lovely009/robot2_ws/ros2_ws/src/robot_description/models/half_body_robot/cad/frames/motor_frames.csv

frame | motor_id | parent | model | status | parent_xyz | parent_rpy | parent_outward_z | base_xyz | base_outward_z | observed_holes | measured_pcd_mm | pcd_error_mm | fit_residual_mm | joint | flange_center_to_joint_axis_mm | axis_angle_deg | axial_offset_mm | outward_vs_joint_sign | clocking_status | encoder_zero | command_direction
motor_01_mount_reference | 1 | base_link | r48 | bolt_circle_verified | [0.06399999999999999, 0.0655, 0.6790000000000002] | [0.0, 0.0, 0.3926981465394346] | [0.0, 0.0, 1.0] | [0.06399999999999999, 0.0655, 0.6790000000000002] | [0.0, 0.0, 1.0] | 8 | 40.500009306216086 | 9.306216082471952e-06 | 4.65310804817487e-06 | joint_link1 | 1.3877787807814457e-14 | 0.0 | -0.300000000000189 | -1 | locator_verified | unverified | unverified
motor_02_mount_reference | 2 | base_link | r48 | bolt_circle_verified | [0.08820000000000003, 0.043000000000000003, 0.5964999859746587] | [-1.5707963267948968, 0.3926982670535939, -1.5707963267948966] | [1.0, 0.0, 0.0] | [0.08820000000000003, 0.043000000000000003, 0.5964999859746587] | [1.0, 0.0, 0.0] | 8 | 40.50000298210565 | 2.982105645754629e-06 | 1.2534288506421687e-05 | joint_link2 | 104.13046176755344 | 87.8887432543599 | -9.423835114816384 | 1 | locator_verified | unverified | unverified
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
