lovely009/robot2_ws/docs/巨蟹电机/CERB巨蟹智能-CANopen-V0.9字典表.xlsx

Sheet: 字典表
--- | 参数字典 | 参数名称 | 主索引 | 子索引 | 权限 | 数据类型 | 默认值（十进制） | 最小值 | 最大值 | 单位 | 说明
0 | Can Node ID | CAN节点ID | 0x2530 | 0x00 | RW | UINT32 | 1 | 1 | 127 | - | 修改完成后需要重启生效;
1 | Can Baudrate | CAN数据段通讯波特率 | 0x2540 | 0x00 | RW | UINT32 | 1 | 1 | 3 | - | 说明：1-5M，2-4M，3-2M，4-1M;
2 | Zero set | 设置电机输出端零位 | 0x2531 | 0x00 | RW | UINT32 | 0 | 0 | 2 | - | 写入零位是电机需要在去使能的状态，写1时设置零位
3 | TorqueFlux_P | 电流环P参数 | 0x2532 | 0x00 | RW | UINT32 | - | 0 | 32768 | -
4 | TorqueFlux_I | 电流环I参数 | 0x2533 | 0x00 | RW | UINT32 | - | 0 | 32768 | -
5 | Velocity_P | 速度环P参数 | 0x2534 | 0x00 | RW | UINT32 | - | 0 | 32768 | -
6 | Velocity_I | 速断环I参数 | 0x2535 | 0x00 | RW | UINT32 | - | 0 | 32768 | -
7 | Position_P | 位置环P参数 | 0x2536 | 0x00 | RW | UINT32 | - | 0 | 32768 | -
8 | Position_I | 位置环I参数 | 0x2537 | 0x00 | RW | UINT32 | - | 0 | 32768 | -
9 | maxTorque | 电机峰值电流 | 0x2538 | 0x00 | RW | UINT32 | - | 0 | 32768 | mA
10 | Flash cobe | Flash保存参数代码 | 0x2539 | 0x00 | RW | UINT32 | 0 | 0 | 4294967295 | - | 说明：1-断电保存设置的电机参数 2-设置电机正限位 4-设置电机负限位
11 | Motion_dir | 电机方向定义 | 0x2541 | 0x00 | RW | UINT32 | 0 | 1 | 0 |  | 说明：0-CW，1-CCW
12 | MOS_Temper | 驱动器温度 | 0x2662 | 0x00 | RO | UINT32 | - | -400 | 1500 | 0.1°
13 | Motor_Temper | 电机线圈温度 | 0x2663 | 0x00 | RO | UINT32 | - | -400 | 1500 | 0.1°
14 | Error Code | 错误码 | 0x603F | 0x00 | RO | UNS16 | 0 | 0 | 65535 | - | 参考错误代码表
15 | DS402 Controlword | 402控制字 | 0x6040 | 0x00 | RW | UNS16 | 0 | 0 | 65535 | -
16 | DS402 Statusword | 402状态字 | 0x6041 | 0x00 | RO | UNS16 | 0 | 0 | 65535
17 | Torque Target Value | 电流环目标值 | 0x6071 | 0x00 | RW | INTEGER16 | 0 | -32768 | 32767 | mA
18 | Current Actual Value | 电流当前值 | 0x6078 | 0x00 | RO | INTEGER16 | 0 | -32768 | 32767 | mA
19 | Bus Voltage Actual Value | 母线电压当前值 | 0x6079 | 0x00 | RO | UNS32 | 0 | 0 | 4294967295 | 0.1V
20 | Load Position Target Value | 负载端位置目标值 | 0x607A | 0x00 | RW | INTEGER32 | 0 | -32767 | 32768 | cnt
21 | Load Position Lower Limit | 负载位置下限 | 0x607D | 0x01 | RW | INTEGER32 | -32767 | -32767 | 32768 | cnt
22 | Load Position Upper Limit | 负载位置上限 | 0x607D | 0x02 | RW | INTEGER32 | 32768 | -32767 | 32768 | cnt
23 | Motor Maximum Speed RPM | 电机最大转速/速度(RPM) | 0x6080 | 0x00 | RW | UNS32 | 2000 | 1 | 4294967295 | RPM
24 | Profile Velocity | 负载端轮廓速度 | 0x6081 | 0x00 | RW | UNS32 | 10 | 1 | 40 | RPM | 该改速度为输出端的速度
25 | Profle Acceleration | 轮廓加速度 | 0x6083 | 0x00 | RW | UNS32 | 50 | 1 | 200 | RPM/S
26 | Profile Deceleration | 轮廓减速度 | 0x6084 | 0x00 | RW | UNS32 | 50 | 1 | 200 | RPM/S
27 | Operation Mode Command | 运行模式指令 | 0x6060 | 0x00 | RW | INTEGER8 | 0 | -128 | 127 | - | 说明：1-轮廓位置模式，3-轮廓速度模式，8周期同步位置模式，9周期同步速度模式，10周期同步电流模式
28 | Operation Mode Command display | 当前运行模式指令 | 0x6060 | 0x00 | RW | INTEGER8 | 0 | -128 | 127 | -
29 | Velocity Target Value | 速度目标值 | 0x60FF | 0x00 | RW | INTEGER32 | 0 | -2147483648 | 2147483647 | RPM
30 | Velocity Actual Value | 电机端速度当前值 | 0x606C | 0x00 | RO | INTEGER32 | 0 | -2147483648 | 2147483647 | RPM
31 | Load Position Actual Value | 负裁端位置当前值 | 0x6064 | 0x00 | RO | INTEGER32 | 0 | -32767 | 32768 | cnt
32 | torque actual value | 力矩传感器当前值 | 0x6077 | 0x00 | RO | INTEGER16 | 0 | -32767 | 32768 | 0.01N.m
33 | Load Position Error Value | 负端位置误差值 | 0x60F4 | 0x00 | RO | INTEGER32 | 0 | -32767 | 32768 | cnt

Sheet: 字典操作示例
SDO控制举例,以电机ID为1为例 |  |  |  |  | SDO读取反馈状态举例，以电机ID为1为例
位置模式举例 位置环的速度是减速机的输出端速度 |  |  |  |  | 读取运动状态
使能电机： |  |  |  |  | ID | DLC | Data(HEX) | Description
ID | DLC | Data(HEX) | Description | 范围限制 | 601 | 8 | 40 78 60 00 00 00 00 00 | 读取电机实际电流
601 | 8 | 2B 40 60 00 06 00 00 00 | 准备好启动 |  | 581 | 8 | 4B 78 60 00 94 FE 00 00 | 反馈电机实际电流
601 | 8 | 2B 40 60 00 07 00 00 00 | 松开抱闸 |  | 601 | 8 | 40 64 60 00 00 00 00 00 | 读取电机实际位置
601 | 8 | 2B 40 60 00 0F 00 00 00 | 电机使能激活 |  | 581 | 8 | 43 64 60 00 00 00 00 00 | 反馈电机实际位置
设置运动模式： |  |  |  |  | 601 | 8 | 40 6C 60 00 00 00 00 00 | 读取电机实际速度
601 | 8 | 2F 60 60 00 01 00 00 00 | 设置位置模式 |  | 581 | 8 | 43 6C 60 00 00 00 00 00 | 反馈电机实际速度
设置运动参数： |  |  |  |  | 601 | 8 | 40 6C 60 00 00 00 00 00 | 读取电机实际速度
601 | 8 | 23 83 60 00 D0 07 00 00 | 设置加速度为2000(RPM/S) | 0~10000 | 581 | 8 | 43 6C 60 00 00 00 00 00 | 反馈电机实际速度
601 | 8 | 23 84 60 00 D0 07 00 00 | 设置减速度为2000(RPM/S) | 0~10000 | 601 | 8 | 40 3F 60 00 00 00 00 00 | 读取电机故障
601 | 8 | 23 81 60 00 0A 00 00 00 | 设置速度为10(RPM) | 0~30 | 581 | 8 | 4B 3F 60 00 00 00 00 00 | 反馈电机故障 | 0x0001:过压 0x0002：欠压 0x0004：过温报错 0x0008：堵转 0x0010：过载 0x0020：电流采样错误 0x0040：正限位保护 0x0080：负限位保护 0x0100：编码器通信超时 0x0200：电机超过最大速度 0x0400：上电电角度初始化失败 0x1000：位置误差过大 0x2000：编码器故障
绝对运动： |  |  |  |  | 601 | 8 | 40 41 60 00 00 00 00 00 | 读取电机运动状态
601 | 8 | 23 7A 60 00 00 40 00 00 | 设置目标位置范围 | -32767 ~32768（对应角度-180~180） | 581 | 8 | 4B 41 60 00 00 00 00 00 | 反馈电机运动状态 | 0x0021:准备好启动 0x0023：松开抱闸 0x0027：使能激活 0x0427：运行到位 0x0008：报错状态
601 | 8 | 2B 40 60 00 4F 00 00 00 | 电机开始绝对运动 |  | 601 | 8 | 40 63 26 00 00 00 00 00 | 读取力矩传感器 | 0.001Nm
停止运动： |  |  |  |  | 581 | 8 | 43 63 26 00 1D 00 00 00 | 反馈力矩传感器
601 | 8 | 2B 40 60 00 0F 00 00 00 | 电机停止运动 |  | 601 | 8 | 40 62 26 00 00 00 00 00 | 读取温度传感器
 |  |  |  |  | 581 | 8 | 43 62 26 00 18 01 00 00 | 反馈温度传感器 | 28.0°
速度模式举例 速度环的速度与加速度是电机端的速度
使能电机：
ID | DLC | Data(HEX) | Description
601 | 8 | 2B 40 60 00 06 00 00 00 | 准备好启动
601 | 8 | 2B 40 60 00 07 00 00 00 | 松开抱闸
601 | 8 | 2B 40 60 00 0F 00 00 00 | 电机使能激活
设置运动模式：
601 | 8 | 2F 60 60 00 03 00 00 00 | 设置速度模式
设置运动参数：
601 | 8 | 23 83 60 00 E8 03 00 00 | 设置加速度为1000(RPM/S) | 0~10000
601 | 8 | 23 84 60 00 E8 03 00 00 | 设置减速度为1000(RPM/S) | 0~10000
601 | 8 | 23 FF 60 00 F4 01 00 00 | 设置速度为500(RPM) | -3000~3000
电流模式举例 最大电流建议用默认（与电机峰值电流保持）
使能电机：
ID | DLC | Data(HEX) | Description
601 | 8 | 2B 40 60 00 06 00 00 00 | 准备好启动
601 | 8 | 2B 40 60 00 07 00 00 00 | 松开抱闸
601 | 8 | 2B 40 60 00 0F 00 00 00 | 电机使能激活
设置运动模式：
601 | 8 | 2F 60 60 00 0A 00 00 00 | 设置电流模式
设置运动参数：
601 | 8 | 2B 71 60 00 F4 01 00 00 | 设置目标电流为500(mA) | -10000~10000（根据电机型号）
修改电机ID举例
ID | DLC | Data(HEX) | Description
601 | 8 | 23 30 25 00 05 00 00 00 | 设置电机ID为5
设置电机零位
ID | DLC | Data(HEX) | Description
601 | 8 | 23 31 25 00 01 00 00 00 | 设置零位 | 设置时电机需要在失能状态
设置电机正限位
ID | DLC | Data(HEX) | Description
601 | 8 | 23 39 25 00 02 00 00 00 | 设置正限位 | 设置时电机失能状态，掰到正限位再设置（默认参数：-180到180）
设置电机负限位
ID | DLC | Data(HEX) | Description
601 | 8 | 23 39 25 00 04 00 00 00 | 设置负限位 | 设置时电机失能状态，掰到负限位再设置（默认参数：-180到180）
设置电机电流环P
ID | DLC | Data(HEX) | Description
601 | 8 | 23 32 25 00 00 00 00 00 | 设置电机电流环P
设置电机电流环I
ID | DLC | Data(HEX) | Description
601 | 8 | 23 33 25 00 00 00 00 00 | 设置电机电流环I
设置电机速度环P
ID | DLC | Data(HEX) | Description
601 | 8 | 23 34 25 00 00 00 00 00 | 设置电机速度环P
设置电机速度环I
ID | DLC | Data(HEX) | Description
601 | 8 | 23 35 25 00 00 00 00 00 | 设置电机速度环I
设置电机位置环P
ID | DLC | Data(HEX) | Description
601 | 8 | 23 36 25 00 00 00 00 00 | 设置电机位置环P
设置电机位置环I
ID | DLC | Data(HEX) | Description
601 | 8 | 23 37 25 00 00 00 00 00 | 设置电机位置环I
设置电机最大电流
ID | DLC | Data(HEX) | Description
601 | 8 | 23 38 25 00 00 00 00 00 | 设置电机最大电流
将写入的PI和最大电流保存FLASH
ID | DLC | Data(HEX) | Description
601 | 8 | 23 39 25 00 01 00 00 00 | 写入FLASH
设置心跳
ID | DLC | Data(HEX) | Description
601 | 8 | 2B 17 10 00 D0 07 00 00 | 设置心跳时间2000ms | 设置为0时关闭心跳
关闭看门狗和限位保护
ID | DLC | Data(HEX) | Description
601 | 8 | 23 50 26 00 01 00 00 00 | 关闭看门狗和限位保护
清除错误
ID | DLC | Data(HEX) | Description
601 | 8 | 2B 40 60 00 80 00 00 00 | 清错
说明：标红色字体及为设置的目标值，数据高位在后，低位在前

Sheet: SDO协议内容详解
以主站下发到从站，修改电机ID举例说明
CAN帧 | 字段名称 | 字节长度 | 内容说明
StdID | 设备地址 | 11bit | 600|Dev_ID
DLC | 帧长度 | / | 0x08
[0] | 指令代码 | 16bit | 参考指令代码说明
[1] | 字典索引 | 32bit | 参考字典表
[2]
[3] | 子索引 | 16bit
[4] | 需要修改的DI号 | 32bit | ID的范围为：1~127 数据地位在前，高位在后
[5]
[6]
[7]

Sheet: CANFD的自定义的PDO控制协议
CANFD默认配置为：CANFD加速 标准帧 1M仲裁段 5M数据段
执行器反馈报文
三种方式触发执行器反馈报文： 1、发送同步帧（上位发送同步报文ID：0x80）； 2、执行器多控报文触发执行器的数据反馈； 3、单轴控报文触发执行器的数据反馈；
执行器发给上位机 带力矩传感器
CAN帧 |  | 字段名称 | 字节 | 内容说明（数据）
StdID |  | 设备地址 | 11bit | 0x300|Dev_ID
DLC |  | 帧长度 |  | 16
[0] |  | 负载端实际位置 | 16bit | Byte[0]为高8位，Byte[1]为低8位;[-32768到32767]对应(-180°~ 180°);
[1]
[2] |  | 电机端实际速度 | 16bit | Byte[2]为高8位，Byte[3]为低8位;int16类型[-32768到32767]，单位：RPM;
[3]
[4] |  | 实际电流（Iq） | 16bit | Byte[4]为高8位，Byte[5]为低8位;int16类型[-32768到32767]，单位：mA;
[5]
[6] |  | 错误代码 | 16bit | Byte[6]为高8位，Byte[7]为低8位;参考报错代码表
[7]
[8] |  | 电机线圈温度 | 16bit | Byte[8]为高8位，Byte[9]为低8位;int16类型，单位：0.1度;
[9]
[10] |  | 力矩反馈 | 16bit | Byte[10]为高8位，Byte[11]为低8位;int16类型，单位：0.05Nm;
[11]
[12] |  | 预留 | 16bit | 保留
[13]
[14] |  | 控制模式反馈 | 8bit | 0x01：轮廓位置模式；0x02：轮廓速度模式； 0x03：CSP位置模式；0x04：CSV速度模式； 0x05：电流环模式；0x06：力矩环模式；
[15] | Bit[7] | 使能状态 | 1bit | 0x00：下使能 0x01：上使能
 | Bit[6] | 抱闸状态 | 1bit | 0x00：抱闸吸合 0x01：抱闸释放
 | Bit[5] | 报错状态 | 1bit | 0x00：正常状态 0x01：报错状态
 | Bit[4] | 位置到位状态 | 1bit | 0x00：运行中 0x01：运行到位
 | Bit[3~0] | 预留
执行器发给上位机
CAN帧 |  | 字段名称 | 字节 | 内容说明（数据）
StdID |  | 设备地址 | 11bit | 0x300|Dev_ID
DLC |  | 帧长度 |  | 12
[0] |  | 负载端实际位置 | 16bit | Byte[0]为高8位，Byte[1]为低8位;[-32768到32767]对应(-180°~ 180°);
[1]
[2] |  | 电机端实际速度 | 16bit | Byte[2]为高8位，Byte[3]为低8位;int16类型[-32768到32767]，单位：RPM;
[3]
[4] |  | 实际电流（Iq） | 16bit | Byte[4]为高8位，Byte[5]为低8位;int16类型[-32768到32767]，单位：mA;
[5]
[6] |  | 错误代码 | 16bit | Byte[6]为高8位，Byte[7]为低8位;参考报错代码表
[7]
[8] |  | 电机线圈温度 | 16bit | Byte[8]为高8位，Byte[9]为低8位;int16类型，单位：0.1度;
[9]
[10] |  | 控制模式反馈 | 8bit | 0x01：轮廓位置模式；0x02：轮廓速度模式； 0x03：CSP位置模式；0x04：CSV速度模式； 0x05：电流环模式；0x06：力矩环模式；
[11] | Bit[7] | 使能状态 | 1bit | 0x00：下使能 0x01：上使能
 | Bit[6] | 抱闸状态 | 1bit | 0x00：抱闸吸合 0x01：抱闸释放
 | Bit[5] | 报错状态 | 1bit | 0x00：正常状态 0x01：报错状态
 | Bit[4] | 位置到位状态 | 1bit | 0x00：运行中 0x01：运行到位
 | Bit[3~0] | 预留
单执行器控制报文
功能用于单独控制指定电机
上位机发给执行器 |  |  |  |  | 单轴控制报文举例（以ID为7的电机举例）
CAN帧 |  | 字段名称 | 字节 | 内容说明（数据） | 1、电机使能，抱闸释放，轮廓位置模式，轮廓速度5RPM，加减速2000RPM/S，运行到0度位置 |  | 2、电机使能，抱闸释放，轮廓位置模式，轮廓速度8RPM，加减速1000RPM/S，运行到90度位置 |  | 3、电机使能，抱闸释放，轮廓位置模式，轮廓速度8RPM，加减速1000RPM/S，运行到-90度位置 |  | 4、电机使能，抱闸释放，轮廓速度模式，轮廓速度500RPM，加减速1000RPM/S |  | 5、电机使能，抱闸释放，电流环模式，目标电流1000mA |  | 6、电机使能，抱闸释放，力矩环模式，目标力矩20Nm
StdID |  | 设备地址 | 11bit | 0x100|Dev_ID | 0x107 |  | 0x107 |  | 0x107 |  | 0x107 |  | 0x107 |  | 0x107
DLC |  | 帧长度 |  | 7 | 7 |  | 7 |  | 7 |  | 7 |  | 7 |  | 7
[0] | Bit[7] | 使能控制 | 1bit | 0x00：下使能 0x01：上使能 | 1 | 电机使能 | 1 | 电机使能 | 1 | 电机使能 | 1 | 电机使能 | 1 | 电机使能 | 1 | 电机使能
 | Bit[6] | 抱闸控制 | 1bit | 0x00：抱闸吸合 0x01：抱闸释放 | 1 | 抱闸释放 | 1 | 抱闸释放 | 1 | 抱闸释放 | 1 | 抱闸释放 | 1 | 抱闸释放 | 1 | 抱闸释放
 | Bit[5] | 清楚错误控制 | 1bit | 0：默认 1：复位错误 | 0 | 默认 | 0 | 默认 | 0 | 默认 | 0 | 默认 | 0 | 默认 | 0 | 默认
 | Bit[4~1] | 控制模式 | 4bit | 0x01：轮廓位置模式；0x02：轮廓速度模式； 0x03：CSP位置模式；0x04：CSV速度模式； 0x05：电流环模式；0x06：力矩环模式； | 1 | 轮廓位置模式 | 1 | 轮廓位置模式 | 1 | 轮廓位置模式 | 2 | 轮廓速度模式 | 5 | 电流环模式 | 6 | 力矩环模式
 | Bit[0] | 预留 |  |  | 0 |  | 0 |  | 0 |  | 0 |  | 0 |  | 0
[1] |  | 目标参数1 | 16bit | Byte[1]为高8位，Byte[2]为低8位： 1、当控制模式为位置模式时（0x01，0x03），对应为输出端目标位置，范围是[-32768到32767]对应(-180°~ 180°); 2、当控制模式为速度模式时（0x02，0x04），对应为电机端的目标速度，范围是[-32768到32767]，单位：RPM; 3、当控制模式为电流模式时（0x05），对应为电机目标Iq电流，范围是[-32768到32767]，单位：mA; 4、当控制模式为力矩模式时（0x06），对应为电机目标力矩，范围是[-32768到32767]，单位：0.1Nm; | 0x0000 | 位置0度（0cnt） | 0x4000 | 位置90度（16384cnt） | 0xC000 | 位置90度（-16384cnt） | 0x01F4 | 轮廓速度500RPM | 0x03E8 | 目标电流1000mA | 0x00C8 | 目标力矩20Nm
[2]
[3] |  | 目标参数2 | 16bit | Byte[3]为高8位，Byte[4]为低8位; 1、当控制模式为轮廓位置模式与轮廓速度模式时（0x01，0x02），对应为轮廓的加减速，范围是[0到20000]，单位：RPM/S; | 0x07D0 | 轮廓加减速2000RMP/S | 0x03E8 | 轮廓加减速1000RMP/S | 0x03E8 | 轮廓加减速1000RMP/S | 0x03E8 | 轮廓加减速1000RMP/S | 0x0000 | 任意值 | 0x0000 | 任意值
[4]
[5] |  | 目标前馈参数 | 16bit | Byte[5]为高8位，Byte[6]为低8位; 1、前馈参数的预留； 2、当控制模式为位置模式时（0x01），对应为输出端的轮廓速度； | 0x0005 | 输出端速度5RPM | 0x0008 | 输出端速度8RPM | 0x0008 | 输出端速度8RPM | 0x0000 | 任意值 | 0x0000 | 任意值 | 0x0000 | 任意值
[6]
执行器多控报文
功能用于广播指令同时控制最多8个电机
上位机发给执行器
CAN帧 |  | 字段名称 | 字节 | 内容说明（数据）
StdID |  | 设备地址 | 11bit | 0x200
DLC |  | 帧长度 |  | 64
[0]~[6] |  | 控制指令分包1 | 112bit | 与单轴控制报文协议保持一直
[7]~[13] |  | 控制指令分包2 | 112bit
[14]~[20] |  | 控制指令分包3 | 112bit
[21]~[27] |  | 控制指令分包4 | 112bit
[28]~[34] |  | 控制指令分包5 | 112bit
[35]~[41] |  | 控制指令分包6 | 112bit
[42]~[48] |  | 控制指令分包7 | 112bit
[49]~[55] |  | 控制指令分包8 | 112bit
[56] |  | 控制指令分包1_对应执行器ID号 | 8bit | 对应执行器的ID（Dev_ID）
[57] |  | 控制指令分包2_对应执行器ID号 | 8bit
[58] |  | 控制指令分包3_对应执行器ID号 | 8bit
[59] |  | 控制指令分包4_对应执行器ID号 | 8bit
[60] |  | 控制指令分包5_对应执行器ID号 | 8bit
[61] |  | 控制指令分包6_对应执行器ID号 | 8bit
[62] |  | 控制指令分包7_对应执行器ID号 | 8bit
[63] |  | 控制指令分包8_对应执行器ID号 | 8bit
MIT模式下单执行器控制报文
功能用于单独MIT模式控制指定电机
上位机发给执行器
CAN帧 |  | 字段名称 | 字节 | 内容说明（数据）
StdID |  | 设备地址 | 11bit | 0x110|Dev_ID
DLC |  | 帧长度 |  | 9
[0] | Bit[7] | 使能控制 | 1bit | 0x00：下使能 0x01：上使能
 | Bit[6] | 抱闸控制 | 1bit | 0x00：抱闸吸合 0x01：抱闸释放
 | Bit[5] | 清楚错误控制 | 1bit | 0：默认 1：复位错误
 | Bit[4:1] | 控制模式 | 4bit | 0x06：MIT模式；
 | Bit[0] | 预留
[1] |  | 目标位置 | 16bit | Byte[0]为高8位，Byte[1]为低8位; [0-65535]对应(-Pos Max~ Pos Max);
[2]
[3] |  | 目标速度 | 12bit | Byte[2]为高8位，Byte[3]-Bit[7:4]为低4位; [0~4095]对应(-Vel Max~Vel Max);
[4] | Bit[7:4]
 | Bit[3:0] | 位置增益 Kp 值 | 12bit | Byte[3]-Bit[3:0]为高4位，Byte[4]为低8位; [0~4095]对应[0~500];
[5]
[6] |  | 速度增益 Kd 值 | 12bit | Byte[5]为高8位，Byte[6]-Bit[7:4]为低4位[0~4095]对应[0~5];
[7] | Bit[7:4]
 | Bit[3:0] | 目标力矩 | 12bit | Byte[6]-Bit[3:0]为高4位，Byte[7]为低8位[0~4095]对应(-T_Max~T_Max);
[8]
MIT模式下执行器多控报文
功能用于广播指令同时MIT模式控制最多6个电机
上位机发给执行器
CAN帧 |  | 字段名称 | 字节 | 内容说明（数据）
StdID |  | 设备地址 | 11bit | 0x210
DLC |  | 帧长度 |  | 64
[0]~[8] |  | 控制指令分包1 | 144bit | 与MIT模式单轴控制报文协议保持一直
[9]~[18] |  | 控制指令分包2 | 144bit
[19]~[27] |  | 控制指令分包3 | 144bit
[28]~[36] |  | 控制指令分包4 | 144bit
[37]~[45] |  | 控制指令分包5 | 144bit
[46]~[54] |  | 控制指令分包6 | 144bit
[56] |  | 控制指令分包1_对应执行器ID号 | 8bit | 对应执行器的ID（Dev_ID）
[57] |  | 控制指令分包2_对应执行器ID号 | 8bit
[58] |  | 控制指令分包3_对应执行器ID号 | 8bit
[59] |  | 控制指令分包4_对应执行器ID号 | 8bit
[60] |  | 控制指令分包5_对应执行器ID号 | 8bit
[61] |  | 控制指令分包6_对应执行器ID号 | 8bit
[62] |  | 控制指令分包7_对应执行器ID号 | 8bit
[63] |  | 控制指令分包8_对应执行器ID号 | 8bit
