lovely009/robot2_ws/ros2_ws/src/robot_description/models/full_body_robot/cad/meshes/Joint_link3.3.STL

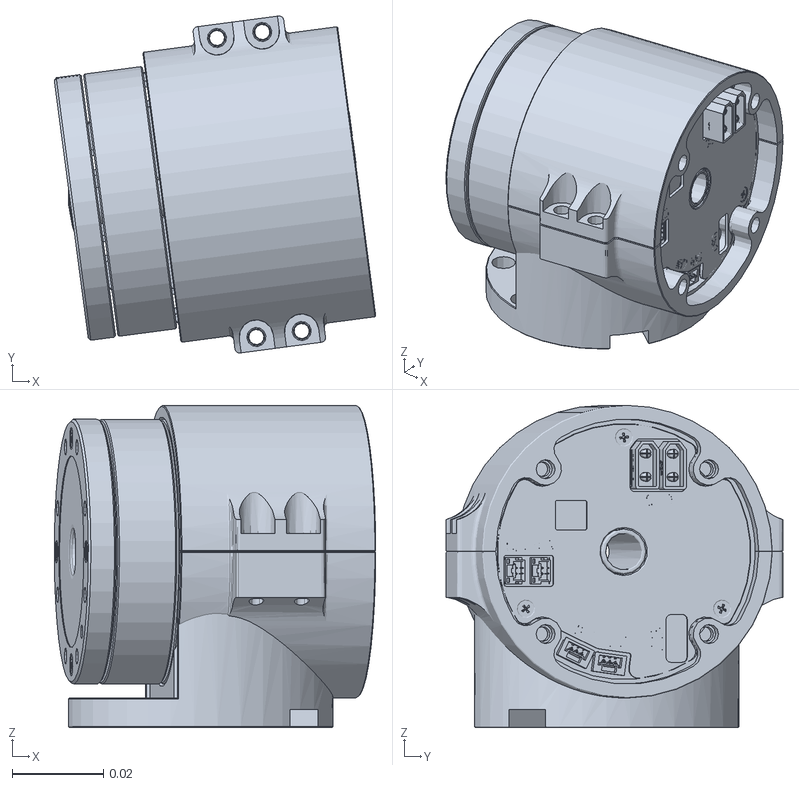
[picture p5: CAD file, 2026-11-04]
ros2_ws/src/robot_description/models/full_body_robot/cad/meshes/Joint_link3.3.STL
0.0703 x 0.0737 x 0.0705
