lovely009/robot2_ws/ros2_ws/src/robot_description/models/full_body_robot/meshes/Joint_link5.5r.STL

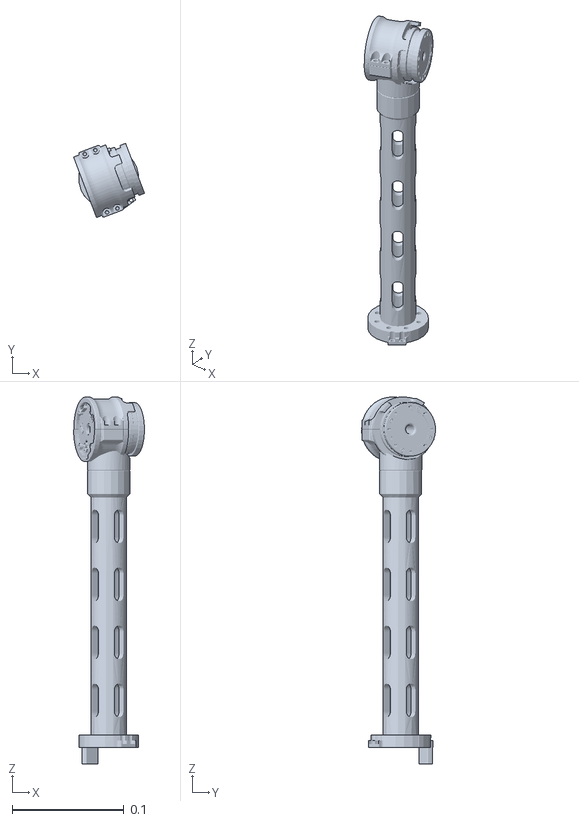
[picture p6: CAD file, 2026-11-04]
ros2_ws/src/robot_description/models/full_body_robot/meshes/Joint_link5.5r.STL
0.0635 x 0.0664 x 0.329
