lovely009/robot2_ws/ros2_ws/src/robot_description/models/half_body_robot/meshes/base_link_simplified.STL

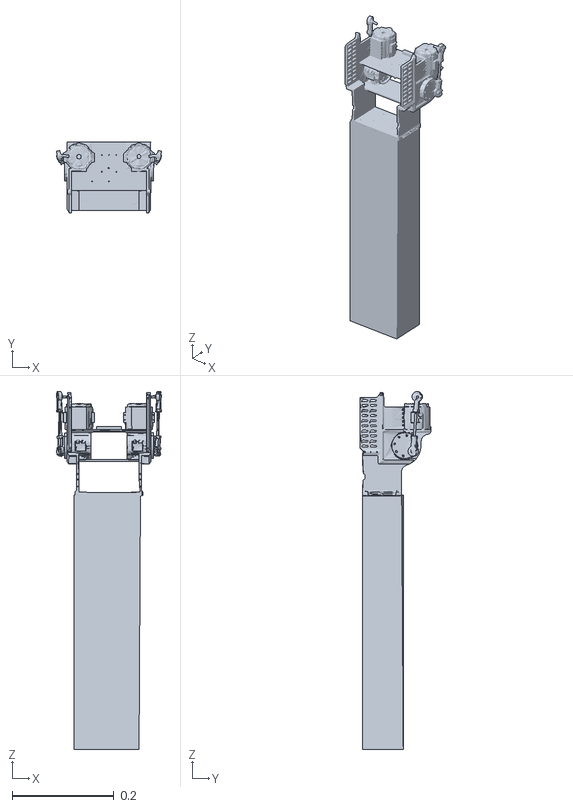
[picture p7: CAD file, 2026-11-03]
ros2_ws/src/robot_description/models/half_body_robot/meshes/base_link_simplified.STL
0.207 x 0.139 x 0.703
