lovely009/robot2_ws/ros2_ws/src/robot_description/models/half_body_robot/meshes/collision/Joint_link4.4.STL

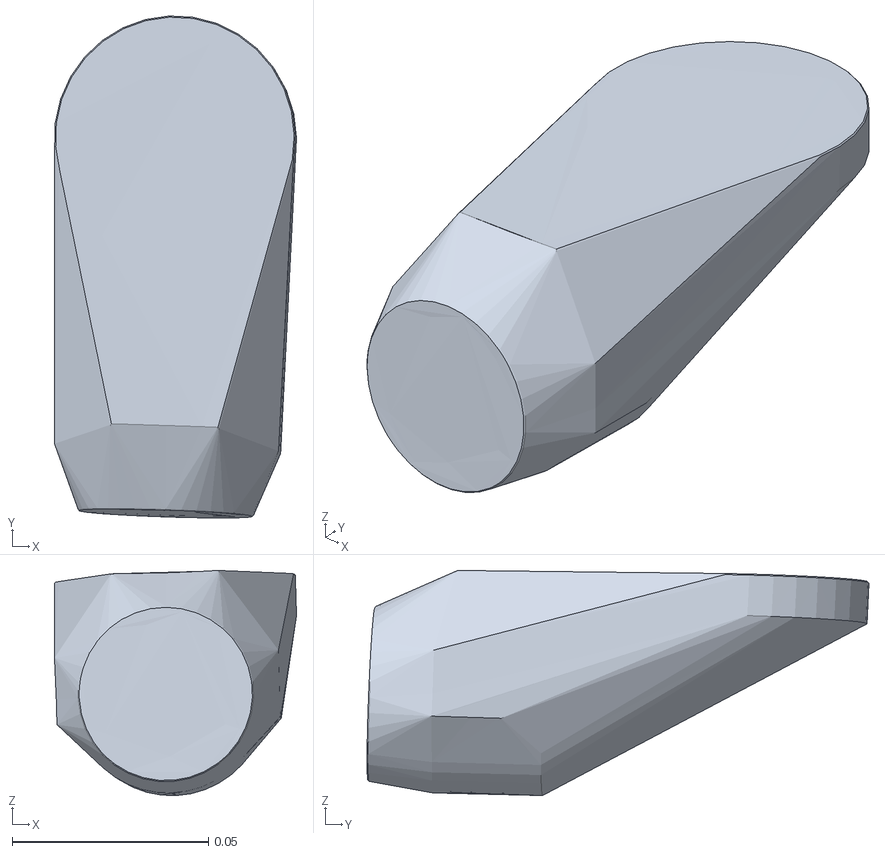
[picture p8: CAD file, 2026-11-03]
ros2_ws/src/robot_description/models/half_body_robot/meshes/collision/Joint_link4.4.STL
0.0617 x 0.128 x 0.0574
