lovely009/robot2_ws/ros2_ws/src/robot_description/models/right_arm_4dof/cad/meshes/base_link.STL

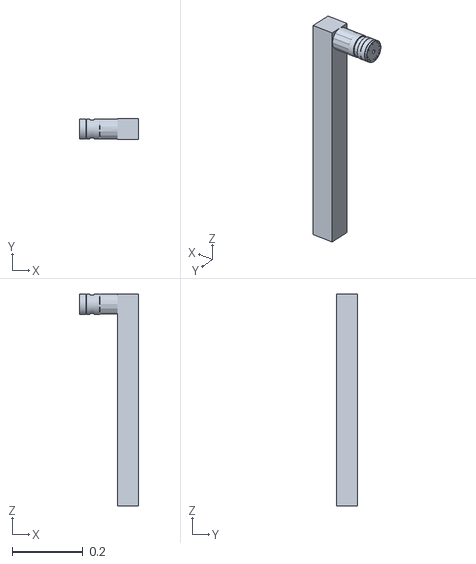
[picture p9: CAD file, 2026-11-04]
ros2_ws/src/robot_description/models/right_arm_4dof/cad/meshes/base_link.STL
0.168 x 0.06 x 0.6
