lovely009/robot2_ws/ros2_ws/src/robot_description/models/right_arm_4dof/meshes/Joint_link5.STL

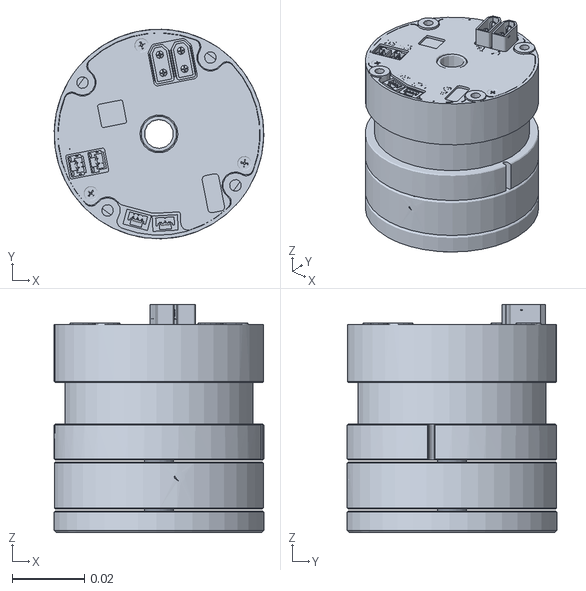
[picture p10: CAD file, 2026-11-04]
ros2_ws/src/robot_description/models/right_arm_4dof/meshes/Joint_link5.STL
0.058 x 0.058 x 0.0631
