lovely009/robot2_ws/ros2_ws/src/robot_description/models/robot_leg/meshes/Joint_link6.STL

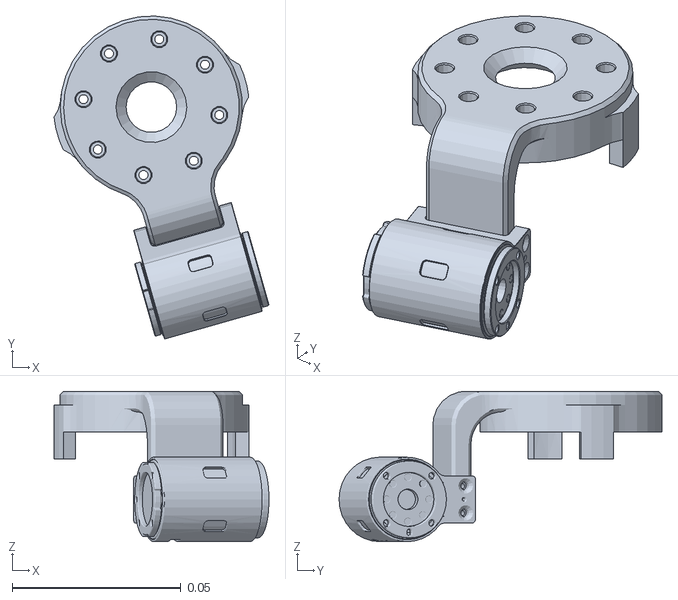
[picture p11: CAD file, 2026-11-03]
ros2_ws/src/robot_description/models/robot_leg/meshes/Joint_link6.STL
0.0637 x 0.0956 x 0.0445
