lovely009/robot2_ws/ros2_ws/src/robot_description/models/robot_waist/meshes/Joint_Link4.STL

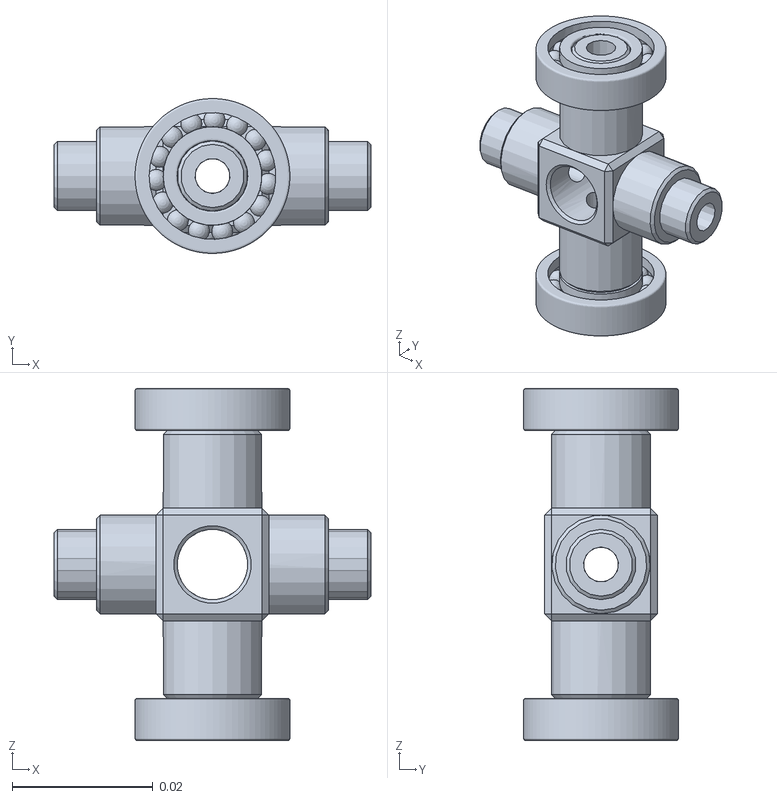
[picture p12: CAD file, 2026-11-03]
ros2_ws/src/robot_description/models/robot_waist/meshes/Joint_Link4.STL
0.045 x 0.022 x 0.05
