lovely009/robot2_ws/ros2_ws/src/robot_description/models/zhoubuguanjie_youbi_001/meshes/collision/Joint_link1.STL

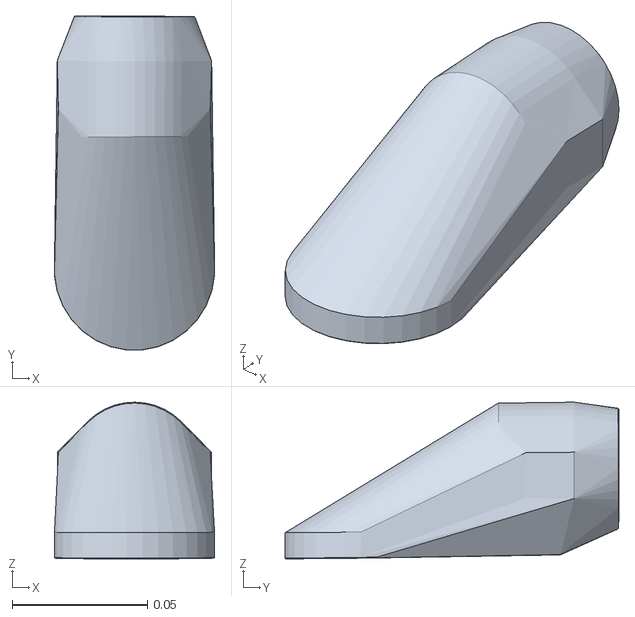
[picture p13: CAD file, 2026-11-03]
ros2_ws/src/robot_description/models/zhoubuguanjie_youbi_001/meshes/collision/Joint_link1.STL
0.0594 x 0.124 x 0.058
