lovely009/robot2_ws/ros2_ws/src/robot_description/models/zhoubuguanjie_youbi_001/meshes/Joint_link4.STL

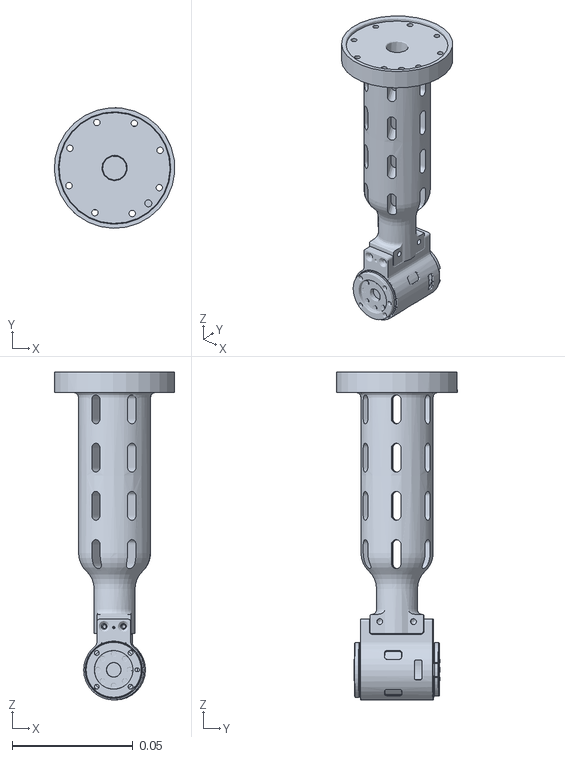
[picture p14: CAD file, 2026-11-03]
ros2_ws/src/robot_description/models/zhoubuguanjie_youbi_001/meshes/Joint_link4.STL
0.0499 x 0.05 x 0.136
