lovely009/robot2_ws/ros2_ws/src/robot_sim/models/half_body_robot/cad/meshes/Joint_link1.1.STL

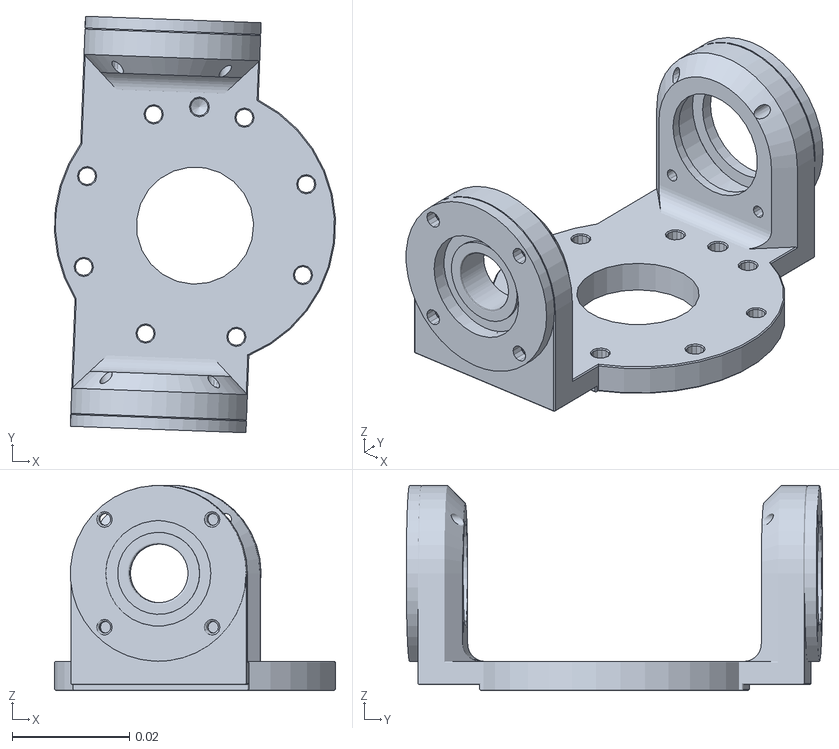
[picture p15: CAD file, 2026-10-26]
ros2_ws/src/robot_sim/models/half_body_robot/cad/meshes/Joint_link1.1.STL
0.0479 x 0.0711 x 0.035
