lovely009/robot2_ws/ros2_ws/src/robot_sim/models/half_body_robot/meshes/collision/Joint_link2.STL

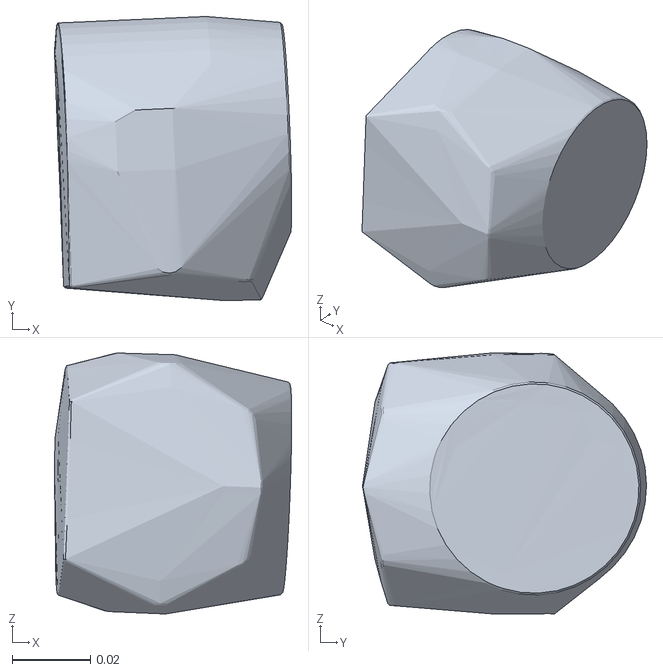
[picture p16: CAD file, 2026-10-26]
ros2_ws/src/robot_sim/models/half_body_robot/meshes/collision/Joint_link2.STL
0.0608 x 0.0727 x 0.0668
