lovely009/robot2_ws/ros2_ws/src/robot_sim/models/half_body_robot/meshes/Joint_link3.3.STL

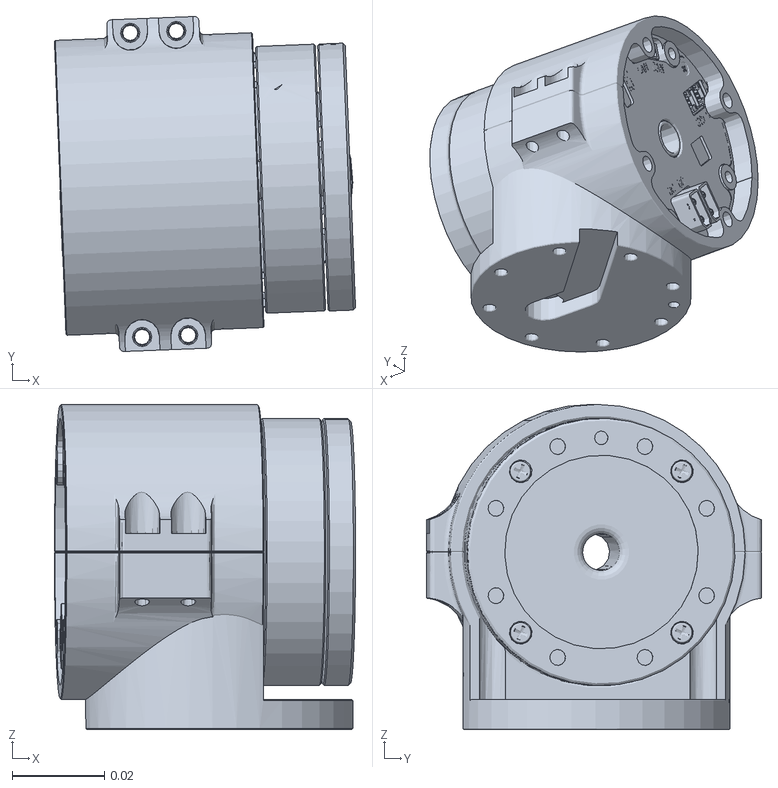
[picture p17: CAD file, 2026-10-26]
ros2_ws/src/robot_sim/models/half_body_robot/meshes/Joint_link3.3.STL
0.0653 x 0.0726 x 0.0705
