lovely009/robot2_ws/ros2_ws/src/robot_sim/models/robot_leg/meshes/collision/Joint_link3.STL

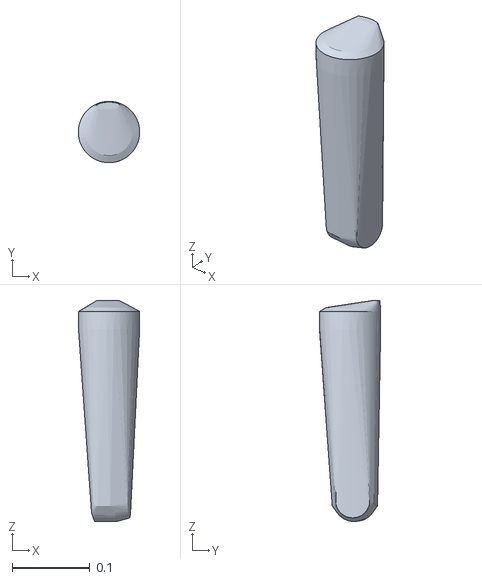
[picture p18: CAD file, 2026-10-26]
ros2_ws/src/robot_sim/models/robot_leg/meshes/collision/Joint_link3.STL
0.0789 x 0.079 x 0.284
