lovely009/robot2_ws/ros2_ws/src/robot_sim/models/robot_waist/cad/meshes/Joint_Link5.STL

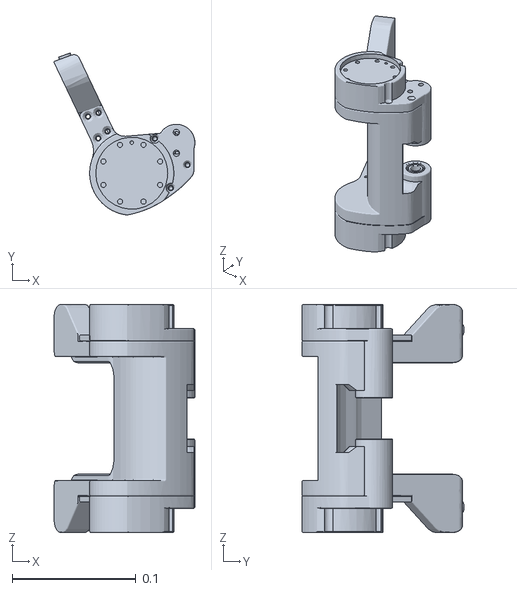
[picture p19: CAD file, 2026-10-26]
ros2_ws/src/robot_sim/models/robot_waist/cad/meshes/Joint_Link5.STL
0.114 x 0.131 x 0.184
