lovely009/robot2_ws/ros2_ws/src/robot_sim/models/robot_waist/meshes/base_link.STL

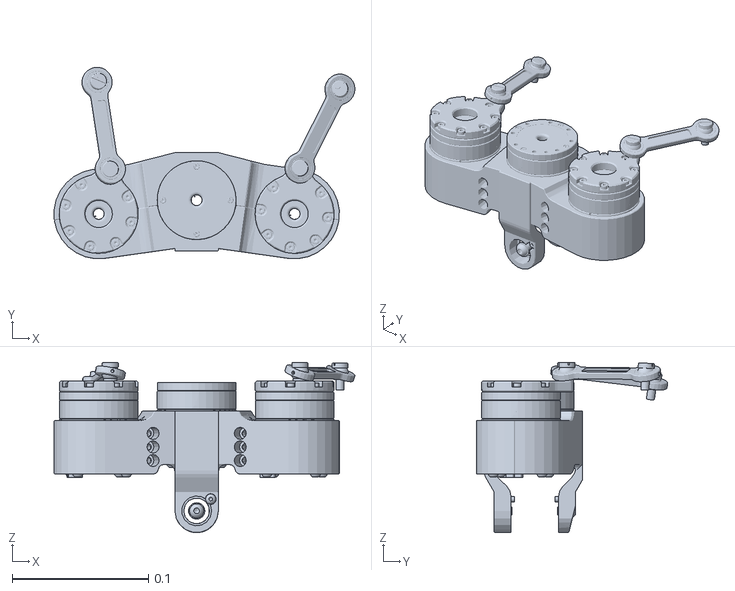
[picture p20: CAD file, 2026-10-26]
ros2_ws/src/robot_sim/models/robot_waist/meshes/base_link.STL
0.221 x 0.141 x 0.125
