lovely009/robot2_ws/ros2_ws/src/robot_sim/models/zhoubuguanjie_youbi_001/meshes/collision/Joint_link2.STL

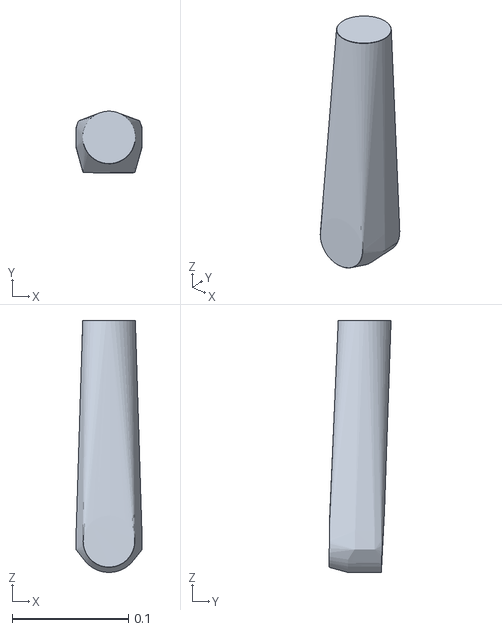
[picture p21: CAD file, 2026-10-26]
ros2_ws/src/robot_sim/models/zhoubuguanjie_youbi_001/meshes/collision/Joint_link2.STL
0.057 x 0.053 x 0.216
