lovely009/robot2_ws/ros2_ws/src/robot_description/models/full_body_robot/cad/meshes/Joint_link5.4.STL

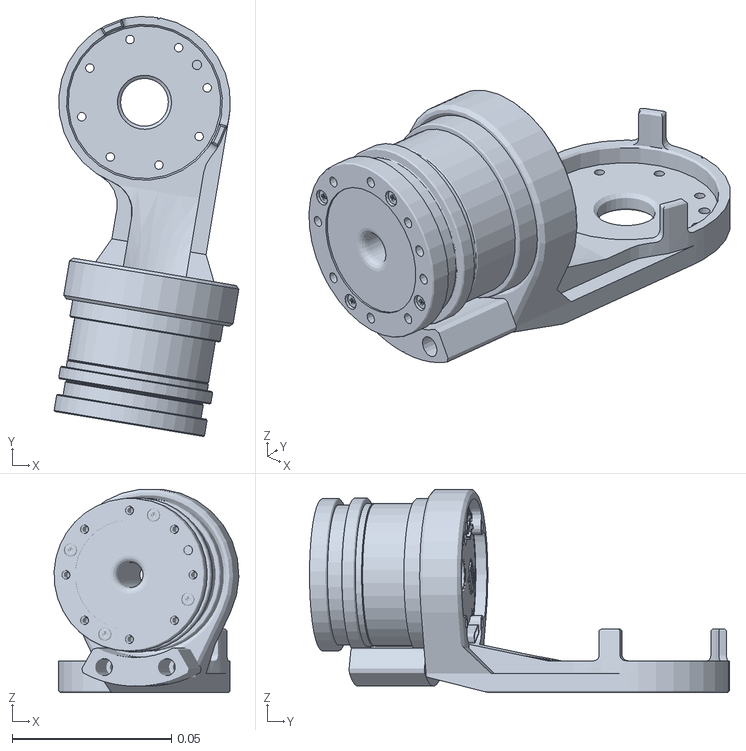
[picture p22: CAD file, 2026-11-04]
ros2_ws/src/robot_description/models/full_body_robot/cad/meshes/Joint_link5.4.STL
0.0581 x 0.132 x 0.0638
