lovely009/robot2_ws/ros2_ws/src/robot_description/models/full_body_robot/meshes/Joint_link3.5.STL

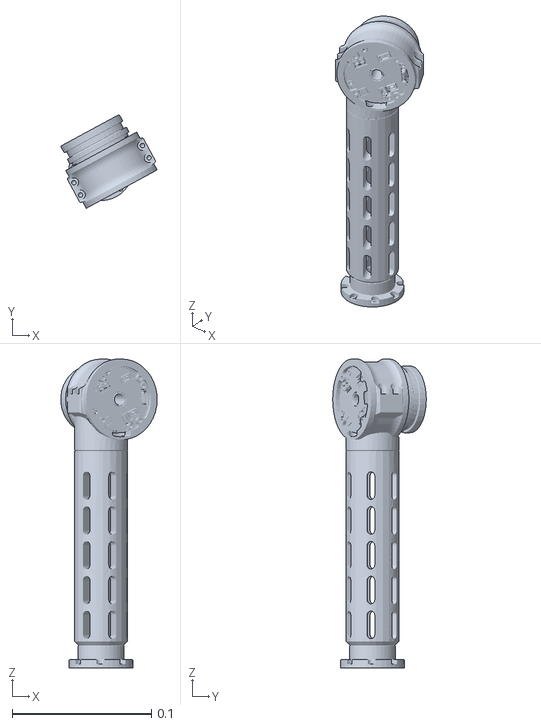
[picture p23: CAD file, 2026-11-04]
ros2_ws/src/robot_description/models/full_body_robot/meshes/Joint_link3.5.STL
0.0693 x 0.0673 x 0.222
