lovely009/robot2_ws/ros2_ws/src/robot_description/models/half_body_robot/meshes/collision/Joint_link2.2.STL

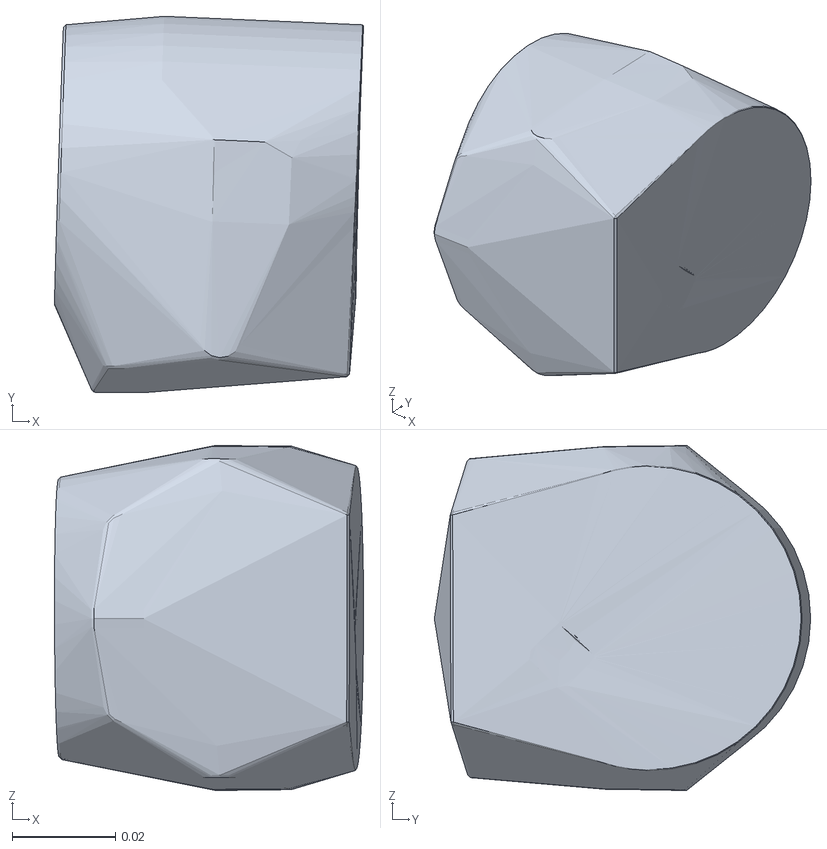
[picture p24: CAD file, 2026-11-03]
ros2_ws/src/robot_description/models/half_body_robot/meshes/collision/Joint_link2.2.STL
0.0597 x 0.0727 x 0.0667
