lovely009/robot2_ws/ros2_ws/src/robot_description/models/half_body_robot/meshes/Joint_link6.6.STL

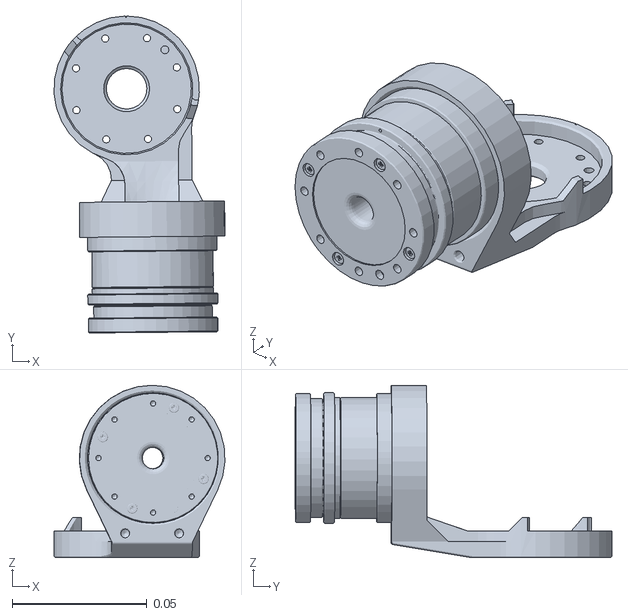
[picture p25: CAD file, 2026-11-03]
ros2_ws/src/robot_description/models/half_body_robot/meshes/Joint_link6.6.STL
0.0634 x 0.118 x 0.064
