lovely009/robot2_ws/ros2_ws/src/robot_description/models/right_arm_4dof/cad/meshes/Joint_link1.STL

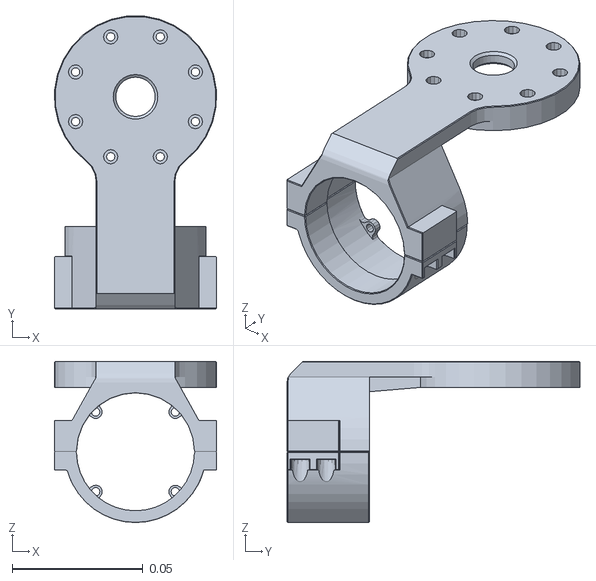
[picture p26: CAD file, 2026-11-04]
ros2_ws/src/robot_description/models/right_arm_4dof/cad/meshes/Joint_link1.STL
0.062 x 0.112 x 0.0615
