lovely009/robot2_ws/ros2_ws/src/robot_description/models/right_arm_4dof/meshes/Joint_link3.STL

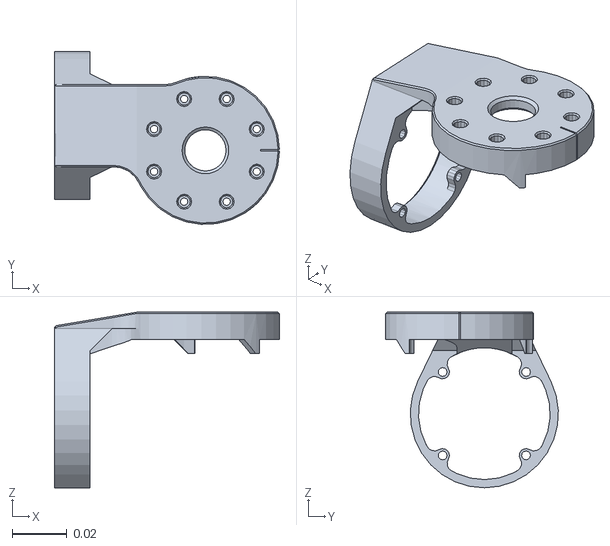
[picture p27: CAD file, 2026-11-04]
ros2_ws/src/robot_description/models/right_arm_4dof/meshes/Joint_link3.STL
0.082 x 0.0629 x 0.064
