lovely009/robot2_ws/ros2_ws/src/robot_description/models/robot_leg/meshes/base_link.STL

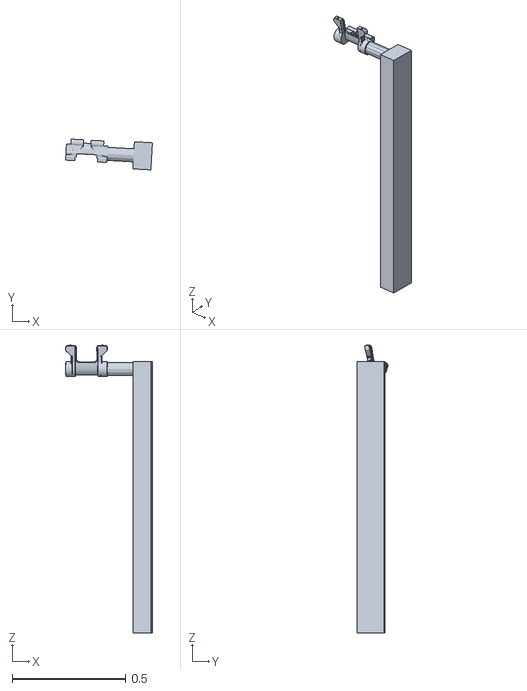
[picture p28: CAD file, 2026-11-03]
ros2_ws/src/robot_description/models/robot_leg/meshes/base_link.STL
0.384 x 0.136 x 1.27
