lovely009/robot2_ws/ros2_ws/src/robot_sim/models/half_body_robot/cad/meshes/Joint_link8.STL

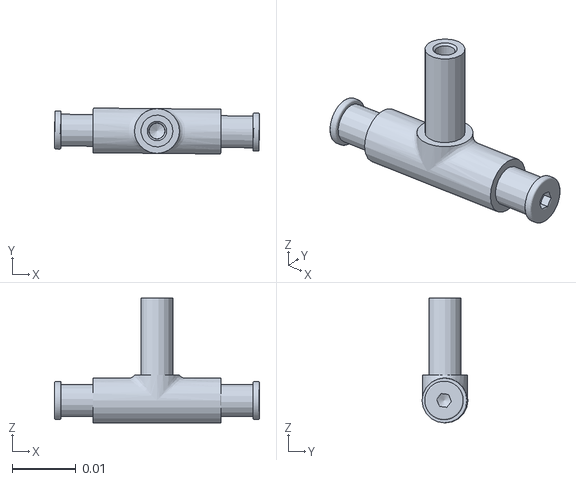
[picture p29: CAD file, 2026-10-26]
ros2_ws/src/robot_sim/models/half_body_robot/cad/meshes/Joint_link8.STL
0.0321 x 0.00719 x 0.0195
