lovely009/robot2_ws/ros2_ws/src/robot_sim/models/half_body_robot/meshes/base_link.STL

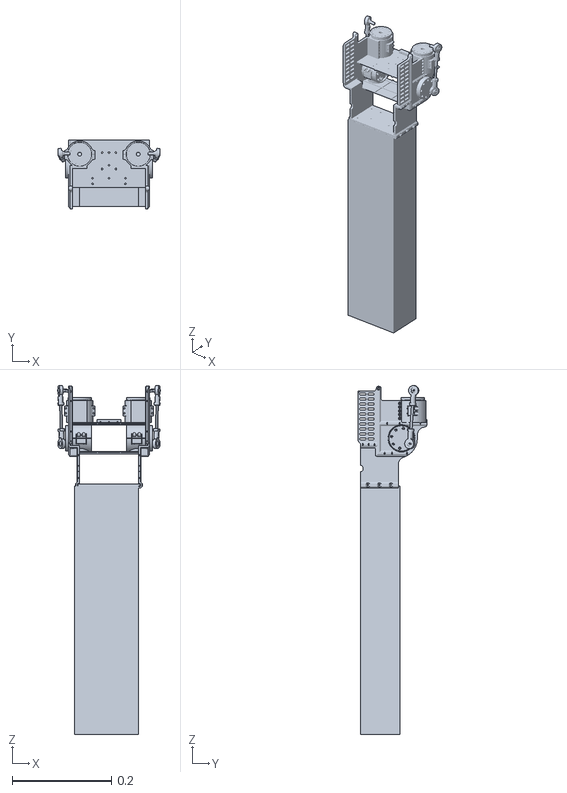
[picture p30: CAD file, 2026-10-26]
ros2_ws/src/robot_sim/models/half_body_robot/meshes/base_link.STL
0.207 x 0.139 x 0.703
