lovely009/robot2_ws/ros2_ws/src/robot_sim/models/robot_leg/meshes/collision/Joint_link4.STL

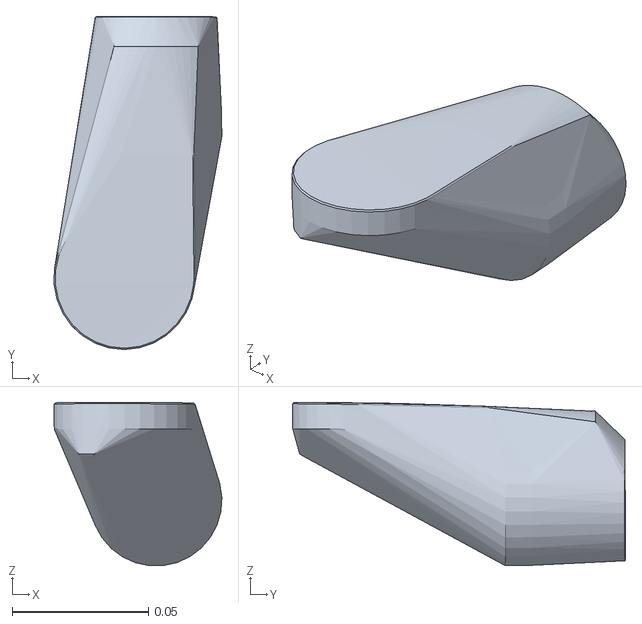
[picture p31: CAD file, 2026-10-26]
ros2_ws/src/robot_sim/models/robot_leg/meshes/collision/Joint_link4.STL
0.0616 x 0.122 x 0.06
