lovely009/robot2_ws/ros2_ws/src/robot_description/models/full_body_robot/meshes/Joint_link3.7.STL

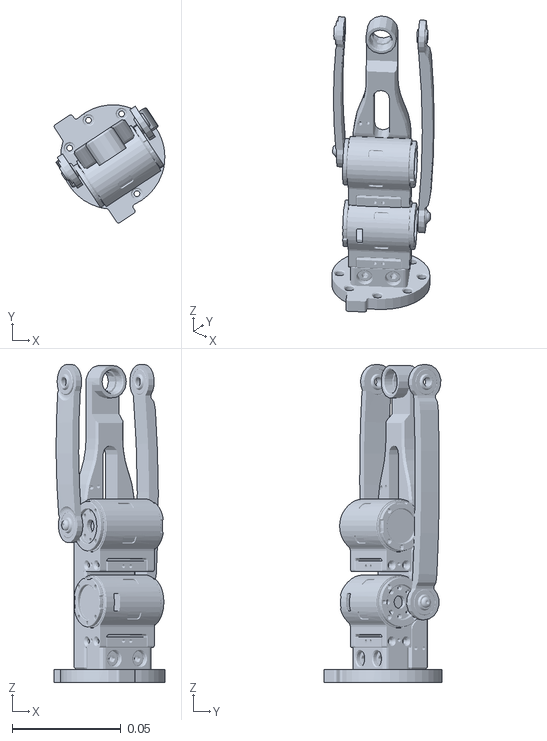
[picture p32: CAD file, 2026-11-04]
ros2_ws/src/robot_description/models/full_body_robot/meshes/Joint_link3.7.STL
0.051 x 0.0543 x 0.146
