lovely009/robot2_ws/ros2_ws/src/robot_description/models/half_body_robot/meshes/collision/Joint_link3.STL

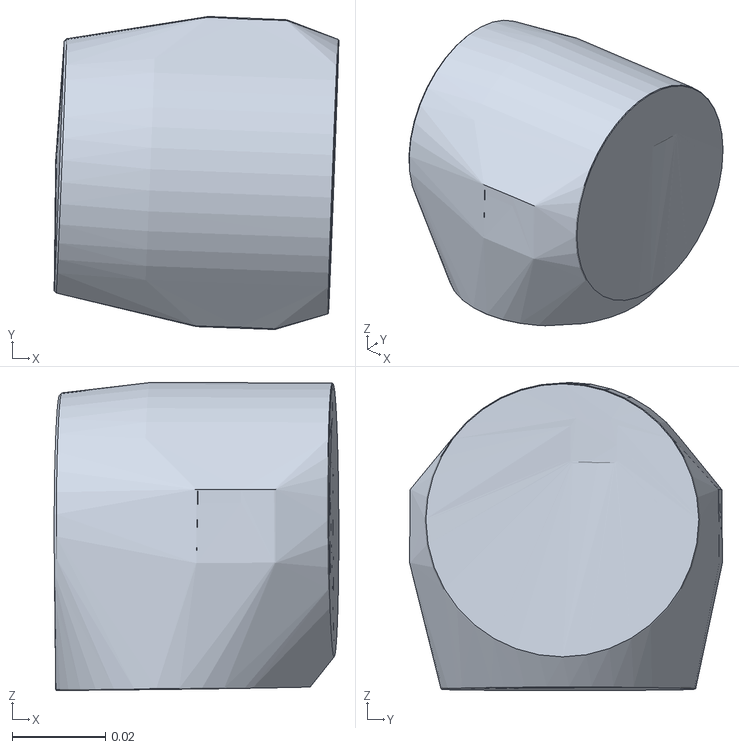
[picture p33: CAD file, 2026-11-03]
ros2_ws/src/robot_description/models/half_body_robot/meshes/collision/Joint_link3.STL
0.0611 x 0.0671 x 0.0661
