lovely009/robot2_ws/ros2_ws/src/robot_description/models/right_arm_4dof/cad/meshes/Joint_link2.STL

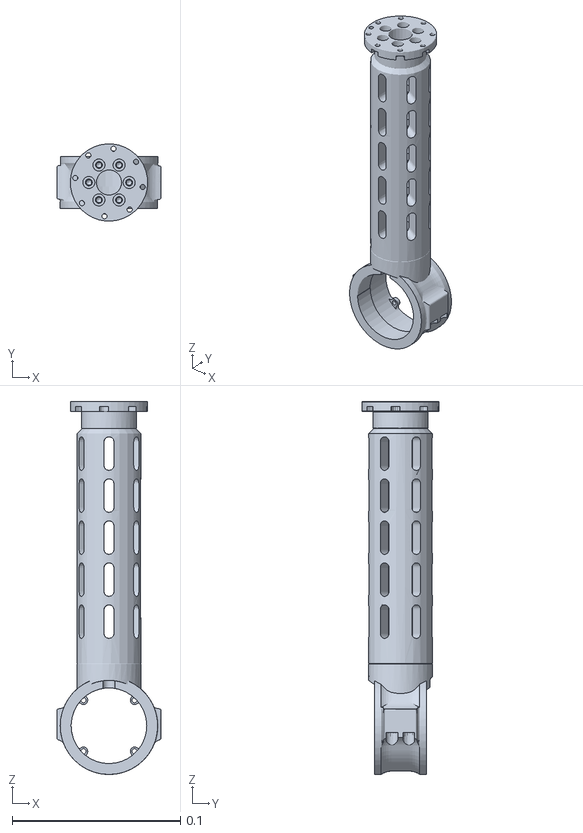
[picture p34: CAD file, 2026-11-04]
ros2_ws/src/robot_description/models/right_arm_4dof/cad/meshes/Joint_link2.STL
0.062 x 0.046 x 0.222
