lovely009/robot2_ws/ros2_ws/src/robot_description/models/right_arm_4dof/meshes/Joint_link3.3.STL

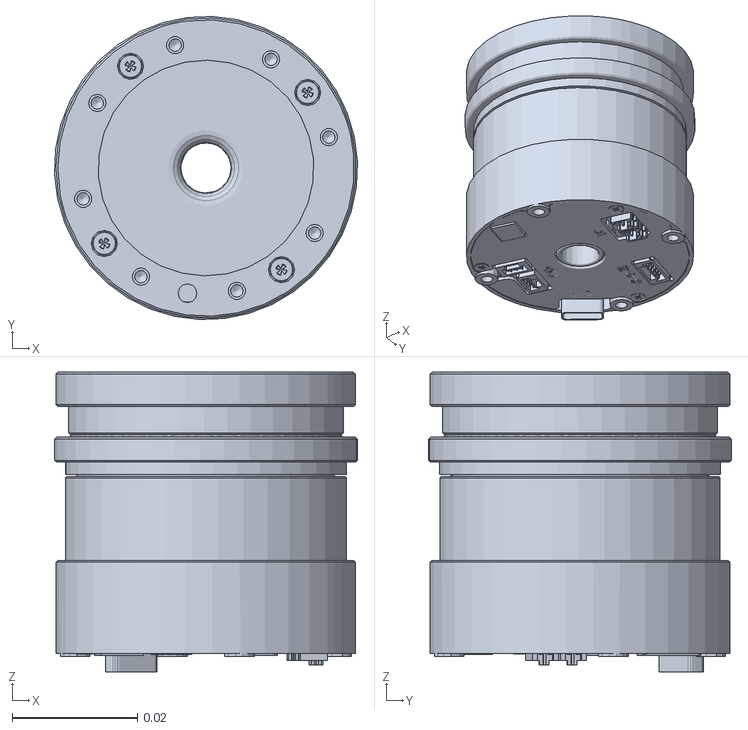
[picture p35: CAD file, 2026-11-04]
ros2_ws/src/robot_description/models/right_arm_4dof/meshes/Joint_link3.3.STL
0.0485 x 0.0485 x 0.0479
