lovely009/robot2_ws/ros2_ws/src/robot_sim/models/robot_leg/meshes/collision/Joint_link1.STL

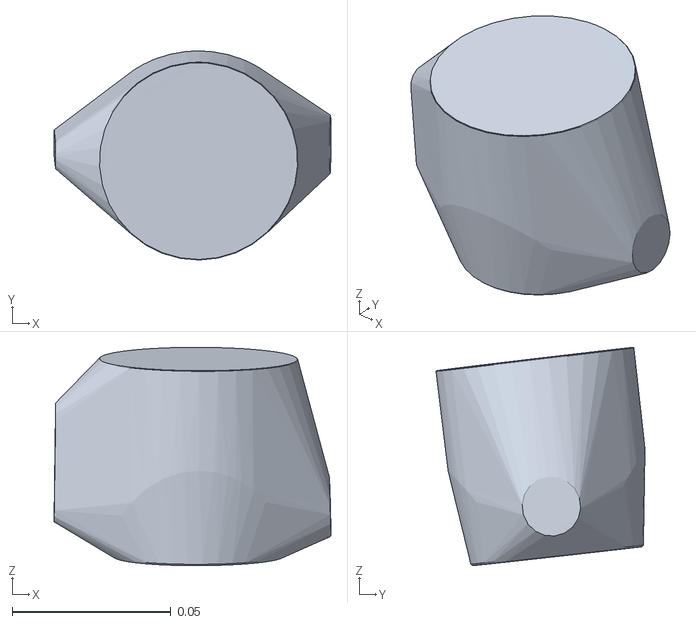
[picture p36: CAD file, 2026-10-26]
ros2_ws/src/robot_sim/models/robot_leg/meshes/collision/Joint_link1.STL
0.0874 x 0.0659 x 0.0689
