lovely009/robot2_ws/ros2_ws/src/robot_description/models/full_body_robot/cad/meshes/Joint_Link2.STL

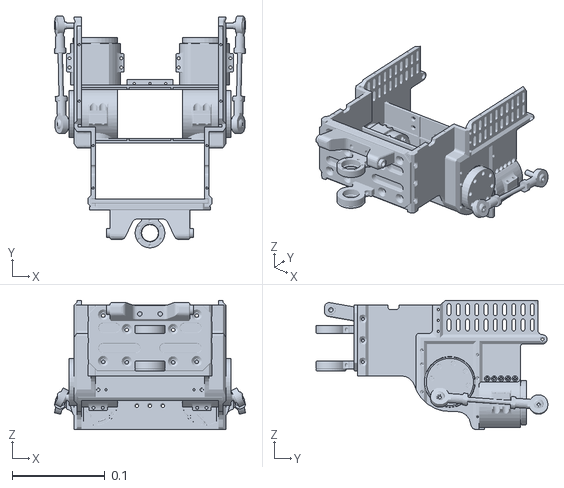
[picture p37: CAD file, 2026-11-04]
ros2_ws/src/robot_description/models/full_body_robot/cad/meshes/Joint_Link2.STL
0.206 x 0.25 x 0.14
