lovely009/robot2_ws/ros2_ws/src/robot_description/models/full_body_robot/meshes/Joint_link3.8r.STL

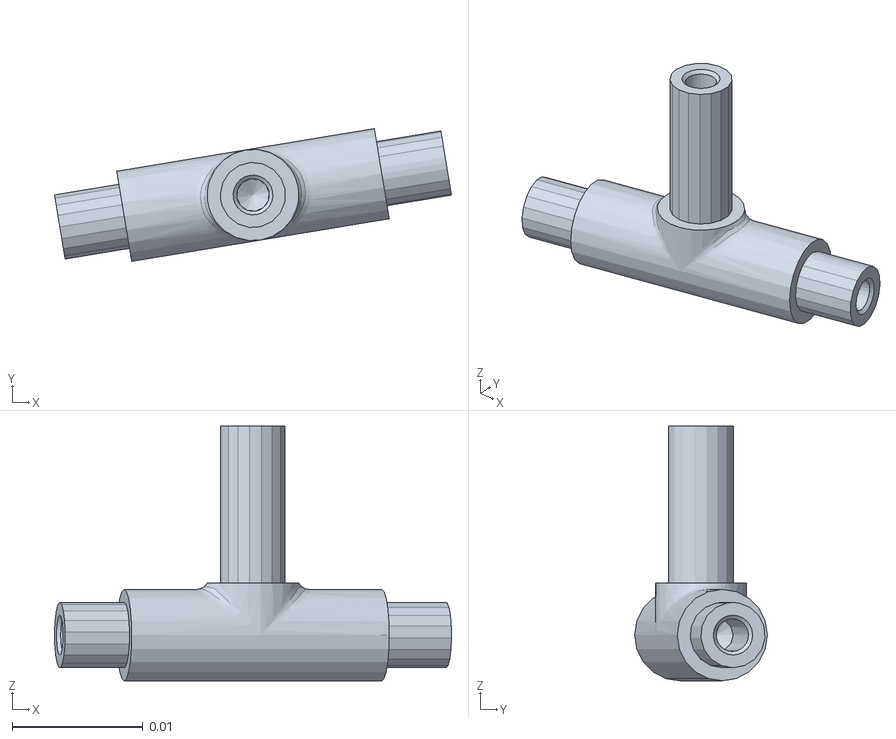
[picture p38: CAD file, 2026-11-04]
ros2_ws/src/robot_description/models/full_body_robot/meshes/Joint_link3.8r.STL
0.0304 x 0.0102 x 0.0195
