lovely009/robot2_ws/ros2_ws/src/robot_description/models/half_body_robot/meshes/collision/Joint_link6.6.STL

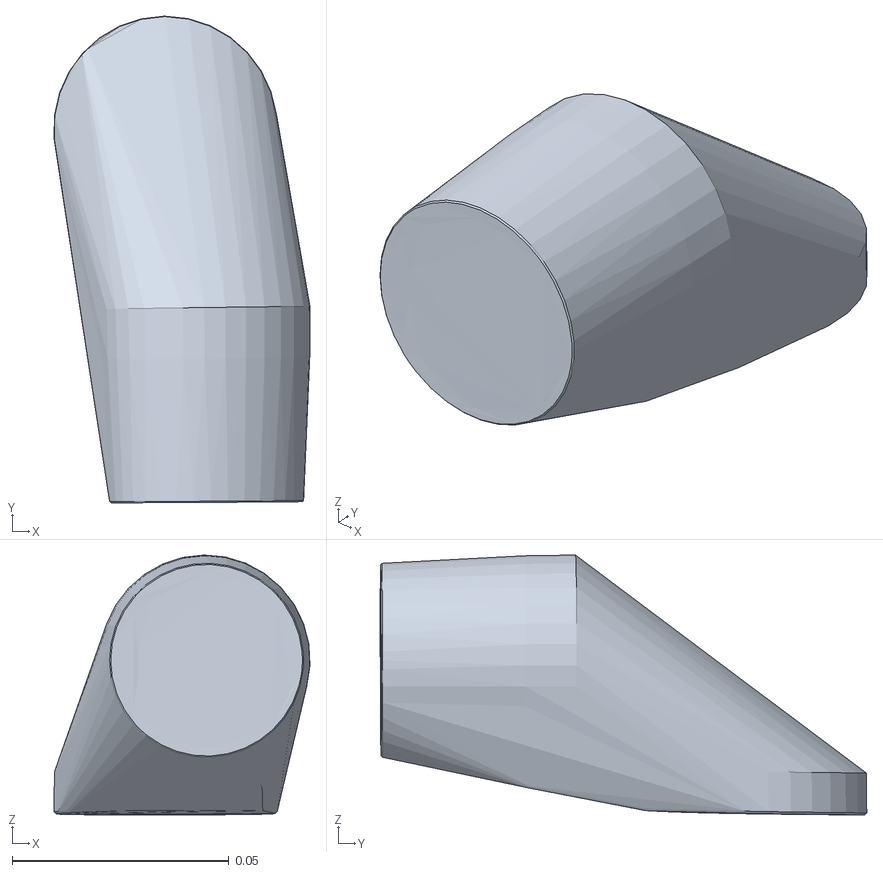
[picture p39: CAD file, 2026-11-03]
ros2_ws/src/robot_description/models/half_body_robot/meshes/collision/Joint_link6.6.STL
0.0591 x 0.112 x 0.06
