lovely009/robot2_ws/ros2_ws/src/robot_sim/models/robot_leg/meshes/collision/Joint_link2.STL

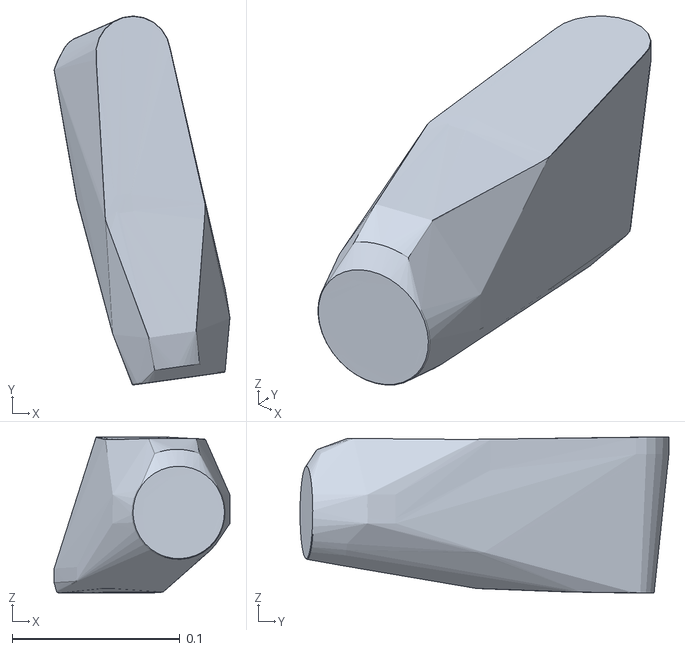
[picture p40: CAD file, 2026-10-26]
ros2_ws/src/robot_sim/models/robot_leg/meshes/collision/Joint_link2.STL
0.105 x 0.22 x 0.093
