lovely009/robot2_ws/ros2_ws/src/robot_description/models/full_body_robot/cad/meshes/Joint_Link1.STL

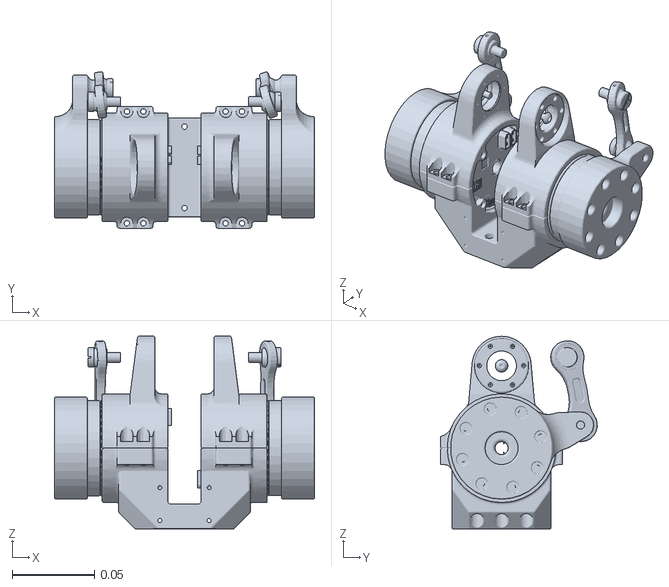
[picture p41: CAD file, 2026-11-04]
ros2_ws/src/robot_description/models/full_body_robot/cad/meshes/Joint_Link1.STL
0.158 x 0.0951 x 0.117
