lovely009/robot2_ws/ros2_ws/src/robot_description/models/full_body_robot/meshes/Joint_link5.7.STL

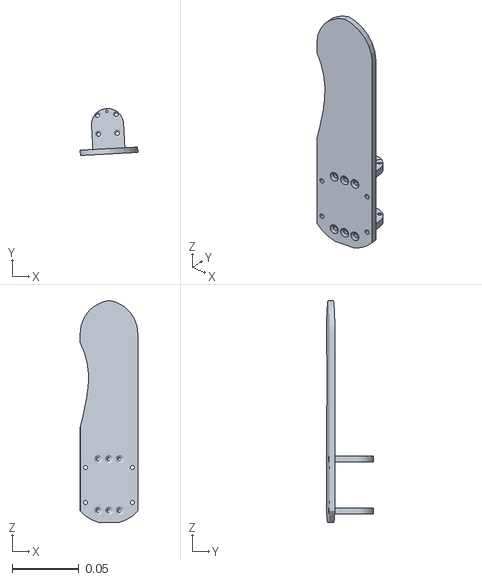
[picture p42: CAD file, 2026-11-04]
ros2_ws/src/robot_description/models/full_body_robot/meshes/Joint_link5.7.STL
0.0432 x 0.0351 x 0.166
