lovely009/robot2_ws/ros2_ws/src/robot_description/models/half_body_robot/meshes/collision/Joint_link1.STL

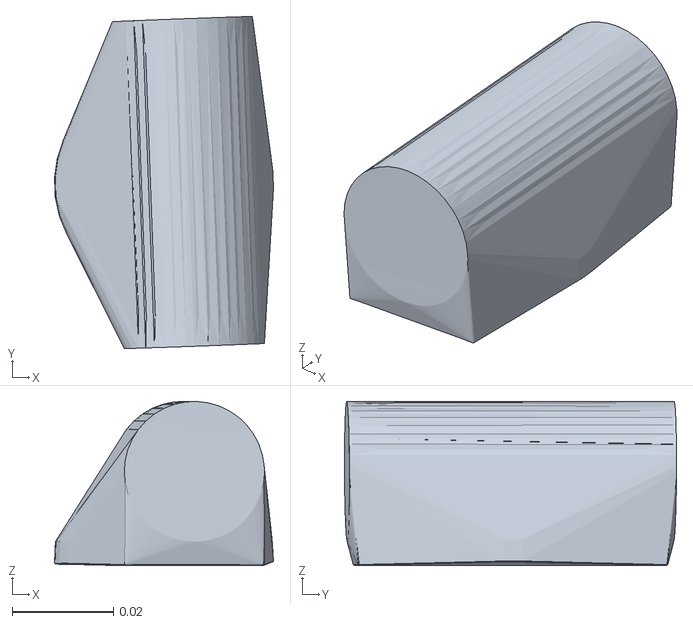
[picture p43: CAD file, 2026-11-03]
ros2_ws/src/robot_description/models/half_body_robot/meshes/collision/Joint_link1.STL
0.0432 x 0.0655 x 0.0324
