lovely009/robot2_ws/ros2_ws/src/robot_description/models/full_body_robot/cad/meshes/Joint_link3.4.STL

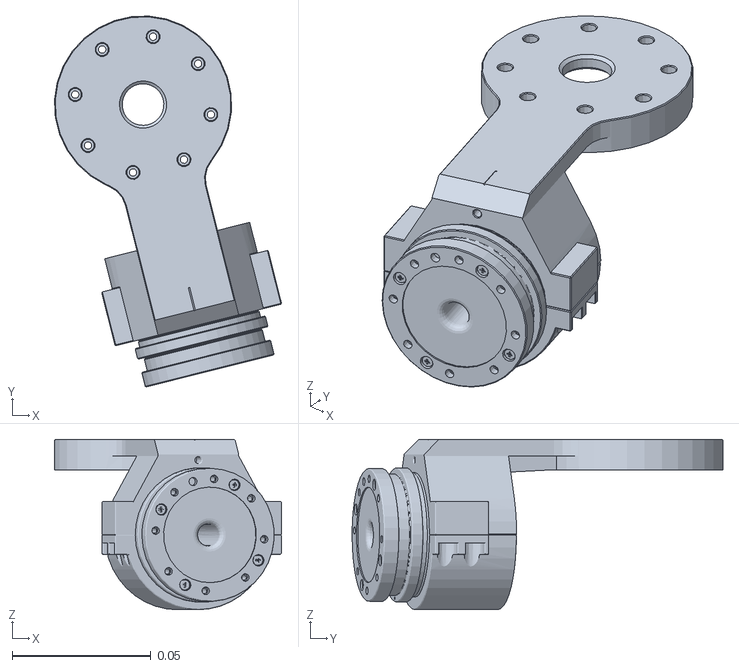
[picture p44: CAD file, 2026-11-04]
ros2_ws/src/robot_description/models/full_body_robot/cad/meshes/Joint_link3.4.STL
0.0819 x 0.134 x 0.0615
