lovely009/robot2_ws/ros2_ws/src/robot_description/models/full_body_robot/meshes/Joint_link3.4r.STL

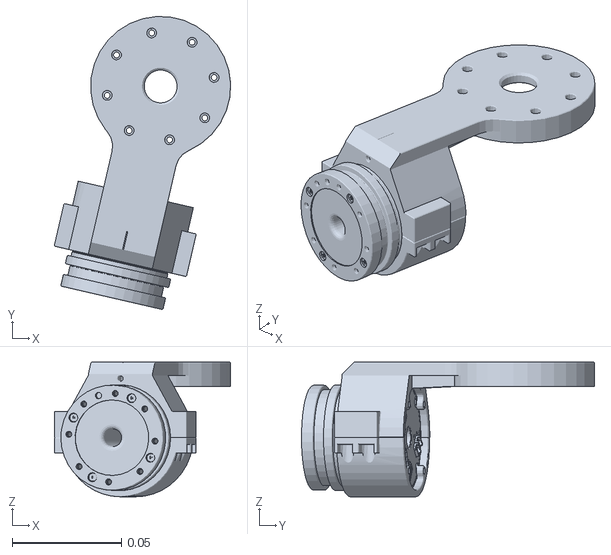
[picture p45: CAD file, 2026-11-04]
ros2_ws/src/robot_description/models/full_body_robot/meshes/Joint_link3.4r.STL
0.0805 x 0.134 x 0.0615
