lovely009/robot2_ws/ros2_ws/src/robot_description/models/full_body_robot/cad/meshes/Joint_link3.7r.STL

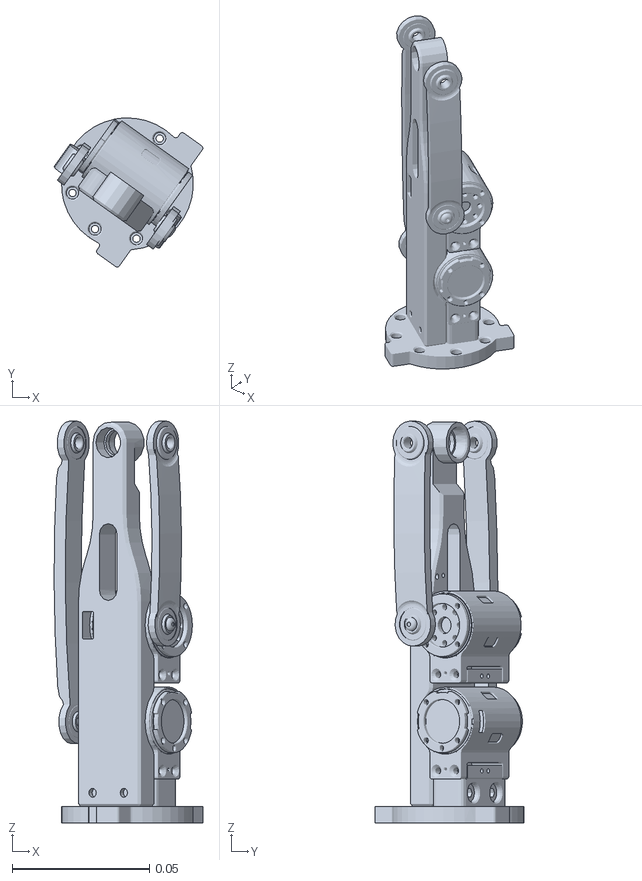
[picture p47: CAD file, 2026-11-04]
ros2_ws/src/robot_description/models/full_body_robot/cad/meshes/Joint_link3.7r.STL
0.0542 x 0.0543 x 0.146
