lovely009/robot2_ws/ros2_ws/src/robot_description/models/full_body_robot/meshes/Joint_link5.2r.STL

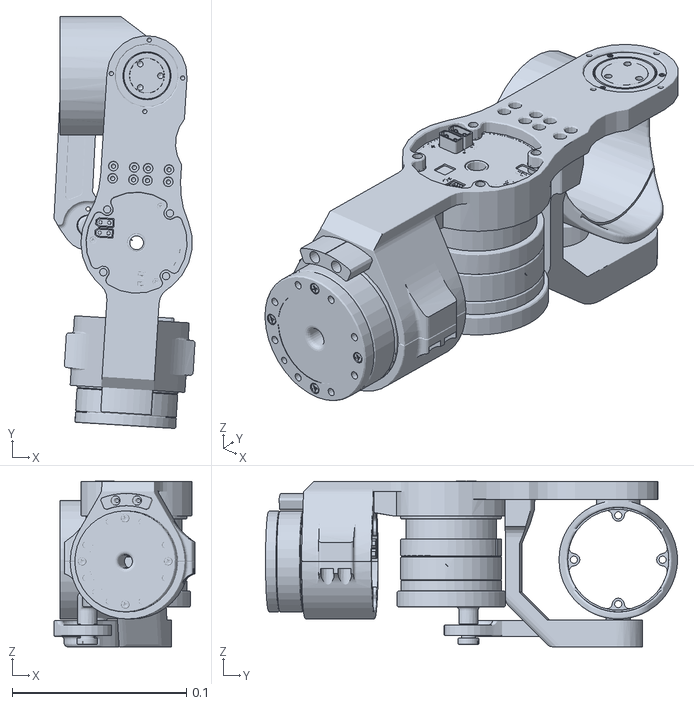
[picture p52: CAD file, 2026-11-04]
ros2_ws/src/robot_description/models/full_body_robot/meshes/Joint_link5.2r.STL
0.0809 x 0.236 x 0.0951
