lovely009/robot2_ws/(list of files, cad)

Other CAD files:
ros2_ws/src/robot_description/models/full_body_robot/cad/meshes/Joint_link3.1r.STL
ros2_ws/src/robot_description/models/full_body_robot/meshes/Joint_Link5.STL
ros2_ws/src/robot_description/models/full_body_robot/cad/meshes/Joint_link5.3.STL
ros2_ws/src/robot_description/models/full_body_robot/meshes/Joint_link3.3r.STL
ros2_ws/src/robot_description/models/half_body_robot/cad/meshes/Joint_link3.STL
ros2_ws/src/robot_description/models/half_body_robot/cad/meshes/Joint_link5.STL
