lovely009/robot2_ws/ros2_ws/src/robot_sim/models/half_body_robot/mujoco/half_body_robot.xml

<mujoco model="half_body_robot">
  <compiler angle="radian" meshdir="../meshes" />
  <option timestep="0.001" integrator="implicitfast" />
  <asset>
    <mesh name="base_link" content_type="model/stl" file="base_link_simplified.STL" />
    <mesh name="Joint_link1" content_type="model/stl" file="Joint_link1.STL" />
    <mesh name="Joint_link2" content_type="model/stl" file="Joint_link2.STL" />
    <mesh name="Joint_link3" content_type="model/stl" file="Joint_link3.STL" />
    <mesh name="Joint_link4" content_type="model/stl" file="Joint_link4.STL" />
    <mesh name="Joint_link5" content_type="model/stl" file="Joint_link5.STL" />
    <mesh name="Joint_link6" content_type="model/stl" file="Joint_link6.STL" />
    <mesh name="Joint_link7" content_type="model/stl" file="Joint_link7.STL" />
    <mesh name="Joint_link8" content_type="model/stl" file="Joint_link8.STL" />
    <mesh name="Joint_link9" content_type="model/stl" file="Joint_link9.STL" />
    <mesh name="Joint_link1.1" content_type="model/stl" file="Joint_link1.1.STL" />
    <mesh name="Joint_link2.2" content_type="model/stl" file="Joint_link2.2.STL" />
    <mesh name="Joint_link3.3" content_type="model/stl" file="Joint_link3.3.STL" />
    <mesh name="Joint_link4.4" content_type="model/stl" file="Joint_link4.4.STL" />
    <mesh name="Joint_link5.5" content_type="model/stl" file="Joint_link5.5.STL" />
    <mesh name="Joint_link6.6" content_type="model/stl" file="Joint_link6.6.STL" />
    <mesh name="Joint_link7.7" content_type="model/stl" file="Joint_link7.7.STL" />
    <mesh name="Joint_link8.8" content_type="model/stl" file="Joint_link8.8.STL" />
    <mesh name="Joint_link9.9" content_type="model/stl" file="Joint_link9.9.STL" />
    <mesh name="collision_Joint_link1" content_type="model/stl" file="collision/Joint_link1.STL" />
    <mesh name="collision_Joint_link2" content_type="model/stl" file="collision/Joint_link2.STL" />
    <mesh name="collision_Joint_link3" content_type="model/stl" file="collision/Joint_link3.STL" />
    <mesh name="collision_Joint_link4" content_type="model/stl" file="collision/Joint_link4.STL" />
    <mesh name="collision_Joint_link5" content_type="model/stl" file="collision/Joint_link5.STL" />
    <mesh name="collision_Joint_link6" content_type="model/stl" file="collision/Joint_link6.STL" />
    <mesh name="collision_Joint_link7" content_type="model/stl" file="collision/Joint_link7.STL" />
    <mesh name="collision_Joint_link1.1" content_type="model/stl" file="collision/Joint_link1.1.STL" />
    <mesh name="collision_Joint_link2.2" content_type="model/stl" file="collision/Joint_link2.2.STL" />
    <mesh name="collision_Joint_link3.3" content_type="model/stl" file="collision/Joint_link3.3.STL" />
    <mesh name="collision_Joint_link4.4" content_type="model/stl" file="collision/Joint_link4.4.STL" />
    <mesh name="collision_Joint_link5.5" content_type="model/stl" file="collision/Joint_link5.5.STL" />
    <mesh name="collision_Joint_link6.6" content_type="model/stl" file="collision/Joint_link6.6.STL" />
    <mesh name="collision_Joint_link7.7" content_type="model/stl" file="collision/Joint_link7.7.STL" />
  </asset>
  <worldbody>
    <geom name="collision_base_link" group="3" density="0" contype="1" conaffinity="1" friction="0.8 0.005 0.0001" pos="0.00495 0.02475 0.34" type="box" size="0.09325 0.05975 0.33" />
    <geom type="mesh" contype="0" conaffinity="0" group="1" density="0" rgba="0.79216 0.81961 0.93333 1" mesh="base_link" />
    <body name="Joint_link1" pos="0.064 0.0655 0.6787">
      <inertial pos="0.0034444 9.3449e-05 0.0099326" quat="0.491519 0.509181 -0.490678 0.508309" mass="0.049921" diaginertia="1.3934e-05 1.01236e-05 8.06243e-06" />
      <joint name="joint_link1" pos="0 0 0" axis="0 0 -1" range="-0.17 0.52" actuatorfrcrange="-11 11" damping="0.00621" armature="0.04" />
      <geom name="collision_Joint_link1" group="3" density="0" contype="1" conaffinity="1" friction="0.8 0.005 0.0001" pos="0 0 0" type="mesh" mesh="collision_Joint_link1" />
      <geom type="mesh" contype="0" conaffinity="0" group="1" density="0" rgba="0.89804 0.91765 0.92941 1" mesh="Joint_link1" />
      <body name="Joint_link2" pos="0.006205 -0.032594 0.0203" quat="0.707105 0.707108 0 0">
        <inertial pos="-0.0055068 0.018045 -0.03312" quat="0.688987 0.0133503 0.0126952 0.72454" mass="0.15207" diaginertia="8.25261e-05 7.06202e-05 3.50527e-05" />
        <joint name="joint_link2" pos="0 0 0" axis="0.03684 0 0.999321" range="-0.12 0.14" actuatorfrcrange="-11 11" damping="0.0473" armature="0.04" />
        <geom name="collision_Joint_link2" group="3" density="0" contype="1" conaffinity="1" friction="0.8 0.005 0.0001" pos="0 0 0" type="mesh" mesh="collision_Joint_link2" />
        <geom type="mesh" contype="0" conaffinity="0" group="1" density="0" rgba="0.89804 0.91765 0.92941 1" mesh="Joint_link2" />
        <body name="Joint_link3" pos="0.032075 0.034869 -0.034505" quat="0.693802 -0.0139821 0.719884 0.0145075">
          <inertial pos="0.0081014 -0.00011124 0.025661" quat="0.410364 0.381968 -0.5924 0.578588" mass="0.14417" diaginertia="8.65167e-05 7.2992e-05 3.94194e-05" />
          <joint name="joint_link3" pos="0 0 0" axis="0 0 1" range="-3.14 0.52" actuatorfrcrange="-45 45" damping="0.0537" armature="0.04" />
          <geom name="collision_Joint_link3" group="3" density="0" contype="1" conaffinity="1" friction="0.8 0.005 0.0001" pos="0 0 0" type="mesh" mesh="collision_Joint_link3" />
          <geom type="mesh" contype="0" conaffinity="0" group="1" density="0" rgba="0.89804 0.91765 0.92941 1" mesh="Joint_link3" />
          <body name="Joint_link4" pos="-0.022483 0.00088072 0.0383" quat="0.706974 -0.0136829 -0.706975 -0.0136805">
            <inertial pos="-0.000940784 -0.0447765 -0.00600964" quat="0.469496 0.527406 -0.538942 0.459302" mass="0.153511" diaginertia="0.000182864 0.000150809 5.13445e-05" />
            <joint name="joint_link4" pos="0 0 0" axis="0 0 1" range="0 1.57" actuatorfrcrange="-45 45" damping="0.0536" armature="0.04" />
            <geom name="collision_Joint_link4" group="3" density="0" contype="1" conaffinity="1" friction="0.8 0.005 0.0001" pos="0 0 0" type="mesh" mesh="collision_Joint_link4" />
            <geom type="mesh" contype="0" conaffinity="0" group="1" density="0" rgba="0.898039 0.917647 0.929412 1" mesh="Joint_link4" />
            <body name="Joint_link5" pos="-0.0021024 -0.099078 -0.0235" quat="0.687307 0.690679 0.151537 -0.166156">
              <inertial pos="0.00037809 -0.0011551 0.092895" quat="0.975651 0.0041665 -0.00118894 0.219284" mass="0.33427" diaginertia="0.000313181 0.000291874 9.25127e-05" />
              <joint name="joint_link5" pos="0 0 0" axis="0 0 -1" range="-1.57 1.57" actuatorfrcrange="-11 11" damping="0.000181" armature="0.04" />
              <geom name="collision_Joint_link5" group="3" density="0" contype="1" conaffinity="1" friction="0.8 0.005 0.0001" pos="0 0 0" type="mesh" mesh="collision_Joint_link5" />
              <geom type="mesh" contype="0" conaffinity="0" group="1" density="0" rgba="0.89804 0.91765 0.92941 1" mesh="Joint_link5" />
              <body name="Joint_link6" pos="0.023244 0.0046459 0.1705" quat="0.606768 -0.592103 0.386544 -0.363085">
                <inertial pos="-0.0058533 -0.030239 -0.0055441" quat="0.46411 0.626876 -0.573147 0.251258" mass="0.084684" diaginertia="7.25381e-05 6.81968e-05 3.1247e-05" />
                <joint name="joint_link6" pos="0 0 0" axis="0 0 1" range="-1.85 0.09" actuatorfrcrange="-11 11" damping="0.00454" armature="0.04" />
                <geom name="collision_Joint_link6" group="3" density="0" contype="1" conaffinity="1" friction="0.8 0.005 0.0001" pos="0 0 0" type="mesh" mesh="collision_Joint_link6" />
                <geom type="mesh" contype="0" conaffinity="0" group="1" density="0" rgba="0.89804 0.91765 0.92941 1" mesh="Joint_link6" />
                <body name="Joint_link7" pos="-0.0099185 -0.09641 -0.027" quat="0.688965 0.687421 -0.165694 0.159141">
                  <inertial pos="0.0015544 0.00212264 0.0466948" quat="0.86395 -0.0053472 0.00810239 0.503484" mass="0.171864" diaginertia="0.000124805 0.000123686 1.7909e-05" />
                  <joint name="joint_link7" pos="0 0 0" axis="0 0 -1" range="-1.57 1.57" actuatorfrcrange="-11 11" damping="2.08e-05" armature="0.04" />
                  <geom name="collision_Joint_link7" group="3" density="0" contype="1" conaffinity="1" friction="0.8 0.005 0.0001" pos="0 0 0" type="mesh" mesh="collision_Joint_link7" />
                  <geom type="mesh" contype="0" conaffinity="0" group="1" density="0" rgba="1 1 1 1" mesh="Joint_link7" />
                  <body name="Joint_link8" pos="0.0053653 0.010734 0.1325" quat="0.688965 -0.687421 0.165694 -0.159141">
                    <inertial pos="1.04366e-09 -1.08225e-09 -0.0142699" quat="0.502375 0.502375 0.497614 0.497614" mass="0.00316185" diaginertia="1.82173e-07 1.36808e-07 6.2876e-08" />
                    <joint name="joint_link8" pos="0 0 0" axis="0 0 1" range="-1.047 1.047" actuatorfrcrange="-1.15 1.15" damping="2.58e-06" armature="0.04" />
                    <geom name="collision_Joint_link8" group="3" density="0" contype="1" conaffinity="1" friction="0.8 0.005 0.0001" pos="5e-05 0 -0.00975" type="box" size="0.01605 0.0036 0.00975" />
                    <geom type="mesh" contype="0" conaffinity="0" group="1" density="0" rgba="0.898039 0.917647 0.929412 1" mesh="Joint_link8" />
                    <body name="Joint_link9" pos="0.0099995 -9.5222e-05 -0.016" quat="0.707099 0.01011 0.707035 0.0033928">
                      <inertial pos="-0.00219742 -0.00811137 -0.00998385" quat="0.993853 -0.000894962 0.000194502 0.110705" mass="0.00996524" diaginertia="1.80223e-06 1.42394e-06 7.20072e-07" />
                      <joint name="joint_link9" pos="0 0 0" axis="0 0 1" range="-1.22 1.22" actuatorfrcrange="-1.15 1.15" damping="1.42e-06" armature="0.04" />
                      <geom type="mesh" contype="0" conaffinity="0" group="1" density="0" rgba="0.898039 0.917647 0.929412 1" mesh="Joint_link9" />
                    </body>
                  </body>
                </body>
              </body>
            </body>
          </body>
        </body>
      </body>
    </body>
    <body name="Joint_link1.1" pos="-0.054 0.0655 0.6792">
      <inertial pos="-0.00343169 -0.000763417 0.00927931" quat="0.509188 0.491512 -0.508316 0.490671" mass="0.0485377" diaginertia="1.38778e-05 1.00678e-05 7.95838e-06" />
      <joint name="joint_link1.1" pos="0 0 0" axis="0 0 -1" range="-0.52 0.17" actuatorfrcrange="-11 11" damping="0.00632" armature="0.04" />
      <geom name="collision_Joint_link1.1" group="3" density="0" contype="1" conaffinity="1" friction="0.8 0.005 0.0001" pos="0 0 0" type="mesh" mesh="collision_Joint_link1.1" />
      <geom type="mesh" contype="0" conaffinity="0" group="1" density="0" rgba="0.898039 0.917647 0.929412 1" mesh="Joint_link1.1" />
      <body name="Joint_link2.2" pos="-0.006205 -0.032594 0.0198" quat="0.706985 0.706988 -0.0130274 -0.0130273">
        <inertial pos="0.00534836 0.0180451 -0.0288225" quat="0.72454 -0.012696 -0.0133512 0.688987" mass="0.152067" diaginertia="8.25258e-05 7.06199e-05 3.50529e-05" />
        <joint name="joint_link2.2" pos="0 0 0" axis="0 0 1" range="-0.14 0.12" actuatorfrcrange="-11 11" damping="0.047" armature="0.04" />
        <geom name="collision_Joint_link2.2" group="3" density="0" contype="1" conaffinity="1" friction="0.8 0.005 0.0001" pos="0 0 0" type="mesh" mesh="collision_Joint_link2.2" />
        <geom type="mesh" contype="0" conaffinity="0" group="1" density="0" rgba="0.898039 0.917647 0.929412 1" mesh="Joint_link2.2" />
        <body name="Joint_link3.3" pos="-0.033324 0.034869 -0.0333" quat="-0.706969 0.01403 0.706966 0.0140299">
          <inertial pos="-0.00808533 -0.000522849 0.025661" quat="0.576996 0.594209 -0.387399 0.404861" mass="0.144166" diaginertia="8.65169e-05 7.29924e-05 3.94193e-05" />
          <joint name="joint_link3.3" pos="0 0 0" axis="0 0 1" range="-0.52 3.14" actuatorfrcrange="-45 45" damping="0.0533" armature="0.04" />
          <geom name="collision_Joint_link3.3" group="3" density="0" contype="1" conaffinity="1" friction="0.8 0.005 0.0001" pos="0 0 0" type="mesh" mesh="collision_Joint_link3.3" />
          <geom type="mesh" contype="0" conaffinity="0" group="1" density="0" rgba="0.898039 0.917647 0.929412 1" mesh="Joint_link3.3" />
          <body name="Joint_link4.4" pos="0.022483 0.00088072 0.0383" quat="0.69381 0.0139877 0.719877 0.0144824">
            <inertial pos="-0.00143912 -0.044959 -0.00430792" quat="0.473476 0.50583 -0.542166 0.475408" mass="0.153511" diaginertia="0.000182864 0.000150809 5.13445e-05" />
            <joint name="joint_link4.4" pos="0 0 0" axis="-0.0352381 0.0391111 0.998613" range="-1.57 0" actuatorfrcrange="-45 45" damping="0.0532" armature="0.04" />
            <geom name="collision_Joint_link4.4" group="3" density="0" contype="1" conaffinity="1" friction="0.8 0.005 0.0001" pos="0 0 0" type="mesh" mesh="collision_Joint_link4.4" />
            <geom type="mesh" contype="0" conaffinity="0" group="1" density="0" rgba="0.898039 0.917647 0.929412 1" mesh="Joint_link4.4" />
            <body name="Joint_link5.5" pos="-0.0028455 -0.09988 -0.019721" quat="0.671712 0.637025 -0.274388 0.260219">
              <inertial pos="-0.000934018 -0.000777647 0.092895" quat="0.930401 0.00277874 -0.00332397 -0.366517" mass="0.334271" diaginertia="0.00031318 0.000291877 9.25129e-05" />
              <joint name="joint_link5.5" pos="0 0 0" axis="0 0 -1" range="-1.57 1.57" actuatorfrcrange="-11 11" damping="0.000181" armature="0.04" />
              <geom name="collision_Joint_link5.5" group="3" density="0" contype="1" conaffinity="1" friction="0.8 0.005 0.0001" pos="0 0 0" type="mesh" mesh="collision_Joint_link5.5" />
              <geom type="mesh" contype="0" conaffinity="0" group="1" density="0" rgba="0.898039 0.917647 0.929412 1" mesh="Joint_link5.5" />
              <body name="Joint_link6.6" pos="0.012896 -0.019889 0.1705" quat="0.652382 -0.64121 -0.298081 0.272757">
                <inertial pos="0.00585386 -0.0302389 0.00554417" quat="0.626886 0.464117 -0.251243 0.573137" mass="0.0846838" diaginertia="7.25379e-05 6.81972e-05 3.12471e-05" />
                <joint name="joint_link6.6" pos="0 0 0" axis="0 0 -1" range="-1.85 0.09" actuatorfrcrange="-11 11" damping="0.00451" armature="0.04" />
                <geom name="collision_Joint_link6.6" group="3" density="0" contype="1" conaffinity="1" friction="0.8 0.005 0.0001" pos="0 0 0" type="mesh" mesh="collision_Joint_link6.6" />
                <geom type="mesh" contype="0" conaffinity="0" group="1" density="0" rgba="0.898039 0.917647 0.929412 1" mesh="Joint_link6.6" />
                <body name="Joint_link7.7" pos="0.009863 -0.09041 0.027" quat="0.701521 0.700646 0.0953798 -0.0886916">
                  <inertial pos="0.000150005 -0.00271779 0.0533405" quat="0.627906 0.00785402 -0.00569174 0.778229" mass="0.169244" diaginertia="0.000124794 0.000123585 1.78079e-05" />
                  <joint name="joint_link7.7" pos="0 0 0" axis="0 0 -1" range="-1.57 1.57" actuatorfrcrange="-11 11" damping="2.08e-05" armature="0.04" />
                  <geom name="collision_Joint_link7.7" group="3" density="0" contype="1" conaffinity="1" friction="0.8 0.005 0.0001" pos="0 0 0" type="mesh" mesh="collision_Joint_link7.7" />
                  <geom type="mesh" contype="0" conaffinity="0" group="1" density="0" rgba="0.898039 0.917647 0.929412 1" mesh="Joint_link7.7" />
                  <body name="Joint_link8.8" pos="0.0030973 -0.011593 0.1385" quat="0.0953913 -0.0887031 0.701522 -0.700642">
                    <inertial pos="1.52732e-09 -1.75343e-09 -0.0142699" quat="0.502379 0.502379 0.497609 0.497609" mass="0.00316185" diaginertia="1.82173e-07 1.36808e-07 6.2876e-08" />
                    <joint name="joint_link8.8" pos="0 0 0" axis="0 0 1" range="-1.047 1.047" actuatorfrcrange="-1.15 1.15" damping="2.58e-06" armature="0.04" />
                    <geom name="collision_Joint_link8.8" group="3" density="0" contype="1" conaffinity="1" friction="0.8 0.005 0.0001" pos="5e-05 0 -0.00975" type="box" size="0.01605 0.0036 0.00975" />
                    <geom type="mesh" contype="0" conaffinity="0" group="1" density="0" rgba="0.898039 0.917647 0.929412 1" mesh="Joint_link8.8" />
                    <body name="Joint_link9.9" pos="-0.014999 0.0001431 -0.016" quat="0.719844 -0.0128536 -0.693906 0.0123941">
                      <inertial pos="0.00229169 -0.00836225 -0.0148637" quat="0.990272 -0.00131681 -0.0184775 -0.13791" mass="0.00996524" diaginertia="1.80223e-06 1.42394e-06 7.20072e-07" />
                      <joint name="joint_link9.9" pos="0 0 0" axis="0.0363202 -0.00953395 -0.999295" range="-1.22 1.22" actuatorfrcrange="-1.15 1.15" damping="1.42e-06" armature="0.04" />
                      <geom type="mesh" contype="0" conaffinity="0" group="1" density="0" rgba="0.898039 0.917647 0.929412 1" mesh="Joint_link9.9" />
                    </body>
                  </body>
                </body>
              </body>
            </body>
          </body>
        </body>
      </body>
    </body>
  </worldbody>
  <contact>
    <exclude body1="world" body2="Joint_link1" />
    <exclude body1="Joint_link1" body2="Joint_link2" />
    <exclude body1="Joint_link2" body2="Joint_link3" />
    <exclude body1="Joint_link3" body2="Joint_link4" />
    <exclude body1="Joint_link4" body2="Joint_link5" />
    <exclude body1="Joint_link5" body2="Joint_link6" />
    <exclude body1="Joint_link6" body2="Joint_link7" />
    <exclude body1="Joint_link7" body2="Joint_link8" />
    <exclude body1="Joint_link8" body2="Joint_link9" />
    <exclude body1="world" body2="Joint_link1.1" />
    <exclude body1="Joint_link1.1" body2="Joint_link2.2" />
    <exclude body1="Joint_link2.2" body2="Joint_link3.3" />
    <exclude body1="Joint_link3.3" body2="Joint_link4.4" />
    <exclude body1="Joint_link4.4" body2="Joint_link5.5" />
    <exclude body1="Joint_link5.5" body2="Joint_link6.6" />
    <exclude body1="Joint_link6.6" body2="Joint_link7.7" />
    <exclude body1="Joint_link7.7" body2="Joint_link8.8" />
    <exclude body1="Joint_link8.8" body2="Joint_link9.9" />
  </contact>
  <actuator>
    <motor name="actuator_joint_link1" joint="joint_link1" gear="1" user="3.1416" />
    <motor name="actuator_joint_link2" joint="joint_link2" gear="1" user="3.1416" />
    <motor name="actuator_joint_link3" joint="joint_link3" gear="1" user="3.1416" />
    <motor name="actuator_joint_link4" joint="joint_link4" gear="1" user="3.1416" />
    <motor name="actuator_joint_link5" joint="joint_link5" gear="1" user="3.1416" />
    <motor name="actuator_joint_link6" joint="joint_link6" gear="1" user="3.1416" />
    <motor name="actuator_joint_link7" joint="joint_link7" gear="1" user="3.1416" />
    <motor name="actuator_joint_link8" joint="joint_link8" gear="1" user="4.189" />
    <motor name="actuator_joint_link9" joint="joint_link9" gear="1" user="4.189" />
    <motor name="actuator_joint_link1.1" joint="joint_link1.1" gear="1" user="3.1416" />
    <motor name="actuator_joint_link2.2" joint="joint_link2.2" gear="1" user="3.1416" />
    <motor name="actuator_joint_link3.3" joint="joint_link3.3" gear="1" user="3.1416" />
    <motor name="actuator_joint_link4.4" joint="joint_link4.4" gear="1" user="3.1416" />
    <motor name="actuator_joint_link5.5" joint="joint_link5.5" gear="1" user="3.1416" />
    <motor name="actuator_joint_link6.6" joint="joint_link6.6" gear="1" user="3.1416" />
    <motor name="actuator_joint_link7.7" joint="joint_link7.7" gear="1" user="3.1416" />
    <motor name="actuator_joint_link8.8" joint="joint_link8.8" gear="1" user="4.189" />
    <motor name="actuator_joint_link9.9" joint="joint_link9.9" gear="1" user="4.189" />
  </actuator>
</mujoco>
