lovely009/robot2_ws/ros2_ws/src/robot_sim/models/half_body_robot/urdf/half_body_robot.urdf

<?xml version="1.0" encoding="utf-8"?>
<!-- 派生自 cad/urdf/ 的 SolidWorks 导出件；保留机械几何、惯量、关节原点与轴。
     joint 名小写，避免与 link 同名导致 SDFormat 拒绝。
     dynamics.damping 取零位等效惯量（kg·m²）数值，对应 1 s 时间常数；friction=0，未标定。
     碰撞体：base_link 的 box 每边内缩 10 mm；Joint_link8/.8 用 box；
     14 个凸包顶点向质心内缩 3 mm；Joint_link9/.9 被 link7 凸包包围，不提供 collision。
     visual 保留全分辨率网格；生成工具见 tools/build_simplified_collision_meshes.py。
     lower/upper 使用 CAD 限位（joint_link6/.6 两侧同值）；effort/velocity 使用型号库额定值：
     R58 20 N·m、R48 5 N·m，均为 3.1416 rad/s；Vaxor 1.15 N·m、4.189 rad/s。
     数值保留 5 位有效数字，全精度原件在 cad/。 -->
<robot name="half_body_robot">
  <link name="base_link">
    <inertial>
      <origin xyz="0.00095596 0.0049549 0.3159" rpy="0 0 0" />
      <mass value="6.333" />
      <inertia ixx="0.11129" ixy="-7.7266E-08" ixz="3.2225E-08" iyy="0.11553" iyz="1.0901E-05" izz="0.01092" />
    </inertial>
    <visual>
      <origin xyz="0 0 0" rpy="0 0 0" />
      <geometry>
        <mesh filename="package://robot_sim/models/half_body_robot/meshes/base_link.STL" />
      </geometry>
      <material name="">
        <color rgba="0.79216 0.81961 0.93333 1" />
      </material>
    </visual>
    <collision>
      <origin xyz="0.00495 0.02475 0.34" rpy="0 0 0" />
      <geometry>
        <box size="0.1865 0.1195 0.66" />
      </geometry>
    </collision>
  </link>
  <link name="Joint_link1">
    <inertial>
      <origin xyz="0.0034444 9.3449E-05 0.0099326" rpy="0 0 0" />
      <mass value="0.049921" />
      <inertia ixx="1.0121E-05" ixy="7.2687E-08" ixz="6.5364E-09" iyy="8.065E-06" iyz="-1.2928E-10" izz="1.3934E-05" />
    </inertial>
    <visual>
      <origin xyz="0 0 0" rpy="0 0 0" />
      <geometry>
        <mesh filename="package://robot_sim/models/half_body_robot/meshes/Joint_link1.STL" />
      </geometry>
      <material name="">
        <color rgba="0.89804 0.91765 0.92941 1" />
      </material>
    </visual>
    <collision>
      <origin xyz="0 0 0" rpy="0 0 0" />
      <geometry>
        <mesh filename="package://robot_sim/models/half_body_robot/meshes/collision/Joint_link1.STL" />
      </geometry>
    </collision>
  </link>
  <joint name="joint_link1" type="revolute">
    <origin xyz="0.064 0.0655 0.6787" rpy="0 0 0" />
    <parent link="base_link" />
    <child link="Joint_link1" />
    <axis xyz="0 0 -1" />
    <limit lower="-0.17" upper="0.52" effort="5.0" velocity="3.1416" />
    <dynamics damping="0.00621" friction="0.0" />
  </joint>
  <link name="Joint_link2">
    <inertial>
      <origin xyz="-0.0055068 0.018045 -0.03312" rpy="0 0 0" />
      <mass value="0.15207" />
      <inertia ixx="7.0602E-05" ixy="-5.9737E-07" ixz="-1.3105E-06" iyy="8.2496E-05" iyz="2.1988E-08" izz="3.5101E-05" />
    </inertial>
    <visual>
      <origin xyz="0 0 0" rpy="0 0 0" />
      <geometry>
        <mesh filename="package://robot_sim/models/half_body_robot/meshes/Joint_link2.STL" />
      </geometry>
      <material name="">
        <color rgba="0.89804 0.91765 0.92941 1" />
      </material>
    </visual>
    <collision>
      <origin xyz="0 0 0" rpy="0 0 0" />
      <geometry>
        <mesh filename="package://robot_sim/models/half_body_robot/meshes/collision/Joint_link2.STL" />
      </geometry>
    </collision>
  </link>
  <joint name="joint_link2" type="revolute">
    <origin xyz="0.006205 -0.032594 0.0203" rpy="1.5708 0 0" />
    <parent link="Joint_link1" />
    <child link="Joint_link2" />
    <axis xyz="0.03684 0 0.99932" />
    <limit lower="-0.12" upper="0.14" effort="5.0" velocity="3.1416" />
    <dynamics damping="0.0473" friction="0.0" />
  </joint>
  <link name="Joint_link3">
    <inertial>
      <origin xyz="0.0081014 -0.00011124 0.025661" rpy="0 0 0" />
      <mass value="0.14417" />
      <inertia ixx="7.4792E-05" ixy="-1.5943E-06" ixz="-4.6531E-06" iyy="3.9493E-05" iyz="4.9221E-07" izz="8.4643E-05" />
    </inertial>
    <visual>
      <origin xyz="0 0 0" rpy="0 0 0" />
      <geometry>
        <mesh filename="package://robot_sim/models/half_body_robot/meshes/Joint_link3.STL" />
      </geometry>
      <material name="">
        <color rgba="0.89804 0.91765 0.92941 1" />
      </material>
    </visual>
    <collision>
      <origin xyz="0 0 0" rpy="0 0 0" />
      <geometry>
        <mesh filename="package://robot_sim/models/half_body_robot/meshes/collision/Joint_link3.STL" />
      </geometry>
    </collision>
  </link>
  <joint name="joint_link3" type="revolute">
    <origin xyz="0.032075 0.034869 -0.034505" rpy="3.1013 1.5339 3.1416" />
    <parent link="Joint_link2" />
    <child link="Joint_link3" />
    <axis xyz="0 0 1" />
    <limit lower="-3.14" upper="0.52" effort="20.0" velocity="3.1416" />
    <dynamics damping="0.0537" friction="0.0" />
  </joint>
  <link name="Joint_link4">
    <inertial>
      <origin xyz="-0.000940783787226562 -0.0447765119904862 -0.00600963674337346" rpy="0 0 0" />
      <mass value="0.153511059186574" />
      <inertia ixx="0.000150762817522297" ixy="-2.11361169575143E-06" ixz="-3.84578901572125E-07" iyy="5.38674032935161E-05" iyz="-1.78735833347229E-05" izz="0.000180387449553603" />
    </inertial>
    <visual>
      <origin xyz="0 0 0" rpy="0 0 0" />
      <geometry>
        <mesh filename="package://robot_sim/models/half_body_robot/meshes/Joint_link4.STL" />
      </geometry>
      <material name="">
        <color rgba="0.898039215686275 0.917647058823529 0.929411764705882 1" />
      </material>
    </visual>
    <collision>
      <origin xyz="0 0 0" rpy="0 0 0" />
      <geometry>
        <mesh filename="package://robot_sim/models/half_body_robot/meshes/collision/Joint_link4.STL" />
      </geometry>
    </collision>
  </link>
  <joint name="joint_link4" type="revolute">
    <origin xyz="-0.022483 0.00088072 0.0383" rpy="1.1387 -1.5708 -1.1774" />
    <parent link="Joint_link3" />
    <child link="Joint_link4" />
    <axis xyz="0 0 1" />
    <limit lower="0" upper="1.57" effort="20.0" velocity="3.1416" />
    <dynamics damping="0.0536" friction="0.0" />
  </joint>
  <link name="Joint_link5">
    <inertial>
      <origin xyz="0.00037809 -0.0011551 0.092895" rpy="0 0 0" />
      <mass value="0.33427" />
      <inertia ixx="0.00030928" ixy="8.2394E-06" ixz="1.781E-07" iyy="0.00029576" iyz="1.7625E-06" izz="9.2528E-05" />
    </inertial>
    <visual>
      <origin xyz="0 0 0" rpy="0 0 0" />
      <geometry>
        <mesh filename="package://robot_sim/models/half_body_robot/meshes/Joint_link5.STL" />
      </geometry>
      <material name="">
        <color rgba="0.89804 0.91765 0.92941 1" />
      </material>
    </visual>
    <collision>
      <origin xyz="0 0 0" rpy="0 0 0" />
      <geometry>
        <mesh filename="package://robot_sim/models/half_body_robot/meshes/collision/Joint_link5.STL" />
      </geometry>
    </collision>
  </link>
  <joint name="joint_link5" type="revolute">
    <origin xyz="-0.0021024 -0.099078 -0.0235" rpy="1.5708 0.45318 -0.021216" />
    <parent link="Joint_link4" />
    <child link="Joint_link5" />
    <axis xyz="0 0 -1" />
    <limit lower="-1.57" upper="1.57" effort="5.0" velocity="3.1416" />
    <dynamics damping="0.000181" friction="0.0" />
  </joint>
  <link name="Joint_link6">
    <inertial>
      <origin xyz="-0.0058533 -0.030239 -0.0055441" rpy="0 0 0" />
      <mass value="0.084684" />
      <inertia ixx="6.6661E-05" ixy="-7.4313E-06" ixz="-2.7544E-06" iyy="4.1259E-05" iyz="-1.6022E-05" izz="6.4062E-05" />
    </inertial>
    <visual>
      <origin xyz="0 0 0" rpy="0 0 0" />
      <geometry>
        <mesh filename="package://robot_sim/models/half_body_robot/meshes/Joint_link6.STL" />
      </geometry>
      <material name="">
        <color rgba="0.89804 0.91765 0.92941 1" />
      </material>
    </visual>
    <collision>
      <origin xyz="0 0 0" rpy="0 0 0" />
      <geometry>
        <mesh filename="package://robot_sim/models/half_body_robot/meshes/collision/Joint_link6.STL" />
      </geometry>
    </collision>
  </link>
  <joint name="joint_link6" type="revolute">
    <origin xyz="0.023244 0.0046459 0.1705" rpy="-1.5708 0.039128 -1.1176" />
    <parent link="Joint_link5" />
    <child link="Joint_link6" />
    <axis xyz="0 0 1" />
    <limit lower="-1.85" upper="0.09" effort="5.0" velocity="3.1416" />
    <dynamics damping="0.00454" friction="0.0" />
  </joint>
  <link name="Joint_link7">
    <inertial>
      <origin xyz="0.00155440359772166 0.00212264039490928 0.0466948326777497" rpy="0 0 0" />
      <mass value="0.171864303222946" />
      <inertia ixx="0.000123950136020767" ixy="4.63793376638209E-07" ixz="-9.21857512222407E-07" iyy="0.00012450073835415" iyz="-1.85885985842979E-06" izz="1.79492618001144E-05" />
    </inertial>
    <visual>
      <origin xyz="0 0 0" rpy="0 0 0" />
      <geometry>
        <mesh filename="package://robot_sim/models/half_body_robot/meshes/Joint_link7.STL" />
      </geometry>
      <material name="">
        <color rgba="1 1 1 1" />
      </material>
    </visual>
    <collision>
      <origin xyz="0 0 0" rpy="0 0 0" />
      <geometry>
        <mesh filename="package://robot_sim/models/half_body_robot/meshes/collision/Joint_link7.STL" />
      </geometry>
    </collision>
  </link>
  <joint name="joint_link7" type="revolute">
    <origin xyz="-0.0099185 -0.09641 -0.027" rpy="1.5708 -0.46353 -0.0095223" />
    <parent link="Joint_link6" />
    <child link="Joint_link7" />
    <axis xyz="0 0 -1" />
    <limit lower="-1.57" upper="1.57" effort="5.0" velocity="3.1416" />
    <dynamics damping="2.08e-05" friction="0.0" />
  </joint>
  <link name="Joint_link8">
    <inertial>
      <origin xyz="1.0436638775424E-09 -1.08225073347512E-09 -0.0142698997910108" rpy="0 0 0" />
      <mass value="0.00316185062157526" />
      <inertia ixx="6.28868448150906E-08" ixy="1.13589405349719E-09" ixz="-1.12068357654226E-14" iyy="1.82162561725745E-07" iyz="-3.03533586471937E-14" izz="1.36807734352918E-07" />
    </inertial>
    <visual>
      <origin xyz="0 0 0" rpy="0 0 0" />
      <geometry>
        <mesh filename="package://robot_sim/models/half_body_robot/meshes/Joint_link8.STL" />
      </geometry>
      <material name="">
        <color rgba="0.898039215686275 0.917647058823529 0.929411764705882 1" />
      </material>
    </visual>
    <collision>
      <origin xyz="5e-05 0 -0.00975" rpy="0 0 0" />
      <geometry>
        <box size="0.0321 0.0072 0.0195" />
      </geometry>
    </collision>
  </link>
  <joint name="joint_link8" type="revolute">
    <origin xyz="0.0053653 0.010734 0.1325" rpy="-1.5708 0.0095223 -0.46353" />
    <parent link="Joint_link7" />
    <child link="Joint_link8" />
    <axis xyz="0 0 1" />
    <limit lower="-1.047" upper="1.047" effort="1.15" velocity="4.189" />
    <dynamics damping="2.58e-06" friction="0.0" />
  </joint>
  <link name="Joint_link9">
    <inertial>
      <origin xyz="-0.00219742448383065 -0.00811137240372845 -0.00998384575227562" rpy="0 0 0" />
      <mass value="0.00996523941134065" />
      <inertia ixx="1.78390990744941E-06" ixy="8.12004530582248E-08" ixz="-3.48435389420981E-10" iyy="1.44225831738358E-06" iyz="-1.33111757045091E-09" izz="7.20074533033609E-07" />
    </inertial>
    <visual>
      <origin xyz="0 0 0" rpy="0 0 0" />
      <geometry>
        <mesh filename="package://robot_sim/models/half_body_robot/meshes/Joint_link9.STL" />
      </geometry>
      <material name="">
        <color rgba="0.898039215686275 0.917647058823529 0.929411764705882 1" />
      </material>
    </visual>
  </link>
  <joint name="joint_link9" type="revolute">
    <origin xyz="0.0099995 -9.5222E-05 -0.016" rpy="1.5708 1.5517 1.5613" />
    <parent link="Joint_link8" />
    <child link="Joint_link9" />
    <axis xyz="0 0 1" />
    <limit lower="-1.22" upper="1.22" effort="1.15" velocity="4.189" />
    <dynamics damping="1.42e-06" friction="0.0" />
  </joint>
  <link name="Joint_link1.1">
    <inertial>
      <origin xyz="-0.00343168533074528 -0.000763417145341144 0.00927930867813634" rpy="0 0 0" />
      <mass value="0.0485377409759767" />
      <inertia ixx="1.00651350567543E-05" ixy="-7.44483492378586E-08" ixz="6.5364481240416E-09" iyy="7.9610132893721E-06" iyz="1.29227463827224E-10" izz="1.38778103178782E-05" />
    </inertial>
    <visual>
      <origin xyz="0 0 0" rpy="0 0 0" />
      <geometry>
        <mesh filename="package://robot_sim/models/half_body_robot/meshes/Joint_link1.1.STL" />
      </geometry>
      <material name="">
        <color rgba="0.898039215686275 0.917647058823529 0.929411764705882 1" />
      </material>
    </visual>
    <collision>
      <origin xyz="0 0 0" rpy="0 0 0" />
      <geometry>
        <mesh filename="package://robot_sim/models/half_body_robot/meshes/collision/Joint_link1.1.STL" />
      </geometry>
    </collision>
  </link>
  <joint name="joint_link1.1" type="revolute">
    <origin xyz="-0.054 0.0655 0.6792" rpy="0 0 0" />
    <parent link="base_link" />
    <child link="Joint_link1.1" />
    <axis xyz="0 0 -1" />
    <limit lower="-0.52" upper="0.17" effort="5.0" velocity="3.1416" />
    <dynamics damping="0.00632" friction="0.0" />
  </joint>
  <link name="Joint_link2.2">
    <inertial>
      <origin xyz="0.00534835557527144 0.0180450861095298 -0.0288225056560203" rpy="0 0 0" />
      <mass value="0.152067031738728" />
      <inertia ixx="7.06017151906069E-05" ixy="5.97367515920354E-07" ixz="1.31056820610459E-06" iyy="8.2495743213218E-05" iyz="2.20565727072204E-08" izz="3.5101177609552E-05" />
    </inertial>
    <visual>
      <origin xyz="0 0 0" rpy="0 0 0" />
      <geometry>
        <mesh filename="package://robot_sim/models/half_body_robot/meshes/Joint_link2.2.STL" />
      </geometry>
      <material name="">
        <color rgba="0.898039215686275 0.917647058823529 0.929411764705882 1" />
      </material>
    </visual>
    <collision>
      <origin xyz="0 0 0" rpy="0 0 0" />
      <geometry>
        <mesh filename="package://robot_sim/models/half_body_robot/meshes/collision/Joint_link2.2.STL" />
      </geometry>
    </collision>
  </link>
  <joint name="joint_link2.2" type="revolute">
    <origin xyz="-0.006205 -0.032594 0.0198" rpy="1.5708 0 -0.036849" />
    <parent link="Joint_link1.1" />
    <child link="Joint_link2.2" />
    <axis xyz="0 0 1" />
    <limit lower="-0.14" upper="0.12" effort="5.0" velocity="3.1416" />
    <dynamics damping="0.047" friction="0.0" />
  </joint>
  <link name="Joint_link3.3">
    <inertial>
      <origin xyz="-0.00808532683585822 -0.000522848962161482 0.0256610096089075" rpy="0 0 0" />
      <mass value="0.144166310087086" />
      <inertia ixx="7.48251333852183E-05" ixy="1.17804475548008E-06" ixz="4.67735950025543E-06" iyy="3.9460327555505E-05" iyz="-1.26717011028495E-07" izz="8.46431603195059E-05" />
    </inertial>
    <visual>
      <origin xyz="0 0 0" rpy="0 0 0" />
      <geometry>
        <mesh filename="package://robot_sim/models/half_body_robot/meshes/Joint_link3.3.STL" />
      </geometry>
      <material name="">
        <color rgba="0.898039215686275 0.917647058823529 0.929411764705882 1" />
      </material>
    </visual>
    <collision>
      <origin xyz="0 0 0" rpy="0 0 0" />
      <geometry>
        <mesh filename="package://robot_sim/models/half_body_robot/meshes/collision/Joint_link3.3.STL" />
      </geometry>
    </collision>
  </link>
  <joint name="joint_link3.3" type="revolute">
    <origin xyz="-0.033324 0.034869 -0.0333" rpy="3.1019 -1.5708 3.1416" />
    <parent link="Joint_link2.2" />
    <child link="Joint_link3.3" />
    <axis xyz="0 0 1" />
    <limit lower="-0.52" upper="3.14" effort="20.0" velocity="3.1416" />
    <dynamics damping="0.0533" friction="0.0" />
  </joint>
  <link name="Joint_link4.4">
    <inertial>
      <origin xyz="-0.00143911743029029 -0.0449589604576824 -0.0043079236236141" rpy="0 0 0" />
      <mass value="0.153511081788558" />
      <inertia ixx="0.000150755212300197" ixy="-3.08440250286198E-06" ixz="-1.59378413619674E-06" iyy="5.27460458083978E-05" iyz="-1.29869373708219E-05" izz="0.000181516421900835" />
    </inertial>
    <visual>
      <origin xyz="0 0 0" rpy="0 0 0" />
      <geometry>
        <mesh filename="package://robot_sim/models/half_body_robot/meshes/Joint_link4.4.STL" />
      </geometry>
      <material name="">
        <color rgba="0.898039215686275 0.917647058823529 0.929411764705882 1" />
      </material>
    </visual>
    <collision>
      <origin xyz="0 0 0" rpy="0 0 0" />
      <geometry>
        <mesh filename="package://robot_sim/models/half_body_robot/meshes/collision/Joint_link4.4.STL" />
      </geometry>
    </collision>
  </link>
  <joint name="joint_link4.4" type="revolute">
    <origin xyz="0.022483 0.00088072 0.0383" rpy="2.3118 1.5162 2.3125" />
    <parent link="Joint_link3.3" />
    <child link="Joint_link4.4" />
    <axis xyz="-0.035238 0.039111 0.99861" />
    <limit lower="-1.57" upper="0" effort="20.0" velocity="3.1416" />
    <dynamics damping="0.0532" friction="0.0" />
  </joint>
  <link name="Joint_link5.5">
    <inertial>
      <origin xyz="-0.000934017767757644 -0.000777647134207984 0.0928949809556524" rpy="0 0 0" />
      <mass value="0.334270518527969" />
      <inertia ixx="0.000303256646659097" ixy="-1.06302024497025E-05" ixz="1.70375112336947E-06" iyy="0.000301784988139084" iyz="4.84766072688602E-07" izz="9.2528229558421E-05" />
    </inertial>
    <visual>
      <origin xyz="0 0 0" rpy="0 0 0" />
      <geometry>
        <mesh filename="package://robot_sim/models/half_body_robot/meshes/Joint_link5.5.STL" />
      </geometry>
      <material name="">
        <color rgba="0.898039215686275 0.917647058823529 0.929411764705882 1" />
      </material>
    </visual>
    <collision>
      <origin xyz="0 0 0" rpy="0 0 0" />
      <geometry>
        <mesh filename="package://robot_sim/models/half_body_robot/meshes/collision/Joint_link5.5.STL" />
      </geometry>
    </collision>
  </link>
  <joint name="joint_link5.5" type="revolute">
    <origin xyz="-0.0028455 -0.09988 -0.019721" rpy="1.5178 -0.77561 0" />
    <parent link="Joint_link4.4" />
    <child link="Joint_link5.5" />
    <axis xyz="0 0 -1" />
    <limit lower="-1.57" upper="1.57" effort="5.0" velocity="3.1416" />
    <dynamics damping="0.000181" friction="0.0" />
  </joint>
  <link name="Joint_link6.6">
    <inertial>
      <origin xyz="0.0058538608336306 -0.0302388856200711 0.00554417426840685" rpy="0 0 0" />
      <mass value="0.084683785830267" />
      <inertia ixx="6.66612299479523E-05" ixy="7.43177193962426E-06" ixz="-2.75464841832376E-06" iyy="4.12593028873198E-05" iyz="1.6021872569725E-05" izz="6.40617245373055E-05" />
    </inertial>
    <visual>
      <origin xyz="0 0 0" rpy="0 0 0" />
      <geometry>
        <mesh filename="package://robot_sim/models/half_body_robot/meshes/Joint_link6.6.STL" />
      </geometry>
      <material name="">
        <color rgba="0.898039215686275 0.917647058823529 0.929411764705882 1" />
      </material>
    </visual>
    <collision>
      <origin xyz="0 0 0" rpy="0 0 0" />
      <geometry>
        <mesh filename="package://robot_sim/models/half_body_robot/meshes/collision/Joint_link6.6.STL" />
      </geometry>
    </collision>
  </link>
  <joint name="joint_link6.6" type="revolute">
    <origin xyz="0.012896 -0.019889 0.1705" rpy="-1.5708 -0.039146 0.83116" />
    <parent link="Joint_link5.5" />
    <child link="Joint_link6.6" />
    <axis xyz="0 0 -1" />
    <limit lower="-1.85" upper="0.09" effort="5.0" velocity="3.1416" />
    <dynamics damping="0.00451" friction="0.0" />
  </joint>
  <link name="Joint_link7.7">
    <inertial>
      <origin xyz="0.000150004584811236 -0.00271779488021105 0.0533404632426099" rpy="0 0 0" />
      <mass value="0.169243618653449" />
      <inertia ixx="0.000123636605372611" ixy="-2.3967282499919E-07" ixz="-5.4184894578863E-07" iyy="0.000124702933099596" iyz="2.00289553922042E-06" izz="1.78481342383112E-05" />
    </inertial>
    <visual>
      <origin xyz="0 0 0" rpy="0 0 0" />
      <geometry>
        <mesh filename="package://robot_sim/models/half_body_robot/meshes/Joint_link7.7.STL" />
      </geometry>
      <material name="">
        <color rgba="0.898039215686275 0.917647058823529 0.929411764705882 1" />
      </material>
    </visual>
    <collision>
      <origin xyz="0 0 0" rpy="0 0 0" />
      <geometry>
        <mesh filename="package://robot_sim/models/half_body_robot/meshes/collision/Joint_link7.7.STL" />
      </geometry>
    </collision>
  </link>
  <joint name="joint_link7.7" type="revolute">
    <origin xyz="0.009863 -0.09041 0.027" rpy="1.5708 0.26106 0.0095402" />
    <parent link="Joint_link6.6" />
    <child link="Joint_link7.7" />
    <axis xyz="0 0 -1" />
    <limit lower="-1.57" upper="1.57" effort="5.0" velocity="3.1416" />
    <dynamics damping="2.08e-05" friction="0.0" />
  </joint>
  <link name="Joint_link8.8">
    <inertial>
      <origin xyz="1.52732204661277E-09 -1.75342723673921E-09 -0.0142698999920259" rpy="0 0 0" />
      <mass value="0.00316185041445188" />
      <inertia ixx="6.28868834833523E-08" ixy="1.13802345054898E-09" ixz="-1.0969016773897E-14" iyy="1.82162520636194E-07" iyz="-4.01289080831778E-14" izz="1.36807730857415E-07" />
    </inertial>
    <visual>
      <origin xyz="0 0 0" rpy="0 0 0" />
      <geometry>
        <mesh filename="package://robot_sim/models/half_body_robot/meshes/Joint_link8.8.STL" />
      </geometry>
      <material name="">
        <color rgba="0.898039215686275 0.917647058823529 0.929411764705882 1" />
      </material>
    </visual>
    <collision>
      <origin xyz="5e-05 0 -0.00975" rpy="0 0 0" />
      <geometry>
        <box size="0.0321 0.0072 0.0195" />
      </geometry>
    </collision>
  </link>
  <joint name="joint_link8.8" type="revolute">
    <origin xyz="0.0030973 -0.011593 0.1385" rpy="-1.5708 0.0095402 -2.8805" />
    <parent link="Joint_link7.7" />
    <child link="Joint_link8.8" />
    <axis xyz="0 0 1" />
    <limit lower="-1.047" upper="1.047" effort="1.15" velocity="4.189" />
    <dynamics damping="2.58e-06" friction="0.0" />
  </joint>
  <link name="Joint_link9.9">
    <inertial>
      <origin xyz="0.0022916926635651 -0.00836224592195867 -0.0148636776884982" rpy="0 0 0" />
      <mass value="0.00996523962223967" />
      <inertia ixx="1.77257516239378E-06" ixy="-9.91082295272964E-08" ixz="3.89248171359102E-08" iyy="1.45211308503424E-06" iyz="-9.23721187575076E-09" izz="7.21554554537533E-07" />
    </inertial>
    <visual>
      <origin xyz="0 0 0" rpy="0 0 0" />
      <geometry>
        <mesh filename="package://robot_sim/models/half_body_robot/meshes/Joint_link9.9.STL" />
      </geometry>
      <material name="">
        <color rgba="0.898039215686275 0.917647058823529 0.929411764705882 1" />
      </material>
    </visual>
  </link>
  <joint name="joint_link9.9" type="revolute">
    <origin xyz="-0.014999 0.0001431 -0.016" rpy="-0.77223 -1.5196 0.77158" />
    <parent link="Joint_link8.8" />
    <child link="Joint_link9.9" />
    <axis xyz="0.03632 -0.0095339 -0.99929" />
    <limit lower="-1.22" upper="1.22" effort="1.15" velocity="4.189" />
    <dynamics damping="1.42e-06" friction="0.0" />
  </joint>
</robot>
