lovely009/robot2_ws/ros2_ws/src/robot_description/models/full_body_robot/cad/urdf/全身装配（不含头部）.urdf

<?xml version="1.0" encoding="utf-8"?>
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
<robot name="全身装配（不含头部）">
  <link name="base_link">
    <inertial>
      <origin xyz="0.000167101154908974 -0.00481402516135016 -0.0150204846668905" rpy="0 0 0" />
      <mass value="0.774243897727538" />
      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
    </inertial>
    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
  </link>
  <link name="Joint_Link1">
    <inertial>
      <origin xyz="1.39075803990644E-06 0.00142152604526409 0.0421510376754144" rpy="0 0 0" />
      <mass value="0.678061308724817" />
      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
    </inertial>
    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
  </link>
  <joint name="Joint_Link1" type="revolute">
    <origin xyz="0 0 0.0109999999999903" rpy="0 0 0" />
    <parent link="base_link" />
    <child link="Joint_Link1" />
    <axis xyz="0 0 -1" />
    <limit lower="0" upper="0" effort="0" velocity="0" />
  </joint>
  <link name="Joint_Link2">
    <inertial>
      <origin xyz="-3.31227397019869E-06 0.089012638348119 -0.00683001127444149" rpy="0 0 0" />
      <mass value="1.84852983165456" />
      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
    </inertial>
    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
  </link>
  <joint name="Joint_Link2" type="revolute">
    <origin xyz="0 0 0.099" rpy="1.4421 0 -3.1416" />
    <parent link="Joint_Link1" />
    <child link="Joint_Link2" />
    <axis xyz="0 0 1" />
    <limit lower="0" upper="0" effort="0" velocity="0" />
  </joint>
  <link name="Joint_link3.1">
    <inertial>
      <origin xyz="0.0034444220463857 9.34482452908253E-05 0.00993255692201883" rpy="0 0 0" />
      <mass value="0.0499208365404591" />
      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
    </inertial>
    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
  </link>
  <joint name="Joint_link3.1" type="revolute">
    <origin xyz="0.059 0.2107 -0.06" rpy="-1.5708 0 0" />
    <parent link="Joint_Link2" />
    <child link="Joint_link3.1" />
    <axis xyz="0 0 1" />
    <limit lower="0" upper="0" effort="0" velocity="0" />
  </joint>
  <link name="Joint_link3.2">
    <inertial>
      <origin xyz="-0.00214237615936556 0.0103644971384175 -0.0290000487899442" rpy="0 0 0" />
      <mass value="0.241731705278653" />
      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
    </inertial>
    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
  </link>
  <joint name="Joint_link3.2" type="revolute">
    <origin xyz="0.0060466 -0.028296 0.0203" rpy="1.5708 0.0068638 0.036849" />
    <parent link="Joint_link3.1" />
    <child link="Joint_link3.2" />
    <axis xyz="0 0 1" />
    <limit lower="0" upper="0" effort="0" velocity="0" />
  </joint>
  <link name="Joint_link3.3">
    <inertial>
      <origin xyz="0.00800319886376293 0.00126288856145396 0.040861019817255" rpy="0 0 0" />
      <mass value="0.144166281009787" />
      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
    </inertial>
    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
  </link>
  <joint name="Joint_link3.3" type="revolute">
    <origin xyz="0.033492 0.034508 -0.029" rpy="-1.5708 1.3866 -1.5412" />
    <parent link="Joint_link3.2" />
    <child link="Joint_link3.3" />
    <axis xyz="0 0 1" />
    <limit lower="0" upper="0" effort="0" velocity="0" />
  </joint>
  <link name="Joint_link3.4">
    <inertial>
      <origin xyz="0.0102675753745947 -0.0408529233378966 -0.00218418179660924" rpy="0 0 0" />
      <mass value="0.137558383990885" />
      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
    </inertial>
    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
  </link>
  <joint name="Joint_link3.4" type="revolute">
    <origin xyz="-0.022307 -0.002941 0.0535" rpy="1.5708 -1.5414 -1.4397" />
    <parent link="Joint_link3.3" />
    <child link="Joint_link3.4" />
    <axis xyz="0 0 1" />
    <limit lower="0" upper="0" effort="0" velocity="0" />
  </joint>
  <link name="Joint_link3.5">
    <inertial>
      <origin xyz="0.00192714127030499 0.000717206516861968 0.130881880980691" rpy="0 0 0" />
      <mass value="0.196346393783135" />
      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
    </inertial>
    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
  </link>
  <joint name="Joint_link3.5" type="revolute">
    <origin xyz="0.024058 -0.095826 -0.0235" rpy="-1.5708 1.0747 -2.8956" />
    <parent link="Joint_link3.4" />
    <child link="Joint_link3.5" />
    <axis xyz="0 0 -1" />
    <limit lower="0" upper="0" effort="0" velocity="0" />
  </joint>
  <link name="Joint_link3.6">
    <inertial>
      <origin xyz="0.000281177299494992 -0.039120481903435 -0.0092390938818252" rpy="0 0 0" />
      <mass value="0.0379481666476553" />
      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
    </inertial>
    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
  </link>
  <joint name="Joint_link3.6" type="revolute">
    <origin xyz="-0.0056381 0.023024 0.1933" rpy="-1.5708 -0.13505 0.49607" />
    <parent link="Joint_link3.5" />
    <child link="Joint_link3.6" />
    <axis xyz="0 0 1" />
    <limit lower="0" upper="0" effort="0" velocity="0" />
  </joint>
  <link name="Joint_link3.7">
    <inertial>
      <origin xyz="-0.000990888150857322 0.00250041968477394 0.0520050492197102" rpy="0 0 0" />
      <mass value="0.171806355935959" />
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
    <origin xyz="-0.016777 -0.016745 0.1928" rpy="-1.5708 0.13443 -0.53044" />
    <parent link="Joint_link3.5r" />
    <child link="Joint_link3.6r" />
    <axis xyz="0 0 -1" />
    <limit lower="0" upper="0" effort="0" velocity="0" />
  </joint>
  <link name="Joint_link3.7r">
    <inertial>
      <origin xyz="-0.00197616293732661 -0.00182529179703095 0.0523084367101615" rpy="0 0 0" />
      <mass value="0.171785771717246" />
      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
    </inertial>
    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
  </link>
  <joint name="Joint_link3.7r" type="revolute">
    <origin xyz="-0.0058506 -0.090459 0.027" rpy="1.5708 -0.62047 -0.16404" />
    <parent link="Joint_link3.6r" />
    <child link="Joint_link3.7r" />
    <axis xyz="0 0 -1" />
    <limit lower="0" upper="0" effort="0" velocity="0" />
  </joint>
  <link name="Joint_link3.8r">
    <inertial>
      <origin xyz="2.10846094750305E-09 -2.71742461865898E-09 -0.00220344295728048" rpy="0 0 0" />
      <mass value="0.00304488839961943" />
      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
    </inertial>
    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
  </link>
  <joint name="Joint_link3.8r" type="revolute">
    <origin xyz="0 0 0.1388" rpy="-1.5708 -0.16404 2.5211" />
    <parent link="Joint_link3.7r" />
    <child link="Joint_link3.8r" />
    <axis xyz="0 0 1" />
    <limit lower="0" upper="0" effort="0" velocity="0" />
  </joint>
  <link name="Joint_link3.9r">
    <inertial>
      <origin xyz="-0.00499314669638273 -0.0288202979051386 -6.82644781725694E-06" rpy="0 0 0" />
      <mass value="0.0235822009313697" />
      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
    </inertial>
    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
  </link>
  <joint name="Joint_link3.9r" type="revolute">
    <origin xyz="0 0 -0.0044547" rpy="-1.5708 -1.3432 1.7348" />
    <parent link="Joint_link3.8r" />
    <child link="Joint_link3.9r" />
    <axis xyz="0 0 1" />
    <limit lower="0" upper="0" effort="0" velocity="0" />
  </joint>
  <link name="Joint_Link3">
    <inertial>
      <origin xyz="-8.30363796385652E-09 -1.82982179408597E-09 -2.71930536500201E-07" rpy="0 0 0" />
      <mass value="0.0728567496906132" />
      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
    </inertial>
    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
  </link>
  <joint name="Joint_Link3" type="revolute">
    <origin xyz="0 0 0.099" rpy="1.5708 0.31293 -1.5708" />
    <parent link="Joint_Link1" />
    <child link="Joint_Link3" />
    <axis xyz="0 0 1" />
    <limit lower="0" upper="0" effort="0" velocity="0" />
  </joint>
  <link name="Joint_Link4">
    <inertial>
      <origin xyz="-8.40260684826179E-09 -2.74558247664869E-10 -2.68882434872886E-07" rpy="0 0 0" />
      <mass value="0.0934780291598877" />
      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
    </inertial>
    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
  </link>
  <joint name="Joint_Link4" type="revolute">
    <origin xyz="0 0 -0.0735" rpy="1.5708 0 0" />
    <parent link="base_link" />
    <child link="Joint_Link4" />
    <axis xyz="0 0 -1" />
    <limit lower="0" upper="0" effort="0" velocity="0" />
  </joint>
  <link name="Joint_Link5">
    <inertial>
      <origin xyz="-0.0352416209237895 -0.00758766513344294 -3.50994503637022E-06" rpy="0 0 0" />
      <mass value="1.10918804844225" />
      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
    </inertial>
    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
  </link>
  <joint name="Joint_Link5" type="revolute">
    <origin xyz="0 0 0" rpy="1.5708 -1.2579 -1.5708" />
    <parent link="Joint_Link4" />
    <child link="Joint_Link5" />
    <axis xyz="0 0 1" />
    <limit lower="0" upper="0" effort="0" velocity="0" />
  </joint>
  <link name="Joint_link5.1">
    <inertial>
      <origin xyz="0.000534776642640011 5.21380828555178E-05 0.0285511070150257" rpy="0 0 0" />
      <mass value="0.293426003416425" />
      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
    </inertial>
    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
  </link>
  <joint name="Joint_link5.1" type="revolute">
    <origin xyz="-0.035991 -0.024514 0.09202" rpy="0 0 0" />
    <parent link="Joint_Link5" />
    <child link="Joint_link5.1" />
    <axis xyz="0 0 1" />
    <limit lower="0" upper="0" effort="0" velocity="0" />
  </joint>
  <link name="Joint_link5.2">
    <inertial>
      <origin xyz="-0.0125780082474723 -0.104980341133352 -0.0447681677189114" rpy="0 0 0" />
      <mass value="0.822950083145611" />
      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
    </inertial>
    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
  </link>
  <joint name="Joint_link5.2" type="revolute">
    <origin xyz="0.044372 0.0074903 0.0117" rpy="3.0735 1.5708 -3.0424" />
    <parent link="Joint_link5.1" />
    <child link="Joint_link5.2" />
    <axis xyz="0 0 -1" />
    <limit lower="0" upper="0" effort="0" velocity="0" />
  </joint>
  <link name="Joint_link5.3">
    <inertial>
      <origin xyz="0.000185399272111003 0.00031165796198751 0.0854745428539768" rpy="0 0 0" />
      <mass value="0.662763718849488" />
      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
    </inertial>
    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
  </link>
  <joint name="Joint_link5.3" type="revolute">
    <origin xyz="-0.012465 -0.20091 -0.046" rpy="1.5708 -0.35158 -0.061961" />
    <parent link="Joint_link5.2" />
    <child link="Joint_link5.3" />
    <axis xyz="0 0 1" />
    <limit lower="0" upper="0" effort="0" velocity="0" />
  </joint>
  <link name="Joint_link5.4">
    <inertial>
      <origin xyz="0.00186330861118458 -0.0385623667021924 0.00380320141715279" rpy="0 0 0" />
      <mass value="0.101794305752762" />
      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
    </inertial>
    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
  </link>
  <joint name="Joint_link5.4" type="revolute">
    <origin xyz="-0.020094 0.012573 0.2467" rpy="-1.5708 0.17027 -1.874" />
    <parent link="Joint_link5.3" />
    <child link="Joint_link5.4" />
    <axis xyz="0 0 -1" />
    <limit lower="0" upper="0" effort="0" velocity="0" />
  </joint>
  <link name="Joint_link5.5">
    <inertial>
      <origin xyz="-2.59210757561079E-06 -6.83450112856435E-05 0.141951694233333" rpy="0 0 0" />
      <mass value="0.33789326488138" />
      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
    </inertial>
    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
  </link>
  <joint name="Joint_link5.5" type="revolute">
    <origin xyz="-0.003983 -0.096169 0.027" rpy="-1.5708 -1.261 2.9752" />
    <parent link="Joint_link5.4" />
    <child link="Joint_link5.5" />
    <axis xyz="0 0 1" />
    <limit lower="0" upper="0" effort="0" velocity="0" />
  </joint>
  <link name="Joint_link5.6">
    <inertial>
      <origin xyz="0.00370803842173623 -0.0168625100850045 -0.000325758221582984" rpy="0 0 0" />
      <mass value="0.0697698796004313" />
      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
    </inertial>
    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
  </link>
  <joint name="Joint_link5.6" type="revolute">
    <origin xyz="-0.018334 0.0058681 0.285" rpy="-1.5708 -0.16639 1.261" />
    <parent link="Joint_link5.5" />
    <child link="Joint_link5.6" />
    <axis xyz="0 0 -1" />
    <limit lower="0" upper="0" effort="0" velocity="0" />
  </joint>
  <link name="Joint_link5.7">
    <inertial>
      <origin xyz="0.0015602059890269 -0.0171780901558468 0.0270403385037771" rpy="0 0 0" />
      <mass value="0.0310065052583184" />
      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
    </inertial>
    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
  </link>
  <joint name="Joint_link5.7" type="revolute">
    <origin xyz="-0.0057817 -0.057016 -0.02" rpy="1.5708 -1.5167 -1.3652" />
    <parent link="Joint_link5.6" />
    <child link="Joint_link5.7" />
    <axis xyz="0 0 1" />
    <limit lower="0" upper="0" effort="0" velocity="0" />
  </joint>
  <link name="Joint_link5.1r">
    <inertial>
      <origin xyz="0.000520030218761142 -0.000135169643363464 0.0285511070260704" rpy="0 0 0" />
      <mass value="0.293426027660154" />
      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
    </inertial>
    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
  </link>
  <joint name="Joint_link5.1r" type="revolute">
    <origin xyz="-0.035991 -0.024514 -0.09202" rpy="3.1416 0 3.1416" />
    <parent link="Joint_Link5" />
    <child link="Joint_link5.1r" />
    <axis xyz="0 0 1" />
    <limit lower="0" upper="0" effort="0" velocity="0" />
  </joint>
  <link name="Joint_link5.2r">
    <inertial>
      <origin xyz="-0.0140835002940052 -0.0888648996187537 -0.0433807108677924" rpy="0 0 0" />
      <mass value="0.976661892534909" />
      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
    </inertial>
    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
  </link>
  <joint name="Joint_link5.2r" type="revolute">
    <origin xyz="0.043255 -0.0080616 0.0117" rpy="0.18426 1.5708 0" />
    <parent link="Joint_link5.1r" />
    <child link="Joint_link5.2r" />
    <axis xyz="0 0 -1" />
    <limit lower="0" upper="0" effort="0" velocity="0" />
  </joint>
  <link name="Joint_link5.3r">
    <inertial>
      <origin xyz="0.000136510264114154 -0.000291382389993378 0.0845655737465828" rpy="0 0 0" />
      <mass value="0.659048557831036" />
      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
    </inertial>
    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
  </link>
  <joint name="Joint_link5.3r" type="revolute">
    <origin xyz="-0.012465 -0.20091 -0.045" rpy="-1.5708 -0.32077 3.0796" />
    <parent link="Joint_link5.2r" />
    <child link="Joint_link5.3r" />
    <axis xyz="0 0 1" />
    <limit lower="0" upper="0" effort="0" velocity="0" />
  </joint>
  <link name="Joint_link5.4r">
    <inertial>
      <origin xyz="0.015035937839937 -0.0355590380955776 0.00380317865853672" rpy="0 0 0" />
      <mass value="0.101794184689906" />
      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
    </inertial>
    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
  </link>
  <joint name="Joint_link5.4r" type="revolute">
    <origin xyz="0.023552 0.0026785 0.2467" rpy="-1.5708 -0.18149 1.9399" />
    <parent link="Joint_link5.3r" />
    <child link="Joint_link5.4r" />
    <axis xyz="0 0 -1" />
    <limit lower="0" upper="0" effort="0" velocity="0" />
  </joint>
  <link name="Joint_link5.5r">
    <inertial>
      <origin xyz="-4.08169272173575E-05 5.50627700376394E-05 0.141951647785019" rpy="0 0 0" />
      <mass value="0.337892551511855" />
      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
    </inertial>
    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
  </link>
  <joint name="Joint_link5.5r" type="revolute">
    <origin xyz="0.029396 -0.091652 0.027" rpy="-1.5708 1.2086 -2.9562" />
    <parent link="Joint_link5.4r" />
    <child link="Joint_link5.5r" />
    <axis xyz="0 0 1" />
    <limit lower="0" upper="0" effort="0" velocity="0" />
  </joint>
  <link name="Joint_link5.6r">
    <inertial>
      <origin xyz="0.00232901979293743 -0.0171075846880692 0.000325758222140107" rpy="0 0 0" />
      <mass value="0.0697698790530006" />
      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
    </inertial>
    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
  </link>
  <joint name="Joint_link5.6r" type="revolute">
    <origin xyz="0.018001 0.0068204 0.285" rpy="-1.5708 -0.18537 1.933" />
    <parent link="Joint_link5.5r" />
    <child link="Joint_link5.6r" />
    <axis xyz="0 0 1" />
    <limit lower="0" upper="0" effort="0" velocity="0" />
  </joint>
  <link name="Joint_link5.7r">
    <inertial>
      <origin xyz="-0.000586169671311365 -0.0172388349726484 0.0268403394830576" rpy="0 0 0" />
      <mass value="0.031006506362092" />
      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
    </inertial>
    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
  </link>
  <joint name="Joint_link5.7r" type="revolute">
    <origin xyz="-0.0093562 -0.056601 0.02" rpy="-1.5708 -1.5003 1.717" />
    <parent link="Joint_link5.6r" />
    <child link="Joint_link5.7r" />
    <axis xyz="0 0 1" />
    <limit lower="0" upper="0" effort="0" velocity="0" />
  </joint>
</robot>
