lovely009/robot2_ws/ros2_ws/src/robot_description/models/half_body_robot/cad/frames/datum_seeds.yaml

# Units: m. Seeds select measured mesh features; they are not calibrated transforms.
datums:
- motor_id: 1
  joint_index: 1
  parent: base_link
  model: r48
  seed_xyz:
  - 0.0640000547708415
  - 0.06550000952581725
  - 0.6790000000000002
  outward_z:
  - 1.315540594347513e-27
  - 0.0
  - 1.0
  bore_radius: 0.0014
  pcd: 0.0405
  status: bolt_circle_verified
- motor_id: 2
  joint_index: 2
  parent: base_link
  model: r48
  seed_xyz:
  - 0.08820000000000001
  - 0.043001116458079844
  - 0.5964998316783156
  outward_z:
  - 1.0
  - -4.4765962909730975e-29
  - 3.9179682431504967e-28
  bore_radius: 0.0014
  pcd: 0.0405
  status: bolt_circle_verified
- motor_id: 3
  joint_index: 3
  parent: Joint_link2
  model: r58
  seed_xyz:
  - 0.03187491612819372
  - 0.03486103230691437
  - -0.034497699297087916
  outward_z:
  - 0.9985117453001283
  - 0.04024056630625524
  - -0.036810206750894164
  bore_radius: 0.00175
  pcd: 0.0495
  status: bolt_circle_verified
- motor_id: 4
  joint_index: 4
  parent: Joint_link3
  model: r58
  seed_xyz:
  - -0.028477939184370287
  - 0.0011155227429997978
  - 0.03830000804315489
  outward_z:
  - -0.9992332967319684
  - 0.03915122826230193
  - 5.264516133429785e-06
  bore_radius: 0.00175
  pcd: 0.0495
  status: bolt_circle_verified
- motor_id: 5
  joint_index: 5
  parent: Joint_link4
  model: r48
  seed_xyz:
  - -0.002101923549787242
  - -0.09907762782924776
  - -0.023500181666050106
  outward_z:
  - -0.021213204818700326
  - -0.9997749745766554
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
- motor_id: null
  joint_index: null
  parent: Joint_link7.7
  model: vaxor
  seed_xyz:
  - 0.0156165
  - 0.0093475
  - 0.037
  outward_z:
  - 0.96612
  - 0.25811
  - 0
  bore_radius: 0.001225
  pcd: 0.0198
  status: wrist_assembly_unresolved
  frame: joint_link7.7_end_2_candidate
