lovely009/robot2_ws/ros2_ws/src/robot_bringup/bench_manager/feedback_manager.py

"""管理选定模型的 ros2_control/TF 会话；启动不使能电机、不恢复旧目标。"""
from pathlib import Path
import re
import time
import xml.etree.ElementTree as ET

from robot_transmission import Model

from .systemd_units import STATE_NAMES, UNIT_FEEDBACK, SystemdUnits, UnitState

MODEL_ENV = 'BENCH_FEEDBACK_MODEL'
CONTROL_ENV = 'BENCH_CONTROL_EXECUTION'
MOTORS_ENV = 'BENCH_CONTROL_MOTORS'
SESSION_ENV = 'BENCH_MCU_SESSION'
PUBLISH_ENV = 'BENCH_FEEDBACK_PUBLISH'
_MODEL = re.compile(r'[A-Za-z0-9][A-Za-z0-9_.-]*\Z')


class FeedbackInventory:
    """只按连接和测量新鲜度选设备，使能或故障变化不改变会话集合。"""
    def __init__(self):
        self.message = None
        self.received = 0.

    def observe(self, message, now_ns=None, now=None):
        now_ns = time.time_ns() if now_ns is None else now_ns
        now = time.monotonic() if now is None else now
        previous = self.message
        if (message.schema_version != 2 or not message.session_id or not message.sequence
                or not -20_000_000 <= now_ns - message.sync_time_ns <= 300_000_000
                or len(message.states) > 48):
            return False
        if previous and (message.session_id < previous.session_id or
                (message.session_id == previous.session_id and
                 not 0 < (message.sequence - previous.sequence) % 2**32 < 2**31)):
            return False
        ids = [state.motor_id for state in message.states]
        if len(set(ids)) != len(ids) or any(not 1 <= mid <= 64 for mid in ids):
            return False
        self.message, self.received = message, now
        return True

    def current(self, now_ns=None, now=None):
        now_ns = time.time_ns() if now_ns is None else now_ns
        now = time.monotonic() if now is None else now
        message = self.message
        if not message:
            return [], 0
        age = now_ns - message.sync_time_ns
        if not 0 <= now-self.received <= .3 or not -20_000_000 <= age <= 300_000_000:
            return [], message.session_id
        return sorted(state.motor_id for state in message.states
                      if state.online and state.state_age_ms + max(0, age)/1_000_000 < 300), message.session_id


class FirmwareFeedbackManager:
    def __init__(self, models_root: Path | None = None,
                 systemd: SystemdUnits | None = None, stop_control=lambda: None):
        if models_root is None:
            from .model_catalog import default_models_root
            models_root = default_models_root()
        self.models_root = Path(models_root) if models_root else None
        self._systemd = systemd or SystemdUnits()
        self._stop_control = stop_control
        self._desired = ''
        self._source = 'waiting'
        self._reason = '等待选择模型'
        self._error = ''
        self._attempt = None
        self._attempt_count = 0
        self._attempt_at = 0.
        self._healthy_since = None
        self._unhealthy_since = None
        self._health_at = 0.

    @staticmethod
    def validate_name(model: str) -> None:
        if not isinstance(model, str) or (model and not _MODEL.fullmatch(model)):
            raise ValueError('模型必须是单层目录名')

    def _validate(self, model: str) -> None:
        self.validate_name(model)
        if not self.models_root:
            raise ValueError('找不到模型根目录')
        base = self.models_root / model
        driver = base / 'config' / 'motor_driver.yaml'
        urdf = base / 'urdf' / f'{model}.urdf'
        if not driver.is_file() or not urdf.is_file():
            raise ValueError(f'模型 {model} 缺少电机配置或 URDF')
        transmission = Model.load(str(driver))
        ids = list(transmission.actuator_ids.values())
        if (not 0 < len(ids) <= 48 or len(set(ids)) != len(ids)
                or any(not 1 <= mid <= 64 for mid in ids)):
            raise ValueError('固件映射 motor_id 必须唯一、在 1..64 内且最多 48 台')
        joints = {j.get('name'): j for j in ET.parse(urdf).getroot().findall('joint')}
        for name in transmission.joint_names:
            joint = joints.get(name)
            if joint is None or joint.get('type') == 'fixed' or joint.find('mimic') is not None:
                raise ValueError(f'传动输出 {name} 必须是 URDF 独立活动关节')
        return transmission

    def status(self) -> dict:
        unit = self._systemd.probe(UNIT_FEEDBACK)
        env = (self._systemd.environment(UNIT_FEEDBACK)
               if unit.state is not UnitState.ABSENT else {})
        return {'state': 'failed' if self._error else STATE_NAMES[unit.state],
                'model': env.get(MODEL_ENV, '') if unit.state is UnitState.RUNNING else '',
                'desired_model': self._desired, 'source': self._source,
                'execution': env.get(CONTROL_ENV, ''),
                'motor_ids': env.get(MOTORS_ENV, ''),
                'session_id': env.get(SESSION_ENV, '0'),
                'publishes_joint_states': env.get(PUBLISH_ENV, 'true') == 'true',
                'reason': self._reason, 'error': self._error,
                'returncode': unit.returncode}

    def stop(self, *, reset_retry=True) -> None:
        self._stop_control()
        self._systemd.stop(UNIT_FEEDBACK)
        self._healthy_since = None
        self._unhealthy_since = None
        if reset_retry:
            self._attempt = None
            self._attempt_count = 0

    def observe_control_status(self, status):
        now = time.monotonic()
        if not 0 <= now-self._health_at < 2.5:
            self._healthy_since = self._unhealthy_since = None
        self._health_at = now
        ready = (isinstance(status, dict) and status.get('model') == self._desired
                 and status.get('feedback_fresh') is True
                 and status.get('controllers_ready') is True)
        if not ready:
            self._healthy_since = None
            if self._unhealthy_since is None:
                self._unhealthy_since = now
        elif self._healthy_since is None:
            self._healthy_since = now
        if ready:
            self._unhealthy_since = None

    def reconcile(self, model: str, agent_running: bool = False,
                  simulation_running: bool = False,
                  firmware_simulation: bool = False,
                  external_publishers: list[str] | None = None,
                  motor_ids: list[int] | None = None, session_id: int = 0) -> None:
        self._desired = model
        self._error = ''
        hil = simulation_running and firmware_simulation
        publish_states = not hil
        source, reason = 'firmware', 'MCU 反馈与 ros2_control 控制会话'
        if simulation_running and not hil:
            source, reason = 'simulation', '由仿真会话提供关节反馈'
        elif external_publishers:
            source, reason = 'external', '由外部关节源提供反馈'
        elif not model:
            source, reason = 'waiting', '等待选择模型'
        elif not agent_running:
            source, reason = 'waiting', '等待 Agent'
        elif motor_ids == []:
            source, reason = 'waiting', '等待新鲜电机反馈'
        self._source = 'simulation' if hil else source
        self._reason = f'仿真关节反馈；{reason}' if hil else reason
        if source != 'firmware':
            if self.status()['state'] != 'stopped':
                self.stop()
            self._attempt = None
            self._attempt_count = 0
            return
        status = self.status()
        try:
            transmission = self._validate(model)
            available = set(transmission.actuator_ids.values() if motor_ids is None else motor_ids)
            selected = sorted({transmission.actuator_ids[name]
                for group in transmission.groups
                if all(transmission.actuator_ids[name] in available for name in group.actuators)
                for name in group.actuators})
            if not selected:
                self.stop()
                self._source = 'simulation' if hil else 'waiting'
                self._reason = '等待完整传动组的电机反馈'
                return
            ids = ','.join(map(str, selected)) if motor_ids is not None else ''
            session = str(session_id)
            key = (model, ids, session, publish_states)
            now = time.monotonic()
            if self._attempt != key:
                self._attempt_count = 0
            if (status['state'] == 'running' and status['model'] == model
                    and status['execution'] == 'ros2_control'
                    and status['motor_ids'] == ids and status['session_id'] == session
                    and status['publishes_joint_states'] == publish_states):
                if self._attempt != key:
                    self._attempt, self._attempt_at = key, now
                    return
                health_fresh = 0 <= now-self._health_at < 2.5
                if self._healthy_since is not None and health_fresh:
                    if now-self._healthy_since >= 5.:
                        self._attempt_count = 0
                    return
                # 进程存活不代表接口正常；给发现/控制器加载留时间，再重建失效会话。
                if now-self._attempt_at < 8. or (health_fresh and
                        (self._unhealthy_since is None or now-self._unhealthy_since < 3.)):
                    return
            if self._attempt == key:
                if self._attempt_count >= 3:
                    self._error = f'模型 {model} 的关节反馈连续启动失败，已停止自动重试；请检查反馈日志'
                    return
                if now-self._attempt_at < 3.:
                    self._error = f'模型 {model} 的关节反馈中断，正在等待重试'
                    return
            if status['state'] != 'stopped':
                self.stop(reset_retry=False)
            else:
                self._stop_control()
            self._attempt = key
            self._attempt_count += 1
            self._attempt_at = now
            self._healthy_since = None
            self._unhealthy_since = None
            self._systemd.start(UNIT_FEEDBACK, [
                'ros2', 'launch', 'motor_hardware_interface', 'host_trajectory.launch.py',
                f'model:={model}', f'motor_ids:={ids}',
                f'motor_config_file:={self.models_root / model / "config" / "motor_driver.yaml"}',
                f'urdf_file:={self.models_root / model / "urdf" / f"{model}.urdf"}',
                'start_controllers:=false',
                f'publish_joint_states:={str(publish_states).lower()}',
                f'publish_robot_state:={str(publish_states).lower()}',
            ], auto=True, session_env={MODEL_ENV: model, CONTROL_ENV: 'ros2_control',
                                      MOTORS_ENV: ids, SESSION_ENV: session,
                                      PUBLISH_ENV: str(publish_states).lower()})
        except (ValueError, OSError, RuntimeError, ET.ParseError) as exc:
            self.stop(reset_retry=False)
            self._error = str(exc)
