lovely009/robot2_ws/ros2_ws/src/robot_sim/test/fixtures/bus_transport.yaml

motor_simulation:
  command_margin_deg: 5.0
  timing:
    control_hz: 100
    vaxor_feedback_hz: 50
    command_timeout_ms: 150
    feedback_period_ms: 20
    stagger_ms: 2.2
    effort_rate_hz: 200.0
    can_period_ms: 20
  buses:
    - name: arm
      transport: serial_slcan
      endpoint: /dev/ttyACM1
      baud_rate: 3000000
      data_bitrate_index: 5
      probe_adapter: true
      allow_external_canfd: true
  profiles:
    vaxor_axis:
      hard_lower_deg: -90
      hard_upper_deg: 90
      velocity_rad_s: 2.0
      effort_nm: 10.0
      gear_ratio: 80.0
      efficiency: 0.8
      plant: {kp: 30.0, kd: 1.0, torque_constant_nm_per_a: 0.012, current_limit_a: 11.0}
  motors:
    - joint: joint_a
      bus: arm
      protocol: vaxor
      id: 1
      profile: vaxor_axis
      sdo_overrides: {protection_enabled: 0, direction: 1}
