lovely009/robot2_ws/ros2_ws/src/robot_bringup/bench_manager/motor_sim_manager.py

"""监督 `bench-motor-backend.service`（独立的 FDCAN 电机后端）。

「电机后端」= fdcan_motor_sim.py 的独立进程：页面/脚本经 StartMotorBackend 服务
按需单独起停（不依赖仿真——只连板子即可验证固件发现/离线/重连）；HIL（firmware）
+ 物理总线启动仿真时由 StartSimulation 服务默认联动拉起、停止时联动收起（见
hil_motor_backend_request 与 auto_started 标志）。电机表与增删断连命令经
query_motor_sim 转发到控制通道（协议见 micro_ros_agent/README.md）。

进程由 systemd user transient unit 承载；控制通道使用固定路径，不依赖管理器 PID。
"""

import json
import os
import socket

from .agent_manager import enumerate_serial_ports
from .model_catalog import enumerate_simulation_models
from .simulation_manager import enumerate_can_interfaces
from .systemd_units import (
    AUTO_STARTED_ENV, STATE_NAMES, UNIT_MOTOR_BACKEND, SystemdUnits, UnitState,
    config_env, config_from_env,
)

_CONTROL_MAX_RESPONSE_BYTES = 65536
# 电机后端只接物理/虚拟 CAN 端点；纯 vcan 软件闭环的总线电机是 motor_sim
# 节点（随仿真自带），不需要本后端。
_BACKEND_TRANSPORTS = ("socketcan", "slcan")
# 控制通道的固定路径（见模块 docstring）。终端路径与 unit 路径共用它，靠
# fdcan_motor_sim.py 的 flock 互斥，不靠路径区分。
_CONTROL_SOCKET = "/tmp/robot_sim_motor_backend.sock"
_CONFIG_ENV_PREFIX = "BENCH_MOTOR_"


def query_motor_sim(socket_path: str, request: dict,
                    timeout_s: float = 2.0) -> dict:
    """向 FDCAN 模拟器的控制通道发一条命令（Unix socket，一问一答）。

    模拟器一连接一命令（见 fdcan_motor_sim.py 的 _service_control_socket），
    所以每次调用新建连接；连接/超时/非法响应统一抛 RuntimeError。
    """
    payload = (json.dumps(request, ensure_ascii=False) + "\n").encode("utf-8")
    try:
        with socket.socket(socket.AF_UNIX, socket.SOCK_STREAM) as client:
            client.settimeout(timeout_s)
            client.connect(socket_path)
            client.sendall(payload)
            buffer = b""
            while (b"\n" not in buffer
                   and len(buffer) < _CONTROL_MAX_RESPONSE_BYTES):
                chunk = client.recv(65536)
                if not chunk:
                    break
                buffer += chunk
    except OSError as exc:
        raise RuntimeError(f"模拟器控制通道不可用：{exc}") from exc
    if b"\n" not in buffer:
        raise RuntimeError("模拟器控制通道无响应")
    try:
        response = json.loads(buffer.split(b"\n", 1)[0].decode("utf-8"))
    except (UnicodeDecodeError, json.JSONDecodeError) as exc:
        raise RuntimeError("模拟器控制通道返回了非法响应") from exc
    if not isinstance(response, dict):
        raise RuntimeError("模拟器控制通道返回了非法响应")
    return response
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
