lovely009/robot2_ws/(commit log)

2026-08-07 feat: add ROS 2 Humble dual-package CAN-FD simulation workspace
    - upper_body_canfd_gazebo 0.3.0: 14-DOF Gazebo Fortress upper-body sim, dual vcan/CAN-FD emulation, keyframe action player (0..13), keyboard commander, pytest suite (protocols, motion library, CAN frame mapping)
    - can_motor_sim: CAN-FD motor simulator and interactive debug master
    - WSL2/OGRE1 rendering workaround (render_engine:=ogre) documented
2026-08-07 feat: add C++ ros2_control CAN-FD hardware layer
    Add upper_body_canfd_hardware: C++ ports of the RP MIT and 25/30 mm
    wrist protocols plus SocketCAN, and CanFdMotorSystem implementing
    hardware_interface::SystemInterface for one CAN-FD bus each.
    - URDF xacro switches GazeboSimSystem/CanFdMotorSystem via
    use_real_hardware, with per-joint motor_type/can_node_id/direction/
    zero_offset/kp/kd/effort_scale parameters
    - hardware_sim.launch.py: plugin + vcan fake slaves + ros2_control,
    no Gazebo; real_hardware.launch.py: physical can0/can1 bring-up
    (explicit allow_hardware:=true required)
    - gtest suites for protocol codecs, socket layer and the full plugin
    loop against vcan fake slaves
    - do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
2026-08-08 docs: 更新文档以匹配 CAN-FD 硬件后端
    - 新建根 README，说明包结构、main/develop 分支策略与常用命令
    - 重写 upper_body_canfd_hardware README 为中文，补充参数表、
    生命周期与真机使用说明
    - upper_body_canfd_gazebo README 增加 hardware_backend 切换说明、
    更新工程文件清单
2026-08-08 Add reusable C++ CAN-FD motor driver
2026-08-08 Add ros2_control motor hardware interface
2026-08-08 Add C++ CAN-FD Gazebo motor simulation
2026-08-08 通用化 CAN-FD 电机驱动配置与协议映射 (#4)
    * Add configuration-driven CAN-FD driver core
    * Add configuration-driven CAN-FD driver core
    * Add configuration-driven CAN-FD driver core
    * Add configuration-driven CAN-FD driver core
    * Add configuration-driven CAN-FD driver core
    * Add configuration-driven CAN-FD driver core
    * Add configuration-driven CAN-FD driver core
    * Add configuration-driven CAN-FD driver core
    * Wire generic CAN-FD driver package
    * Wire generic CAN-FD driver package
    * Wire generic CAN-FD driver package
    * Remove fixed seven-joint ArmDriver
    * Remove fixed seven-joint ArmDriver
    * Generalize ros2_control motor mapping
    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
2026-08-10 修复 Gazebo C++ 模拟器电机配置注入
2026-08-10 统一使用 C++ 电机仿真后端
2026-08-10 refactor(motor_hardware_interface): 公开 YAML→DriverConfig 解析 API 并补单测
2026-08-10 refactor(motor_canfd_sim): 复用共享解析 API 并新增独立 launch
2026-08-10 refactor(upper_body_canfd_gazebo): 重组 launch 链与控制器配置并反转依赖
2026-08-10 docs: 更新四包分层后的 README、AGENTS 与启动命令
2026-08-10 docs: 记录领域术语、ROS2 规范调研、ADR 与四包分层重构计划
2026-08-10 docs: 规范化工作空间工程文档
    重组根入口、包级职责、运行测试和安全约束，删除重复叙述并修复模拟器 README 的代码块。
2026-08-10 docs: 更新 README 和 launch 文件，规范化渲染引擎设置
2026-08-10 Remove wrist_2530 implementation and associated tests
    - Deleted wrist_2530.cpp and its corresponding test file test_wrist_2530.cpp.
    - Removed all related functionality for the wrist 25/30 mm controller, including command and reply handling, position and velocity conversions, and gain calculations.
    - Eliminated the XML configuration file for the upper_body_canfd_hardware library.
    - Cleaned up test files for CAN-FD motor system, RP MIT, and socket functionality, ensuring no dependencies on the removed wrist functionality remain.
2026-08-11 refactor: 仿真与真机配置解耦，仿真自持电机拓扑
    仿真不再复用 motor_hardware_interface 的电机拓扑配置：新增 motor_canfd_sim/config/motor_canfd.yaml（来源于仿真模型），三个 launch 默认指向它，两侧只共享 load_driver_config 解析 API。
    记录 ADR 0002：参数按五类划分，torque_constant 两侧各自持有（真机标定值 vs 仿真假设），仿真假设参数清单明确接真机前必须替换。
2026-08-11 refactor: 真机 bring-up 入口下沉到 motor_hardware_interface
    hardware.launch.py、driver_controllers.yaml 与 CAN-FD ros2_control 硬件 xacro 片段移入适配层，真机部署只需 drive + 适配层 + 模型描述，不再被模拟器/Gazebo 依赖绑架（ADR 0003）。
    同时清理旧架构残留：删除指向已不存在包的 hardware_sim/real_hardware launch 与幽灵依赖；driver_loopback 改引用 hw 控制器配置，并在模拟器退出时终止整个回环（fail-fast），避免 spawner 无限重试。
2026-08-11 test: 植物模型、拓扑一致性与 launch 时序测试
    从模拟器节点拆出 ROS 无关的 MotorPlantModel 并补 16 个单测（RP MIT、腕部三模式、限幅、扭矩常数换算、置零语义）；新增真机/仿真拓扑一致性及 URDF/controller/仿真顺序一致性静态测试；新增 driver_loopback 启动/终止时序契约测试（含 fail-fast 断言）。
2026-08-11 docs: 同步 README、CONTEXT 与 fail-fast 决策记录
    README 更新配置解耦、真机入口归属、回环实测验证与 fail-fast 说明；CONTEXT 补充真机参数/仿真参数、真机 bring-up、fail-fast 停机术语；记录 ADR 0004（激活失败/反馈超时/模拟器退出采用 fail-fast 语义，否决自动重试）。
2026-08-11 chore: 忽略 brooks-lint 运行历史文件
2026-08-11 docs: 修正协议 PDF 位置引用并标注历史计划
    README/AGENTS 的“根目录 PDF”改为指向 src/motor_canfd_sim/ 内的协议手册；docs/superpowers 的四包分层实现计划标注为历史计划，已被 ADR 0002-0004 取代，避免按过时表述执行。
2026-08-11 test: 拓扑一致性补 driver position 控制器与动作库关节顺序断言
2026-08-11 refactor: 抽取 canfd 激活/反馈超时/关节映射纯逻辑并补单测
    canfd_system.cpp 中激活轮询、反馈超时与 joint↔motor 名称映射抽为
    canfd_logic 纯函数（不依赖 ROS），新增 17 个 gtest 覆盖安全关键路径；
    运行时行为不变，回环冒烟复测通过。
2026-08-11 docs: 归档代码健康度报告（98/100，待办见 ADR 与测试防线）
2026-08-11 refactor: 模拟器帧处理按电机家族抽 SimMotorHandler + registry
    节点中 6 处 kRpMotorType/kMotor2530Type 分支收敛为家族 handler
    （RpSimMotorHandler / Motor2530SimMotorHandler），与 driver 侧
    MotorProtocolRegistry 一一对称；节点只做路由与 ROS 编排。
    行为不变：70 测试全绿，回环 0.3 rad → 0.29865 跟踪正常。
2026-08-11 refactor: load_system_config 一次解析，消除适配层重复 LoadFile 与根校验
    canfd_system.cpp 不再二次解析同一 YAML；timing 与命令增益解析并入
    motor_config.cpp，YAML 根节点校验只保留一处。load_driver_config 保留为
    薄封装，motor_canfd_sim 等既有调用不受影响。新增 5 个单测。
2026-08-11 refactor: motor_canfd_sim 公共 launch_helpers 模块，launch 与测试统一引用
    仿真默认配置路径收敛为 motor_canfd_sim.helpers 的一个函数，三个 launch
    与对应测试不再各自拼写；launch_ros 私有属性访问（_Node__parameters、
    _OnActionEventBase__*、_Node__arguments）集中到 helpers，升级时一处替换。
    motor_canfd_sim 引入 ament_cmake_python 安装该模块。
2026-08-11 feat: 激活阶段最多重试 3 次（1s 窗口），失败后 fail-fast，日志中文化
    on_activate 改为有界重试：每次尝试在 initial_feedback_wait_s（默认 1s）
    窗口内轮询全部关节反馈，连续 3 次未收齐才抛异常并让 controller_manager
    中止。canfd_logic 新增 all_feedback_received / missing_joint_names 纯函数
    （7 个 gtest）；激活/反馈相关日志改为中文；ADR 0004 与 CONTEXT 同步为
    “有界重试后 fail-fast”。
2026-08-11 refactor: 驱动侧 joints 列表由电机拓扑配置生成（单一来源）
    driver_controllers.yaml 不再手抄 14 关节清单：hardware.launch 与
    driver_loopback.launch 从 motor_canfd.yaml 的 motors 顺序生成 joints，
    写入标准嵌套格式参数文件注入 ros2_control_node（launch_ros 列表参数会
    序列化为 !!python/tuple，rcl 无法解析，故用临时参数文件）。
    motor_hardware_interface 新增 python 辅助模块（motor_joints_from_config）；
    拓扑测试改为断言配置生成结果，launch 测试断言 POSITION_JOINTS 常量。
2026-08-11 refactor: 模拟器帧解析抽为纯函数并补单测（sim_frame_decode）
    handler 的帧识别/槽位偏移/命令解析抽到 sim_frame_decode 纯逻辑层，
    handler 只负责应用更新与 socket I/O；新增 8 个 gtest 覆盖 RP 使能/命令
    槽位偏移、2530 控制/命令帧、非本家族帧与越界节点。补齐架构审计
    W1 的测试 seam 缺口。
2026-08-11 feat: 总线接口参数由配置生成，canfd_hardware 支持任意总线数量
    canfd_hardware 宏改为接收 bus_overrides 字符串（递归宏逐条展开），
    launch 从 motor_canfd.yaml 的 buses 段声明 interface_<总线名> 参数并拼接，
    替代写死的 left_interface/right_interface。四个 launch（真机/回环/模型/
    独立模拟器）同步泛化；新增 read_buses/bus_overrides_pieces 辅助与测试。
2026-08-11 fix: plant 对未知电机类型 fail-fast 抛异常
    compute_effort 不再把非 RP 类型静默按 25/30 mm 计算：未知类型立即抛
    invalid_argument，新增对应单测。人形/新家族扩展时漏加分支会启动即暴露。
2026-08-11 docs: 重新分析全工程并按 GitHub 工程格式更新文档
    - 根 README 重写为 GitHub 格式：徽章、目录、Mermaid 架构图、快速开始、测试矩阵、开发流程
    - CONTEXT/AGENTS 补充本轮新术语（joints 单一来源、接口参数、SimMotorHandler）与辅助模块说明
    - 健康度报告按当前代码重跑：98 -> 100，剩余 2 条 Suggestion（动作库限位双写、协议帧生成缺直接单测）
    - 包 README 补齐激活重试、SimMotorHandler 注册、控制器配置共用等细节
    - 验证：colcon test 94/94 通过，md 相对链接全部有效
2026-08-12 feat: 引入 CAN 传输抽象并新增 CANable2 串口传输
    CanTransport 抽象统一 SocketCAN 与 CANable2 串口 slcan 方言；BusConfig 增加 transport/tty 字段；motor_config 与 helpers 支持串口解析；补 2530 协议策略单测、串口单测与真机验证脚本。
2026-08-12 test: 补动作库限位与 URDF 限位跨源断言
2026-08-12 docs: 同步文档基线至 115 项测试并新增 MIT 调参调研与 2530 手册
2026-08-12 refactor: 更名 motor_canfd_drive 为 motor_drive 并精简为两包真机分支
    dev-real 分支只保留 motor_drive 与 motor_hardware_interface：移除仿真两包与 CANable2 串口传输（SerialSlcanTransport/slcan/台架脚本/串口 fixture），BusConfig 回归纯 SocketCAN（interface_name）；URDF 移入适配层并去掉 Gazebo 分支；协议手册移入 motor_drive/docs。58 项测试全绿。
2026-08-12 docs: 新增 ADR 0005 并同步 dev-real 真机分支文档
    根文档精简为两包真机结构；CONTEXT 术语与 AGENTS 指南同步；ADR 0001/0003 增加 dev-real 状态说明。
2026-08-12 docs: develop 更名 dev-sim 并标注仿真线定位
    旧 develop 作为仿真线保留四包结构与串口台架能力；真机线为 dev-real。
2026-08-12 docs: 分支引用随 develop 更名 dev-sim 同步
2026-08-12 feat: 双传输配置化与 URDF 关节清单自动生成
    - BusConfig 恢复 transport/tty，新增 CanTransportRegistry（socketcan/serial_slcan），
    MotorDriver 按配置创建传输，未知类型 fail-fast
    - 移植 dev-sim slcan 编解码与 CANable2 串口传输，恢复 verify_2530_serial.py 台架脚本
    - 默认 motor_canfd.yaml 切到 serial_slcan 双总线（/dev/ttyACM0、/dev/ttyACM1），
    bus_override 只覆盖设备路径
    - launch 重构为 OpaqueFunction：controller joints 与 URDF ros2_control 关节清单
    按实际生效配置生成（control_joints 注入），覆盖路径自动一致
    - 新增 test_slcan、传输注册/解析/launch 覆盖/xacro 一致性测试（81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
2026-08-12 docs: 全量精简文档并新增 ADR 0006
    - 根 README 去掉对外宣传内容（徽章/TOC/License），改为组内开发导航与核心契约
    - 精简 AGENTS/CONTEXT/两包 README，压缩重复与教程式表述
    - 新增 ADR 0006（三自适应闭环与默认 tty），取代 ADR 0005 中移除串口的结论
2026-08-17 feat: 新增 motor_drive 文档 V2.2 20260710.pdf
2026-08-17 docs: 新增电机调试 TUI 上位机设计文档
2026-08-17 docs: 新增电机调试 TUI 上位机实施计划
2026-08-17 test(motor_drive): 新增 motor_probe slcan/vaxor 编解码与 pytest
2026-08-17 feat(motor_drive): motor_probe 新增 RP 编解码
2026-08-17 feat: 配置单一来源迁移 + vaxor 协议增强
    - 拓扑与型号库分离：motor_driver.yaml 为唯一入口，motor_specs_file
    引用型号库 motor.yaml；motor_types 移至型号库
    - 型号经 protocol 字段映射协议类型，参数默认值来自型号库、
    单电机 parameters 可覆盖；bus_override 仍只覆盖设备路径
    - vaxor 协议新增 gear_ratio/gear_efficiency/motor_type_code 可选参数，
    关节侧位置/速度命令乘减速比换算为电机侧（kp/kd/前馈电流不变）
    - 更新全部 fixtures/测试与文档（README、协议规格 PDF 与
    markdown、CLAUDE.md、AGENTS.md）
2026-08-17 feat: 集成仿真栈到 dev（motor_canfd_sim + upper_body_canfd_gazebo）
    dev 集成分支整合 dev-real（真机两包）与 dev-sim（仿真三包）：
    - 引入 C++ 电机模拟器 motor_canfd_sim 与 Gazebo 栈 upper_body_canfd_gazebo
    - 仿真包适配 motor_drive 新接口：motor_canfd_drive → motor_drive、
    MotorCanfdDriver → MotorDriver、kMotor2530Type → kVaxorType（vaxor 协议）
    - 仿真配置迁移到新 schema：motor_canfd.yaml 拆分为
    motor_driver.yaml（拓扑，motor_specs_file 引用型号库）+ motor.yaml
    - 拓扑一致性测试更新：真机 serial_slcan（/dev/ttyACM*）、仿真 socketcan（vcan*）
    - 全量 153 项测试通过
2026-08-17 refactor: 精简仓库文档并将工作空间布局迁入 ros2_ws/
    - 删除针对 dev-sim 的旧健康报告与已被取代/已完成的历史计划
    （docs/health-dashboard-report.md、docs/superpowers/）
    - 根目录文档（README/CLAUDE/AGENTS/CONTEXT）更新为 dev 分支 4 包
    （真机 + 仿真）真实状态；协议名对齐 rp/vaxor，配置文件对齐
    motor_driver.yaml + motor.yaml
    - 以磁盘为准提交 src/ → ros2_ws/src/ 布局迁移（git 识别为重命名，保留历史）
2026-08-17 feat: 集成 micro-ROS Agent（humble 源码构建，serial 传输）
    - 新增独立 colcon 工作区 micro_ros_agent/，源码快照提交
    （micro_ros_msgs + micro-ROS-Agent，humble 分支，已移除第三方 .git）
    - 冒烟验证通过：colcon build 成功，serial 传输经伪终端初始化正常
    - .gitignore 忽略 micro_ros_agent 的 build/install/log
    - README 记录来源/构建/运行/与 ros2_ws 集成说明
2026-08-21 feat: 初始化 micro-ROS 固件框架与 can_bridge_msgs 消息定义
2026-08-22 feat: Add DMA and FDCAN drivers, motor protocol handling, and sensor task implementation
    - Implemented DMA configuration for SPI2 communication in dma.c.
    - Added FDCAN peripheral driver with initialization and interrupt handling in fdcan.c.
    - Ported motor protocol encoding and decoding from ROS2 to motor_protocol.c, supporting RP and vaxor protocols.
    - Created sensor task for handling BMI088 IMU data and temperature control in sensor_task.cpp, integrating FreeRTOS for task management.
2026-08-22 Add WS2812 LED driver and CAN/IMU/Motor bridge implementations
    - Implement WS2812 LED driver with SPI6 interface, including initialization and RGB color setting functions.
    - Create CAN1 debug bridge to publish received frames and handle outgoing messages.
    - Implement IMU bridge to publish sensor data and temperature readings.
    - Add motor bridge to handle joint commands and feedback, integrating with control tasks and CAN communication.
    - Introduce necessary JSON library configuration for WS2812.
2026-08-22 feat: 严格校验 vaxor 模式切换逻辑，确保模式切换按协议时序执行
2026-08-22 docs: 记录固件控制安全整改设计
2026-08-22 docs: 添加固件控制安全实施计划
2026-08-22 chore: 忽略本地 worktree 目录
2026-08-22 test: 建立固件 host 协议测试基线
2026-08-22 feat: 增加可测试的电机控制状态机
2026-08-22 fix: 修复电机故障恢复状态
2026-08-22 refactor: 由控制任务统一执行电机命令
2026-08-22 fix: 统一CAN发送与mailbox测试
2026-08-22 fix: 拒绝超长Classic CAN调试帧
2026-08-22 refactor: 使用静态队列承接 FDCAN 接收
2026-08-22 fix: 保证 IMU 快照一致并支持降级重试
2026-08-22 fix: 限制 IMU SPI 故障阻塞
2026-08-22 feat: 增加固件任务健康监督
2026-08-22 fix: 收紧控制任务心跳阈值
2026-08-22 docs: 更新固件控制安全与验证指南
2026-08-24 docs: 重建 main 为纯仓库介绍（移除代码，反映三区域结构）
2026-08-24 chore: ignore ros2_ws build artifacts, drop firmware rules
    dev/ros_ws 分支不含固件，移除 micro_ros_firmware 忽略规则；
    补充 ros2_ws 主电机栈的 build/install/log 构建产物忽略规则，
    确保只推送源码/配置/文档等必要文件。
2026-08-25 chore: tighten repository ignore rules
2026-08-25 docs: design UR5e motor simulation
2026-08-25 docs: plan UR5e motor simulation
2026-08-26 refactor: extract motor protocol and transport
2026-08-26 refactor: make motor simulation topology generic
2026-08-26 fix: track command timeout per enabled motor
2026-08-26 refactor: share the generic motor simulation node
2026-08-26 feat: add six-axis UR5e motor model
2026-08-26 feat: launch and exercise the UR5e Gazebo arm
2026-08-27 docs: design unified robot arm launch backend
2026-08-27 docs: plan unified robot arm launch backend
2026-08-27 feat: unify robot arm simulation launch
2026-08-27 docs: document unified arm backend launch
2026-08-27 docs: research robot arm simulation debugging practices
2026-08-27 docs: design realistic brake and self collision
2026-08-27 docs: plan realistic arm brake implementation
2026-08-27 test: verify gazebo hold joints feasibility
2026-08-27 feat: gate motor effort with drive lifecycle
2026-08-27 feat: expose motor drive safety interfaces
2026-08-27 feat: coordinate simulated arm brakes
2026-08-27 feat: launch arm backend with brake coordination
2026-08-27 fix: engage simulated brakes before physics starts
2026-08-27 docs: record realistic brake runtime verification
2026-08-27 docs: 删除过时的 humanoid_gazebo 三包架构计划与规格文档
2026-08-28 feat: 将前三轴由 RP 切换为 CERB 协议并修正使能/反馈语义
    - motors.yaml 与文档：shoulder_pan/lift/elbow 改为 CERB（id 1–3），
    Vaxor 配置名由 motor_2530 改为 vaxor（id 4–6）
    - frame_router：CERB 使能位随 MIT 命令帧携带，锁存后失能判定兼容 CERB
    （无独立控制帧，失能随命令帧使能位携带）
    - cerb_protocol：反馈位置按命令侧量程 ±kCerbPositionMaxRad 编码，
    避免 ±360° 肩关节硬限位被 ±π 截断
    - config：plant 校验提示补充 CERB
    - 新增 cerb_axis 测试夹具并更新 frame_router 测试
    - 默认 launch 改为 socket_can/vcan0 且 fault_latching_enabled:=false
    （仅本机联调，正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
2026-08-28 refactor: 重建 dev/robot_ws 为 4 包结构（motor_sim + robot_arm_gazebo 并入 ros2_ws/src）
    - 删除 ros2_ws/src/motor_canfd_sim 与 ros2_ws/src/upper_body_canfd_gazebo
    - 从 dev-sim 引入 motor_sim、robot_arm_gazebo 至 ros2_ws/src（含 RP→CERB 提交 1171c39）
    - 保留 motor_hardware_interface、motor_drive 与 micro_ros_firmware、micro_ros_agent
    - 同步更新 AGENTS.md / README.md / CONTEXT.md / CLAUDE.md 的包结构与启动命令
    - 注：docs/adr、docs/research 为历史记录，保留旧包名不改动
2026-08-31 docs: 统一型号库描述并补全仿真包 README
    - 修正 motor.yaml 定位：型号库描述从"物理规格"改为"协议运行参数/安全阈值"，
    完整规格指引至 motor_drive/docs/
    - micro_ros_agent README 修正传输描述：UART → USB CDC
    - 新增 motor_sim 与 robot_arm_gazebo 包级 README
2026-08-31 docs: 设计数值参数电机拓扑下发
2026-08-31 docs: 设计 W25Q64 OSPI 驱动移植
2026-08-31 docs: 添加 W25Q64 驱动实施计划
2026-08-31 test: 添加 W25Q64 地址边界校验
2026-08-31 feat: 移植 W25Q64 OCTOSPI2 驱动
2026-08-31 fix: 修正 W25Q64 OSPI 超时映射
2026-08-31 feat: 集成 W25Q64 启动探测
2026-09-02 docs: design elbow joint gazebo integration
2026-09-02 feat: add bug report and parameter configuration documentation
    - Created a bug report document outlining critical issues in the micro_ros_firmware, including a detailed description of the `motor_control_reconfigure` null pointer bug and proposed fixes.
    - Introduced a parameter configuration design document to outline the new dynamic motor topology configuration via micro-ROS parameter services.
    - Added a progress document detailing the current status of the parameter configuration implementation, including completed work and current issues.
    - Updated the `microros.meta` file to increase the maximum number of services for the micro-ROS parameter server to 5.
    - Implemented a test to verify tha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
2026-09-02 Add CMake install script for micro_ros_firmware host test directory
    This commit introduces a new CMake install script located at
    'micro_ros_firmware/test/host/build/cmake_install.cmake'. The script
    sets up installation configurations, including install prefix,
    component names, and default permissions for shared libraries. It also
    handles cross-compilation scenarios and generates an install manifest
    file to track installed components.
2026-09-04 重构一9.4
2026-09-05 chore: 移除误提交的构建产物并补全 .gitignore
    - 解除跟踪 micro_ros_firmware/build/ 与 test/host/build/（历史误提交的 CMake 产物）
    - 根/.gitignore 与 firmware/.gitignore 补 build/、.host-build/、test/host/build/ 条目
    - .pio/.host-build 本就未跟踪，gitignore 显式声明防再犯
2026-09-05 feat(msgs): can_bridge_msgs 冻结 ID 化电机接口（12 新增 + 5 旧标废弃）
    - 新增：MotorCommand(Target/Array)、MotorMotionState(Target/Array)、
    MotorStatus(Target/Array)、MotorTopology(Entry/Topology)、MotorEvent、
    MotorPolicy、MotorConfig(Result)，全部 motor_id 键控、无 joint_name
    - 旧 MotorCommand/MotorGains/MotorMode/MotorStatus/CANFrame 头部标 DEPRECATED
    （上层迁移完成前保留，删除待上层切换后）
    - CMakeLists 收录两组消息；QoS 按冻结决策（命令 best-effort、配置 reliable）
2026-09-05 refactor(lib): fdcan/dma/control_mailbox 按 ARD-0007 收敛基础设施
    - fdcan：新增每总线 SPSC RX ring（容量 64，单调序号，满丢新）与
    P0/P1/P2 TX 调度器（P1 latest-wins 槽 + P2 配额）；can_bsp ISR 只盖时戳
    入环不解码，删除旧 FreeRTOS 队列与 fdcanx_* 收发 API
    - dma：资源占用表注释 + DMA 优先级静态断言 + HAL_SPI_MspInit 分发器
    - control_mailbox：新增 SET_ENABLE 契约、拒绝计数三分（invalid/overflow/
    session），并发契约与 clear 语义注释强化
2026-09-05 refactor(lib): motor_control ID 驱动运行时内核 + motor_protocol adapter 接缝
    - motor_control：64 容量 motor_id 注册表、九态生命周期、编译期型号目录
    （无 Vaxor-80）、完整快照校验与 30/100ms 安全级联、断链立即停机、
    CONFIG_CONFLICT 锁存、request_id 配置事务（七码 + verify_required 收敛
    UNCONFIRMED）、纯 C 零外部依赖（ARD-0007 §8/§9/§11/§13/§20）
    - motor_protocol：新增 adapter 函数表（厂家字节/CAN-ID/FD 属性唯一归属地）
    与 vaxor/CREB adapter；SI 关节侧换算（Iq=τ/(Kt·i·η) 修正单位混用）；
    删除零引用的 wrist_kp/kd_to_current_gain
    - 协议核实（2026-09-05）：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
2026-09-05 feat(fw): motor_rt_task 整体替换 control_task（无兼容转发）
    - 1ms 服务：RX ring 有界 drain → 内核 service → SYNC 心跳（10ms 周期维持
    CREB 20ms 状态上报）→ 内核待发帧按 bus/class 路由进 TX 调度器
    （tx_slot = 内核表项索引）→ 事件搬运
    - 10ms 控制边界：会话/授权边沿同步 → 完整快照 apply → 配置 FIFO 有界转发
    - mailbox 写入口短临界区；状态/拓扑/事件只读副本接口供 ROS 桥
    - main/ros_bridge 同步改名与 executor 句柄数动态化；control_task 删除
    （旧 FreeRTOS 队列已在 lib/fdcan 重构提交中移除）
2026-09-05 feat(fw): motor_bridge 按 ID 化消息重建
    - 订阅：/motor_command_array（完整快照→mailbox，越界计数拒绝）、
    micro_ros/motor_policy（SET_ENABLE→gains/limits 逐条展开）、
    micro_ros/motor_config（request_id 校验）、micro_ros/motor_enable
    - 发布：motion_states/motor_status_array/motor_topology(1s 节流)/
    motor_events/motor_config_result；静态序列缓冲，无动态分配
    - executor 句柄数 = 1 timer + bridge 订阅数动态合计
2026-09-05 test: host 套件覆盖内核/adapter/调度器/ring/mailbox（10 目标 45 用例）
    - motor_control：发现/九态/30·100ms 级联/断链/缺席软停/冲突锁存/OFFLINE
    心跳语义/事务七码/软停挂起重试/tx_slot/容量与回绕（45 用例）
    - motor_protocol_adapter：vaxor/CREB 编解码与 SI 换算、软停/失能/使能帧、
    SET_MODE 阶段（18 用例）
    - can_tx_scheduler 新增 8 用例；CMake 收录全部目标
2026-09-05 docs: HANDOFF 进度记录 + AGENTS/README 切换 ID 驱动新口径
    - HANDOFF 新增 §0 进度更新：A~C 固件侧完成、协议核实结论、ros2_ws 暂缓
    与 micro_ros_agent 先行的顺序约定；§4 断点标记解除
    - AGENTS.md/README：删除四电机默认表/joint_commands/静态 RX 队列/100·300ms
    旧口径，改为 ID 化接口、SPSC ring/TX 调度、30/100ms 级联、心跳离线语义；
    补 ghfast.top 镜像补丁说明
2026-09-05 Add URDF model for xiongbuzhengtijiegouzhuangpeiti robot
    - Created a new URDF file defining the robot structure, including links and joints.
    - Each link includes inertial, visual, and collision properties with corresponding mesh files.
    - Defined multiple revolute and continuous joints with specified limits and axes.
2026-09-07 feat(fw): 审查修复 C2/4a/4b + MotorBind 绑定通道；DMA/IMU/WS2812 低耦合重构；删除 5 个废弃消息并重建 ros2_ws 仿真包
2026-09-07 fix(sim): 统一关节命名为小写 joint_link1-4（URDF/xacro/controllers 对齐）；launch 注入 IGN_GAZEBO_RESOURCE_PATH 修复 mesh 解析
2026-09-07 fix(fw): _write 强定义空汇兜底 libmicroros stdio 链接（+AGENTS 记录 stdio/消息缓存坑位）
2026-09-07 fix(fw): ISR RX 帧时戳改用 HAL 时基与 millis() 同基（修复 ~1s 恒定偏移致离线误判）
2026-09-07 fix(fw): 全部 P0 组帧点携带表项索引 tx_slot，修复回告重入队错挂表项 0
    审查 4a/H1：软停/失能/重试等 6 处 P0 组帧点零初始化 tx_slot=0，
    P0 FIFO 满回告 motor_control_requeue_p0 时把 p0_pending 错挂到表项 0。
    - motor_control_internal.h 新增 motor_control_entry_index()（依赖表项
    只增不减不变量），六处组帧点统一按表项索引填写
    - service_p0_retries 重编码路径用循环变量 i（即表项索引）
    - motor_protocol_adapter.h/motor_control.h 注释同步契约
    - host 测试：软停+失能双电机 tx_slot 归位、首拍编码失败重编码路径
2026-09-07 fix(fw): 事件中继环抽纯 C 模块 motor_event_relay——满丢最旧改 head 前移修环形序，生产侧补临界区
    审查 H3：motor_rt_task 内手写事件队列满队时 memmove 平移隐含 head==0
    假设，head≠0 时丢错元素且破坏 FIFO 序；且生产侧裸写、消费侧持锁——
    单侧加锁不构成互斥。
    - 新建 lib/motor_event_relay（纯 C/静态分配/无锁）：满队覆盖 head 槽后
    前移，任何 head 状态下序严格 FIFO；dropped_count 诊断可见
    - motor_rt_task.cpp 三个 static + 手写环替换为 relay；内核环排空（任务
    私有）不加锁，中继环 push/drain 双侧逐调用短临界区互斥
    - motor_rt_task.h 删 MOTOR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
2026-09-07 fix(fw): CREB 速度单位注释统一口径（命令=关节侧直通/反馈=电机侧 rpm÷gear）+ 单位契约钉死测试
    审查 H2：creb_adapter.c 文件头（速度线协议为电机侧 rpm）与 encode 内注释
    （关节侧直通）互相矛盾——行为两端已与 ros2_ws 参照一致，缺陷仅在注释。
    - 文件头改分向声明：命令=关节侧 rad/s 直通 MIT 12 位对称量化（上限=Profile
    π，不乘 gear——×101 会满码饱和失真）；反馈=电机侧 rpm→codec 转 rad/s→÷gear
    - encode 内注释同步，指向契约测试
    - 新增 test_creb_velocity_unit_contract：±2.0 rad/s 非饱和+正负码对称
    （自证不乘 gear）、±10.0 超限饱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
2026-09-07 fix(fw): 故障/冲突锁存冻结 policy_enable，故障清除后必须显式 SET_ENABLE 复运动（ARD §36）
    审查 M1：故障锁存（discovery.c）与冲突锁存（latch_config_conflict）清
    motion_authorized 但不清 policy_enable；而全局 set_authorization(true) 会
    重立全部表项 motion_authorized——故障清除后仅重发全局授权 + 新快照即
    自动复运动，违反 ARD §36「失败不自动恢复运动授权」。
    - 两处锁存各补 policy_enable=false（与离线路径同语义），注释写明依据
    - host 测试 test_fault_recovery_no_motion_without_explicit_enable：
    撤权→再授权 + 新快照 ⇒ 0 运动帧（修复前此路径自动复运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
2026-09-07 fix(fw): 撤权/离线/冲突/故障中止配置事务时回 CONFIG_UNCONFIRMED 终态，上层请求不再悬挂
    审查 M2：revoke_motion、offline、冲突锁存、故障锁存四处直接清 tx_active
    不发结果事件——上层配置请求悬挂到自身超时。ARD 七码无「中止」码且 msgs
    冻结，取 UNCONFIRMED（写入效果无法确认，语义诚实，零契约改动）。
    - finish_tx 去 static 化为 motor_control_finish_tx（internal.h 声明），
    四处中止点统一 if (tx_active) finish_tx(UNCONFIRMED) 收敛
    - 冲突/故障路径时间戳用 frame->rx_tick_ms；finish_tx 注释写明复用面
    - host 测试：撤权中止 / 停心跳离线中止，均断言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
2026-09-07 fix(fw): MotorPolicy 三路请求各自独立 request_id，回绕跳过保留值 0
    审查 M3：policy_cb 复用同一 request 结构体且 request_id 一次赋值——
    SET_ENABLE/SET_GAINS/SET_POSITION_LIMITS 最多 3 条请求同 id，上层无法
    按 id 关联各自的 CONFIG_RESULT 回告。
    - 新增 next_policy_request_id()：发放后检查回绕，跳过契约保留值 0
    （config_cb 与内核 submit_config 均拒 0）
    - policy_cb 三处 submit 前各自独立赋 id
2026-09-07 fix(fw): 未知名/设备未发现的 MotorBind 请求回 PROFILE_REJECTED 事件，兑现消息契约回告语义
2026-09-07 test(fw): mailbox/内核配置枚举逐值 static_assert 双链锁死（固件 + host）
2026-09-07 feat(fw): bridge timer 20ms→10ms，motion_states/IMU 快照发布升至 100Hz（同步 README）
2026-09-07 docs(fw): HANDOFF 记录 2026-09-08 审查修复轮（1 blocker+4 high+5 medium）
2026-09-10 feat(fw): 板级基建重构——480MHz 时钟运行时校验 + MPU 非缓存 DMA/BDMA 区 + CSS/NMI 故障兜底 + DTCM 堆栈布局与溢出断言；钉住 ststm32@19.7.1 与 -Os 优化；新增 can_bridge_msgs（13 个 ID 化有界消息）与 web_host（rosbridge + Web 上位机：姿态/IMU 曲线/电机状态/命令快照）
2026-09-10 fix(fw): 实机定位三处修复——SPI2 板级初始化改显式 imu_spi2_board_init()（SrcWrapper __weak 空体抢先满足符号致 HAL_SPI_MspInit 不入链、SPI2EN 永不置位、BMI088 首笔传输超时锁存，回调仅留兜底）；WS2812 补 SPI6 EOT IRQ 补全两级完成链（缺失致 State 恒 BUSY_TX、首帧后 LED 冻结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
2026-09-11 chore: 删除 RP 协议实现与 RP 系列文档
    - motor_sim：移除 protocol/rp_protocol.hpp/.cpp（协议已收敛至 CERB）
    - motor_drive/docs：移除 rp-series.md 及两份 RP 原始资料 PDF
2026-09-11 chore(fw): 同步固件运行时在途改动并归档已完成的 superpowers 计划
    - micro_ros_firmware 多模块在途改动（motor runtime / IMU / DMA / FDCAN /
    WS2812 / motor_bridge 等）与 host 测试
    - can_bridge_msgs 构建调整（固件 symlink 与 ROS 两侧）
    - 移除已完成的 docs/superpowers plans/specs
    - 补入 16-30mm/25-30mm/CREB 协议手册 PDF
    - .gitignore 忽略 533MB 厂商例程快照 dm-mc02例程/
2026-09-11 chore: 清除 ROS 栈 RP 协议残留并新增 FDCAN1 九电机台架模拟器
    - motor_drive/motor_sim/motor_hardware_interface 移除 RP 协议编解码、
    RpProtocol 策略、rp_feedback_hz、rp-* 型号与 fixtures，仅保留 vaxor/creb；
    motor_sim 安全回归从 RP 帧改写为双 Vaxor 轴；六包 colcon 构建测试通过
    - 生产拓扑 8 台肩肘关节改 creb_r58_101（补 MIT 限幅参数）
    - 新增 micro_ros_firmware/tools/fdcan_motor_sim.py：CANable2 SLCAN 模拟
    CREB1-6 + VAXOR7-9（SYNC 门控、错峰、--no-brs/--fb-period-ms）
    - 新增台架目标与第一轮运行记录（物理层 bus-off 待查终端/共地；
    CANable 16e7497 数据率应用 Y7 而非 Y5）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
2026-09-11 docs: 2026-09-11 工作交接报告（RP 清除 + FDCAN1 九电机台架）
2026-09-11 chore: 协议族统一更名 CERB→CREB 对齐厂商命名——固件 cerb_adapter 注释/宏/函数与 protocol_name、motor_drive 型号库（creb_r48/r58_101）及协议摘要同步改写；ARD-0007/决策基线/运行时交接补 2026-09-11 实施状态说明；原始交接报告与 MIT 整定调研归档 docs/archive，新增九电机台架目标与首轮 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
2026-09-13 feat: web_host 重写为对齐 ID 化固件的 Robot2 Web 上位机——新增 rosbridge_shim 兼容有界字符串 string<31> 并经 launch 以垫片接管 rosbridge 启动，前端 app.js/index.html/style.css 全量重写为左监控（topology/motion/status/events/IMU）右控制（型号绑定/全局授权/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
2026-09-14 feat: web_host 上位机升级四 Tab 布局——监控页新增 IMU 四元数/3D 姿态/人工地平仪与命令历史表，控制页新增逐电机增益 SET_GAINS、位置限位 SET_POSITION_LIMITS（按固件契约统一置 enable:true 防误失能）与 SET_MODE 事务（request_id 关联 motor_config_result 异步回显），事件缓冲扩容至 200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
2026-09-15 fix(fw): 修 BMI088 100Hz ODR 寄存器码并统一 Mahony 陀螺单位换算
    - ACC_100_HZ 编码 0x3→0x8（数据表契约，防 ACC DRDY 停止）
    - Mahony 输入陀螺 °/s→rad/s（四元数微分要求 rad/s），kDeg2Rad 提至文件级
    - 恢复 main 中 sensor_task_start 调用
    - 新增 host 测试：ACC_CONF=0xA8 static_assert 与 IMU 单位边界回归
2026-09-15 refactor(fw): 下行配置话题全裁、拓扑编译期写死、授权改会话派生
    - 下行仅保留 /motor_command_array：删 motor_bind/motor_config/motor_config_result/
    motor_policy/motor_enable 的 ROS 桥订阅与回调、executor 句柄、config_result 发布器；
    内核 bind/submit_config API 与 mailbox FIFO 保留（host 测试覆盖、无 ROS 生产者）
    - 新增 src/motor_static_topology.c 编译期拓扑表（台架：1=cerb_r58_101、2-4=cerb_r48_101），
    内核经 motor_control_set_model_resolver 在发现建档/重连时自动按名绑定；
    表外电机保持未绑定不可控，host 默认 resolver=NULL 不影响既有测试
    - 授权语义改为会话状态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
2026-09-15 refactor(msgs,web): 统一 can_bridge_msgs 唯一源，web_host 控制页精简为命令快照
    - can_bridge_msgs 唯一源收敛到 micro_ros_agent/src：删除 ros2_ws/src 复制包
    （web_host 改以 agent workspace overlay 使用，消除双同名包 flaky 类型解析）
    - 删除已随固件裁剪的 MotorBind/MotorConfig/MotorConfigResult/MotorPolicy 四个
    消息定义及 CMakeLists 条目；MotorCommandArray 注释标注序号门已移除
    - web_host 控制页删除型号绑定/授权使能/增益/限位/模式五张卡，仅保留命令快照；
    「填入 1–9」改为「填入在线电机（原位）」（只填拓扑在线电机、目标取实测位置）；
    移除 CONFIG_RE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
2026-09-16 refactor(fw): 退役编译期静态拓扑表 motor_static_topology 及其 host 测试
2026-09-16 feat(fw): 型号绑定改由内核读设备自报身份（CERB SDO 0x1008）自动完成，退役静态拓扑 resolver 与 bind FIFO；新增 param_bridge 参数服务器骨架
    - motor_control 内核新增 READ_IDENTITY 内部事务：config_step 按不变量复检（在线+可绑定生命周期+本轮未定论+无事务在飞，每拍至多一台）发起，回串剪尾随 NUL/空白后与型号目录 identity_string 整串精确匹配；vaxor 无身份读对象回退"协议内唯一型号"兜底（多型不猜）；未命中目录 → PROFILE_REJECTED 并保持未绑定不可控，定论后不逐帧重试，重连作废旧 profile 重新识别，撤权/离线/冲突路径经 motor_control_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
2026-09-17 feat(fw): 固件参数读写全链路（rclc 参数服务/SDO 回读/W25 持久化/web 参数页）
    - param_bridge：每电机 m<id>.{enable,kp,kd,pos_min,pos_max,vel_limit,
    torque_limit} + system.{save,refresh,last_error,last_error_motor,heap_free}，
    发现后动态注册、low-mem 模式（≤17 台）；set=已受理，CONFIG_RESULT 事件
    收敛/失败回弹；100ms 影子同步
    - REFRESH_PARAMS 事务（mailbox/protocol kind=8）：CERB 四个加速 SDO upload
    （0x607D:01/02、0x6080、0x2538）回读设备影子；codec 补三个反向换算
    - param_store 纯库：m<id>.field 名字模型/校验 + W25 blob（CRC32、present
    位图、双 sector A/B），host 可直测
    - stor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
2026-09-17 refactor(msgs): 退役 MotorBind/MotorPolicy 下行消息与 motor_param_bridge 文档引用
2026-09-17 chore: 移除误入库的 aqtinstall.log 并加入 .gitignore
    Qt 安装器日志（89 行）随某次提交混入仓库根目录，与工程无关；删除并忽略。
2026-09-17 feat(fw): 设备参数以驱动板为准——上电回读比对比型号原值、写入按规格书硬件表钳制、配置事务按总线一问一答、参数对外改工程单位、新增设零点
    上电参数核对（ARD 决策日志 §6.3）
    - 上电/重连绑定后自动回读 CERB 四对象（0x607D:01/:02、0x6080、0x2538），与 W25
    记录逐槽位比**设备端原值**（cnt/RPM/mA）——比关节侧 SI 会在 Kt×减速比系数配错时
    两边一起错、比对恒通过；adapter 每阶段回填 {raw, value_si}，内核按 adapter 声明的
    槽位落袋。
    - 结论三态：一致（或本机无记录）= OK；不一致 = MISMATCH；读不到 = UNVERIFIED。
    **初始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
2026-09-17 feat(fw): DEV_INIT 事件携带不一致槽位位图，web 参数页逐台点名并翻译错误码；设零持久化实测结案
    - 固件 dev_params_match_record 改返回不一致槽位位图，随 DEV_INIT 事件 request_id 带出；
    MotorEvent.msg 补注位图语义，host test 相应断言
    - web 参数页新增「设备参数核对」总览条、状态列悬停明细与设备端原值（cnt/mA）提示，
    「读取」改为先逐台回读驱动板；控制页对未初始化/离线目标点名提示；参数页设为默认页签
    - 文档同步 TBD-ZERO-01 结案：0x2531 写入即由驱动器自行落盘，设零无需额外保存码
    - 新增 zhoubuguanjie_youbi_001 URDF 模型包，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
2026-09-17 test(build): host CTest 改 OBJECT 库与目标函数，源文件列表单点维护
    固件真实 .c 按库组织为 fw_* OBJECT 库（协议/适配器/内核/邮箱/CAN/
    IMU/存储），新增 fw_host_test() 函数声明测试目标，include 随库
    PUBLIC 传播。CMake 3.16 不传递 OBJECT 目标文件，测试显式列出全部
    依赖库（注释已写明）。
    行为保持：仍编译固件真实源码、无桩；14/14 CTest 全绿、0 警告。
    PlatformIO 不编译 test/host，本提交不影响固件产物。
2026-09-17 docs(fw): 修正注释与 README/AGENTS 事实错误，统一文件头与 include guard
    注释（零行为变化）：
    - w25q64/storage 头注释改现状（storage 任务独占、blob v2
    3104B=32B 头+64×48B、保存双触发源），删除「不执行启动探测」失效描述
    - can_tx_scheduler 掉号函数 note_result→note_hw_reject；config kind
    契约 1..6→1..6,8,9 并注明 7 为内核专用
    - micro_ros 四态/LED/w25/octospi/geometry/vendor 头补文件头；
    BMI088 厂商拼写加「勿改名」标注；删除变更日志式注释与外部工作流标记
    - include guard 统一 FILE_H_（8 个头）；ROS2→ROS 2；PID 常量补单位
    - 三桥 poll 顺序契约提进头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
2026-09-17 refactor(fw): 删除无调用代码与只写字段，补防御性返回值检查
    - w25q64：删 block 32k/64k 擦除、chip_erase、memory_mapped_mode
    及只服务它们的命令/超时常量（storage 只用 sector erase）
    - can_bsp：删无读者的 can_bsp_bus_stat/g_bus_stats 与三处 ISR 计数，
    BUS_OFF 自清 INIT 自恢复保留；lib/README 同步去掉 can_stats
    - motor_control：删 7 个只写不读的 record_has_*/record_* SI 镜像
    字段及其写入点（raw 原值与位图表意不变），删 IDENTIFYING 死赋值
    - cerb_adapter：MIT 帧 pack 失败改返回 false（原忽略 bool）
    - sensor_task：删无调用的 imu_healthy/init_error_count getter 及
    仅其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
2026-09-17 refactor(fw): 容量跨库 static_assert，收敛 SDO 基址/命令命名与 PI
    - 64 容量契约编译期锁齐：注册表↔命令 mailbox↔P1 调度槽↔快照目标
    ↔blob 记录（motor_rt_task/storage_task 两处断言）；RX ring
    64 属环深语义不纳入；motor_bridge 12 处裸 64 改 kRosArrayCapacity
    - CERB SDO 删 cerb_adapter 本地 0x600/0x580，统一引用
    motor_protocol.h 的 ID 基址（该头自述唯一来源）；命令字节按
    客户端 CCS/设备端 SCS 方向改名（值不动），删除重复的 0x40 宏
    - π 单一来源 MOTOR_PROTOCOL_PI：profile 6 处裸字面量、param_units
    本地副本一并收敛
    - storage sector B 地址改用 W25Q64_SECT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
2026-09-17 refactor(bsp): 板级库去 FreeRTOS 反向依赖、外设时钟单点化、octospi 状态枚举自立
    三件同批、同台架验证的板级解耦：
    1. 新建 lib/board（board_irq.h：BOARD_ISR_SYSCALL_THRESHOLD=5），
    fdcan.c/dma.c 去掉 #include <STM32FreeRTOS.h>（仅为断言），
    MspInit 运行时 configASSERT 删除（编译期断言已覆盖）；
    main.cpp 加阈值与 configLIBRARY 常量的反向 static_assert。
    2. 删除 fdcan.c 与 imu_spi2_transport.c 各自重复的
    PeriphCLKConfig（PLL2Q 80MHz / SPI123 PLL1Q）——system_clock.cpp
    启动期已单点配置同值，MspInit 只保留外设时钟门。
    3. octospi.h 不再 include w25q64.h，自定义 octo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
2026-09-17 refactor(storage): 抽出 storage_projection 纯 C，快照改注入打破任务环依赖
    环依赖：storage_task 反向 include motor_rt_task.h 并在 storage
    任务上下文直调 motor_rt_copy_param_views。
    - 新建 src/storage_projection.{h,c}：视图↔blob↔boot 投影纯 C，
    无 Arduino/RTOS/HAL 依赖，跨库参数对象顺序断言随迁；storage_task
    只留 Flash 时序与双 sector 职责
    - storage_task_set_param_snapshot() 函数指针注入：perform_save 经
    提供者拍快照，未注册回 FAIL（等价无 Flash 降级）；motor_rt
    task_start 注册——临界区仍在 motor_rt_copy_param_views 内、仍在
    storage 任务上下文执行，行为同构
    -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
2026-09-17 refactor(sensor): 拆出 heater 模块，温度 PID 纯函数化并补 host 测试
    - 新增 src/heater.{h,cpp}：TIM3_CH4/PB1 HardwareTimer 唯一所有者
    （init/duty），heater_pid_update 为不依赖 Arduino 的纯函数
    （HOST_TEST 分段，同 led_task 先例），系数与 [0,500] CCR
    钳位逐字搬移
    - sensor_task 只保留 IMU 重试/DRDY/采样编排，持 PID 状态调 heater，
    删除直接 HardwareTimer 依赖
    - 新增 test_heater_pid（冷板钳上限/热板钳 0/稳态 0/误差递推）
    验证：host 16/16；pio SUCCESS。台架：/imu/temp 2Hz、36.9°C，
    motion_states 94Hz，任务调度正常。PWM 占空比波形需示波器，列为
    残余开放项。
2026-09-17 refactor(kernel): 上下文不透明化 + 公共拓扑副本 API，构建系统强制封装边界
    - motor_control.h 删 entry_t/context_t 全字段布局，改为不透明
    struct motor_control_context 前置声明 + motor_control_instance()
    生产单例；IDENTITY_CAPACITY/take_sorted/dev_params 判定移入
    motor_control_internal.h
    - 新增公共 DTO motor_control_topology_entry_t +
    motor_control_copy_topology()（内核内按 motor_id 升序选择，
    返回 adapter 指针/型号名/能力位/在线/生命周期）；motor_rt
    不再直读 entry 字段，只做协议编号映射与字符串落地
    - motor_rt 持实例指针；test_motor_control 白盒经 CMake -I
    内核 src 访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
2026-09-17 refactor(fw): 全局授权改会话电平每边界纯派生，删除任务层会话缓存
    - 新增 src/session_sync.{h,c}：session_sync_apply() 纯函数——转发
    agent 连接边沿、每边界按 mailbox 会话电平（未知或在线=true）
    设授权；断连边界先 set_agent 后 set_auth 的顺序刻意保留（产生两次
    AUTHORIZATION_LOST，既有行为，host 测试钉死）
    - mailbox 公开 control_mailbox_session_authorized（原 static
    connected-or-unknown 唯一实现，内部两处改调它）
    - motor_rt control_boundary 删除 session_synced/session_connected
    静态缓存与首边界特例：临界区取 events+电平、临界区外 apply
    - 新增 test_session_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
2026-09-17 refactor(cerb): 配置事务改静态阶段描述符表，BUSY 拒绝收 helper，refresh 收尾去魔数
    cerb_adapter：五个 kind 的阶段知识（对象/子索引/读写/保存码/原值槽/
    取值来源）从 8 个分散 switch 收敛为 5 张 static const 描述符表
    （SetZero/PositionLimits/VelocityLimit/TorqueLimit/Refresh），
    stage_count/info/encode/on_response 变成表解释器；新增事务 = 加
    一行表。READ_IDENTITY 分段上传与 SET_MODE 空阶段保持特例。
    - 读回阶段携带配对写值来源，读回比对复用同一换算
    - refresh 原值→SI 按 param_slot 分发（原按 stage 号）
    - SET_MODE 杂散帧保持旧边界（非8B RETRY/8B FAIL）；SAVE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
2026-09-17 docs: 固件文档单点真相重组（归档冻结 ARD/HANDOFF，AGENTS 瘦身为操作手册）
    - ARD-0007（2088 行冻结规范）移 docs/archive 并加归档说明；ADR 0007
    顶部补 2026-09-18 勘误块（20ms 边界、1订4发、参数服务器、SDO 自动
    绑定、storage 持久化、session_sync 授权、BUS_OFF 自清）
    - HANDOFF 并入 validation plan（唯一开放项清单，56 行）后归档；
    docs/handoffs 目录取消
    - AGENTS.md 285→120 行，六节操作手册（构建/台架顺序/micro-ROS 坑/
    存储/文件速查/规范），删除与 README/decision-log 的重复叙述
    - 根 CLAUDE.md 固件章瘦身为指针；docs/README 索引改 archive 结构
    - REA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
2026-09-18 docs: 归档九节点重构回归报告，更新验证计划并迁移 youbi 包至 ament
    - 新增 2026-09-18 固件高内聚重构九节点台架回归报告，并在报告索引登记
    - 电机运行时验证计划勾销断连撤权/快照恢复、BUS_OFF 自恢复等真机已验项，补齐 REFRESH_PARAMS/持久化模拟器结论
    - zhoubuguanjie_youbi_001 由 catkin 迁移 ament，包格式升 3、依赖改 exec_depend、构建类型改 ament_cmake
2026-09-18 refactor(robot_arm_gazebo): 模型改 models/<模型名> 自包含目录，launch 经 model:= 选模型，补模型一致性与发布件测试
    把单模型包重组为模型库：每模型自包含（urdf/meshes/config/cad/README），共享
    config/launch/test 不含模型专有名字，加模型只需拷一个目录；gazebo/display launch
    统一以 model:= 选择并注入 fixed_base/spawn_z/controllers_file；新增
    test_model_consistency（三件套/关节顺序/mesh/限位/standalone/dist 同源）与
    test_launch_models（模型选择链路）兜底；迁移出 zhoubuguanjie_youbi_001 模型目录与
    dist 发布件，删除旧 zhoubuguanjie0 资源及独立 zhoubuguanjie_youbi_001 包，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
2026-09-18 refactor(fw): 控制面重构——下行加多点轨迹与逐电机策略通道，上行补诊断/轨迹状态，参数面按静态动态划界并修 storage 栈溢出
2026-09-18 docs(fw): W25 参数 blob v3 设计——每槽 2 扇区、设备侧安全事实入记录、迁移链
    - 记录 48B → 120B（blob 7712B），槽区 A=0x0-0x1FFF / B=0x2000-0x3FFF
    - 0x2650:01 看门狗/限位保护与 0x2541 方向做成两个新 device_raw 槽位，
    复用现有比对与事件位图通路；不一致 → CONFIG_CONFLICT 拒绝使能
    - 砍掉「只读头选胜者」捷径（不拿未校验 seq 做裁决），改顺序整读+必要时重读
    - g_active_sector 改名 g_active_slot；scratch 复用 + 断言；静态占用净减 4448B
    - 记录被否的方案：零点代（设零不改任何可读对象数值，无法检测旁路设零）
    - 文档索引补入本文档与 R48/R58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
2026-09-18 docs(fw): blob v3 实现计划（8 任务）+ 修正设计文档的 RAM 账目
    - 设计 §5.5 原写「净减 4448B」只算了 storage 缓冲，漏了 PARAM_SLOT_COUNT 4→6
    对所有按槽位数组的连带代价（每表项 +48B × 64）：真实为**净增 +1184B**
    - 计划把该连带代价显式列入 Task 6/8，并把「为什么仍选 D3」的理由改为换复用而非省 RAM
    - 计划含两处易漏的夹具硬编码：test_motor_control 的 kDevIndex/kDevSub/kR58Raw 4→6
2026-09-18 feat(fw): blob v3 记录布局 120B（device_raw 扩至 8 槽 + 型号身份 + MIT 假定标度）
2026-09-18 feat(fw): 设备槽位扩到 6，新增安全开关(0x2650:01)与方向(0x2541)
    - PARAM_DEVICE_SLOT_* / MOTOR_PROTOCOL_PARAM_SLOT_* 两侧同步扩到 6（前四槽
    序号不变，记录按旧序号索引），跨库同序新增两条 static_assert
    - device_raw_present 是 u8，6 槽仍在 8 槽硬顶之内
    - test_param_store 新增：只写安全槽也成记录、值 0 与"未核验"可区分、
    与限值槽互不覆盖、COUNT 与 >=8 越界均拒绝
    - 顺带修正三处随本次改动失效的注释（槽位说明、回读到位判据的 0x0F 字面量）
    已知中间态：cerb adapter 的 kStagesRefresh 仍是 4 阶段，而回读到位判据
    MOTOR_CONTROL_DEV_RAW_ALL 随本次改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
2026-09-18 feat(fw): blob v2→v3 迁移，v1/v2 两条升级路径收敛到同一 v3
    - 新增 param_store_blob_migrate_v2()：校验 v2 头 + v2 CRC 后逐字段搬到 v3，
    失败返回 NULL（不动 out，调用方按"无有效 blob"处理），绝不半迁移
    - v2 镜像布局（48B 记录 / 3104B blob）与 blob_v2_crc 只在本 .c 内私有，
    头文件只声明迁移入口；复用既有 crc32_update，不重实现 CRC
    - device_raw[0..3] 原值透传；device_raw[4..7] 与 model_name/identity_hash/
    mit_*/profile_version/reserved 一律保持 0 = "未知/未核验"（与 v1→v2 时
    device_raw_present = 0 同口径，不另设哨兵值）；seq 沿用来料，不重置
    - test_param_store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
2026-09-18 refactor(fw): blob CRC 覆盖率收敛为单一 crc_over_blob；v2 迁移掩码与断言补全
    评审整改（Task 3 review）：
    - [Important] blob_crc / blob_v1_crc / blob_v2_crc 三份逐字重复的 CRC 覆盖率
    实现，抽成单一 crc_over_blob(header, records, records_bytes)，三处委托。
    逐位行为不变。动机：CRC 覆盖率是持久化格式的完整性原语，将来加头字段时
    三份必须同步改，漏一处该布局就静默校验失败、退回默认值（丢标定）。
    migrate_v1/migrate_v2 的搬运骨架重复按评审意见保留（C 无记录布局泛型，
    两处拷贝的字段集确实不同）。
    - [Minor] migrate_v2 搬运 device_raw_presen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
2026-09-18 test(fw): 钉住 v2→v3 迁移的 device_raw_present 掩码（畸形来料不得谎报"已核验"）
    评审整改追加（Finding 2 的回归测试）：
    - test_blob_migrate_v2 新增畸形输入用例：构造 device_raw_present 位 4/5 置位、
    重算 v2 CRC 使其校验通过的 blob，断言迁移后 PARAM_DEVICE_SLOT_SAFETY /
    DIRECTION 均读不到（且 device_raw[4..5] 仍为 0、读失败不写回出参），
    低 4 位的原有槽照常可读。
    - 真机不可能产生该输入（v2 合法写路径 slot >= 4 即拒）；本用例守的是
    "没人背书的 Flash 内容"这一信任边界，把 & 0x0F 从"假设成立"钉成"强制成立"。
    - 变异验证：临时去掉掩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
2026-09-18 feat(fw): cerb REFRESH 回读纳入 0x2650:01 保护开关与 0x2541 方向
    kStagesRefresh 4→6：两个新槽位只读（SDO upload），SI 值即原值（枚举/标志位
    无单位换算）。同步扩 host 夹具的设备对象表（kDevIndex/kDevSub/kR58Raw[6]、
    feed_device_params、make_device_record），使 refresh_slots 能凑齐新的
    MOTOR_CONTROL_DEV_RAW_ALL（0x3F），dev_init 方能收尾。19/19 host 测试通过。
2026-09-18 fix(fw): 限值写事务只刷本事务写到的槽位，不再抹掉只读安全槽
    update_record_after_write 原先遍历 record_raw_present 全部置位，把
    tx_write_raw[slot] 拷进记录/设备影子；槽 4/5（保护开关/方向）是只读
    REFRESH 槽、tx_write_raw 恒为 0，任何一次限值写都会把它们清零并落盘，
    下次上电即假 CONFIG_CONFLICT。改为按本事务的 written_mask 迭代。
    test(fw): 非零基线回归 + v3 安全槽比对/位图用例；同步 MotorEvent 注释
2026-09-18 feat(fw): 参数槽区改每槽 2 扇区，boot 单缓冲顺序整读，save 双扇区擦写+页校验
    槽 A/B 各占 2 个 4KB 扇区（0x0000/0x2000 起），blob v3 为 7712B；boot 改为
    顺序整读 + 逐个 validate + 必要时重读赢家，接上 param_store_blob_migrate_v2
    的 v3→v2→v1 迁移链；save 先擦两扇区再整写，读回核验按 256B 页做。
    暂存缓冲从四块（g_write_buf/g_verify_buf/slot_a/slot_b）收敛为一块
    g_blob_scratch + g_verify_page——boot 与 save 无时间重叠（load_boot_params
    只在 xTaskCreate 前调用一次，入口 configASSERT(g_task == nullptr) 把关）。
    失败语义不变：任一擦/写/校验失败都回 SAVE_FAIL 且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
2026-09-18 fix(fw): boot 兜底迁移旧布局槽 B(0x1000)，并给迁移结果补 validate 与槽容量断言
    新布局槽 A 覆盖 0x0000–0x1FFF，把旧布局的槽 B(0x1000) 圈了进去——read_slot
    再也读不到它。旧固件下存档次数为奇数的板子（活动槽 = 旧 B）升级后两个新槽
    都无效，持久化参数会被静默清零。现在只在「两新槽皆无效」分支里兜底试一次
    0x1000（walk 同一条 v2→v1 迁移链），采用时置 g_active_slot = 0：数据物理
    上在 0x1000（槽 A 擦除范围内），下次 save 必须写 0x2000 而非擦掉它。
    不把旧 B 当作 slot 1 的内容返回——那会让 use_b/g_active_slot 变 1，首次存档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
2026-09-18 test(bench): 模拟器补 0x2650:01/0x2541/0x6064 与不一致场景开关
2026-09-18 docs(fw): blob v3 落地——布局/回滚代价/擦写实测/新增开放台架项与厂商问题
    同时校正设计文档 §5.5/§6 的实测数字（+4800 B RAM / +360 B Flash、+6144 B 连带、
    23168 B .bss、v1/v2→v3 fan-in 迁移），并给 fdcan_motor_sim.py 的
    --safety-off/--dir-ccw 未命中 CERB 节点补 stderr 告警（避免安全属性假阴性）。
2026-09-18 fix(fw): 保存路径补落设备侧安全开关与方向槽（此前比对基准永不落盘）
    views_to_blob 的设备侧分支只落 POS/VEL/TORQUE 四槽，SAFETY 与 DIRECTION
    从不进 blob，导致 record_raw_present 里这两位恒为 0，
    dev_params_mismatch_mask 永远跳过它们——设计 D4（0x2650:01 / 0x2541 与记录
    不符即 CONFIG_CONFLICT）在生产路径上从未生效。按位图补落这两个纯原值槽
    （无 SI 对应，故不加 isfinite 守卫）。
    host 回归测试补正反两向：位图有 4/5 必须落位图与数值，缺位则记录不得声称核验。
2026-09-18 docs(fw): 台架未能复现升级兜底场景——TBD-STORAGE-02 记明阻塞条件与已确证的一半
    - 2026-09-19 按「旧固件 save → 烧新固件」跑两轮：新固件始终选遗留的 v3 槽 B(0x2000) blob，
    旧 v2 blob 被 seq 仲裁淘汰；故兜底与 v2 迁移在真机上都未复现（记为未通过，不是通过）
    - 阻塞根因：本板槽 B 的 v3 blob 恒有效 → ok_b 恒真。要复现须擦净 W25Q64 前 16 KB 或槽 B 写中途掉电
    - 已确证的一半：旧固件自身 v2 blob 在真 flash 上可写可读（m6 记录 12.5 vs 设备默认 → 单独 CONFIG_CONFLICT）
2026-09-18 fix(fw): UNVERIFIED 事件位图点名未收到的设备对象
    回读失败（UNVERIFIED）此前 detail 恒为 0，0x2650:01 读子索引又是本分支唯一
    未经真机验证的对象（TBD-CONFIG-02）——设备 abort 时与总线抖动不可分辨。改为
    按 refresh_slots 取补集，事件直接点名"哪个对象没到"。MotorEvent.msg 注释补明
    位图两态语义：MISMATCH=对不上、UNVERIFIED=没读到。
2026-09-18 fix(web): DEV_INIT 位图补保护开关/方向槽，恢复文案改指外部工具
    DEV_SLOT_NAMES 只有四槽，真实事件带 bit4/5 时过滤成空表，括注为空；且"写回
    对应项即可恢复"对 0x2650:01/0x2541 是错的——它们不在参数面，重跑写事务改不
    了。补齐六槽、加位图契约注释（指向 MotorEvent.msg），恢复文案按 mask 含 0x30
    改指 cangaroo/厂商工具；同时让 UNVERIFIED(state=4) 渲染"未收到的对象"。
2026-09-18 test(fw): 钉住"记录缺安全槽 ⇒ 不比对"并修夹具/越界枚举
    make_device_record 此前无条件置位槽 4/5，夹具造不出生产必现的迁移形状（缺
    位），"记录没写过就不比"这条负载规则测不到——有人改成"设备有位即冲突"会让
    每台刚升级的 CERB 假报 CONFIG_CONFLICT 而 CI 全绿。加 include_safety_slots
    开关（默认保持原行为）与新用例钉死。另：方向槽透传喂 1 使其具判别力；
    越界枚举用 COUNT/COUNT+1 取代裸字面量 78（越界枚举转换是 UB）。
2026-09-18 fix(fw): 补槽区不重叠 static_assert（kSlotBase 改 constexpr）
    原断言只保证 blob 装得进一个槽，不保证槽 A/B 不重叠：kSlotBase[1] 手滑改小
    （如 0x1000）会让擦 A 连带擦掉 B，双槽冗余静默失效。补一条断言并由
    W25Q64_SECTOR_SIZE 派生；kSlotBase 改 constexpr 以便编译期索引。
2026-09-18 fix(bench): 满量程探针失能帧移入 finally 并自检 MIT 组帧
    序列中途异常时原代码不走到收尾失能帧；若设备侧保护被外部工具关掉就没有
    >500ms 自锁兜底，电机会停在满量程出力。移入 finally 保证退出前必发失能。
    另加已知码值自检：MIT 组帧是手工照抄固件的，会静默漂移。
2026-09-18 docs(fw): 记明保护/方向比对是变更检测 + 修 v3/六对象陈旧文案
    安全语义此前没写清：比对基准是"上次成功落盘时设备里的值"，不是"保护=0"常量。
    补两条：先关保护再触发保存即重新基线化（下次上电不报冲突）；v2 迁移记录两槽
    要等首次保存才比较。明确这是**变更检测**不是"保护必须在位"，列出两种加固方向
    （恒判 MISMATCH / 拒绝 SAFETY=1 落盘）供 owner 定夺、本次不实现——写进 design
    §8.2、README、AGENTS、decision-log 变更记录。顺带修 ADR-0007 的 v2/四对象与
    各处"四个槽位"陈旧注释（现为 v3/六对象）。
2026-09-19 fix(fw): 修 0x2650 读子索引(:01→:00) 并补保护开关可写/栈静态化腾堆
2026-09-19 fix(fw): 参数面容量 416→64，注册集合改显式表（根治每电机 11 项）
    PARAM_BRIDGE_MAX_PARAMS=416 需 136,448 B 而堆池只有 122,880 B，rclc 在 low_mem 下按
    max_params 一次性全量分配且不查 NULL → agent 一连上就写非法地址。改为 64（=10 system +
    10 电机 × 5 项），并在建服前加堆预算拦截，把硬故障变成带诊断的干净失败。
    同时根治根因：注册循环原以 PARAM_FIELD_COUNT 为界，上一提交追加的 6 个 PID 字段被
    自动带进参数树（恒 NaN、纯占槽），每电机 5→11 项而 kMaxMotors 分母仍是 5 → 门限虚高
    到 81、第 37 台起 rclc_add_parameter 失败被 (void) 吞掉。改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
2026-09-19 feat(fw): 轨迹插值改单调三次 Hermite（C¹ 连续，消除路点速度台阶）
    原实现段内线性插值 → 速度是分片常数，每个路点一次台阶；而 MIT 律里 v_des 经 kd 进
    力矩，台阶会变成力矩台阶（位置台阶被 PD 环抹匀，速度前馈不会）。
    切矢在受理轨迹时一次算好（Fritsch–Carlson 限幅：局部极值取 0、否则中心差分并限到
    3×min|Δ|），热路径只做一次 Hermite 求值。选单调三次而非 Catmull-Rom：后者会超调，
    为限位去钳位又会在钳位处留尖角、毁掉 C¹。端点强制零速（两点轨迹因此变 S 形，已确认）。
    host 19/19；Gazebo 对照实验：路点处 |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
2026-09-19 feat(fw)!: 话题命名统一为 micro_ros_up/（上行）与 micro_ros_do/（下行）
    原来发布在 micro_ros/ 下、订阅却在根命名空间的 /motor_*，方向与归属都看不出来。
    现在上行 micro_ros_up/{motion_states,motor_status_array,motor_topology,motor_events,
    diagnostics,trajectory_state,imu/data,imu/temp}，下行 micro_ros_do/{motor_command_array,
    motor_policy,motor_trajectory}；一律相对名（可被 launch remap）。
    BREAKING: 消费者必须同步——web_host/web/app.js 的 TOPICS 已改。
    操作提醒：改话题名后**必须重启 micro-ros agent**，只复位板子会让 agent 保留旧实体名
    （本次就是这个原因让下行一度全部计数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
2026-09-19 feat(sim): Gazebo 作为被控对象——CAN 模拟器的 plant 换成真动力学
    现有模拟器把关节速度写死（fdcan_motor_sim.py:169），看不出插值的效果。新增
    --gazebo 模式：CAN 侧一行未改（SDO/状态帧/ACK/故障注入照旧），只把 plant 换成 Gazebo、
    反馈取自 /joint_states。力矩按 MIT 律 τ=kp(p_des−p)+kd(v_des−v)+τ_ff 算，驱动器内环
    的真实行为未知（cerb-vendor-questions 第 8 条），不在此处猜。
    robot_arm_gazebo：URDF 的 sim_control_joint 宏加 effort 命令接口，controllers.yaml 加
    arm_effort_controller（与 position 控制器互斥切换），新增 scripts/mit_gazebo_probe.py
    （线性 vs Hermite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
2026-09-19 feat(host): 固件话题 ↔ ROS 标准话题适配桥（/joint_states 双向）
    固件接口是 ID 化、无关节名的私有话题（ARD 禁止 MCU 维护 joint_name），而 ROS 生态用
    按关节名索引的标准话题。新增 motor_hardware_interface/scripts/firmware_topic_bridge.py：
    上行 micro_ros_up/motion_states → /joint_states
    下行 /arm_controller/joint_trajectory → micro_ros_do/motor_trajectory
    纯函数放 motor_hardware_interface/topic_bridge.py（与 helpers.py 同模式，节点与测试共用），
    11 个单测覆盖固件会**静默丢弃**的那几类失败：未知关节（点名是哪个）、时间非严格递增、
    NaN/Inf、向量长度不符、点数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
2026-09-19 docs: 48 台规模设计与参数面裁定；同步容量/话题/设备事实
    - 新增 docs/plans/active/48-motor-scale-design.md：48 台容量契约、四个只在 48 台暴露
    的失效点（micro-ROS 单条消息 512 B 上限、DTCM 堆、RX FIFO0 8 深+ISR 遮蔽、node 全局
    唯一）、参数服务器必要性裁定（不必要；保留 system.* 是划算的惰性选择）。
    - 参数面容量在 5 处文档里各写一个值（416/256/224/208/176），统一改成指向
    include/param_bridge.h 这一唯一来源，不再复述数字；validation plan 的「2026-09-18 已解」
    改回未解并说明被台架推翻。
    - cerb-vendor-questions 新增第 8 条：MIT 模式下驱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
2026-09-19 feat(fw): 诊断补三类不可见失败；motion_states→50Hz、控制边界→200Hz
    ## 静默丢弃：根因查清（三层，此前只看得见一层）
    控制类消息的拒绝分三层，而**只有内核那层被导出**：
    ① 外层授权门拒绝 → command_rejected_count（记了，但没导出）
    ② **载荷本身非法**（NaN/时间递减/越权电机）→ 内层 invalid_*_count（记了，**从没有导出路径**）
    ③ 到了内核才被拒（未知 motor_id）→ kernel.*_rejected（✓ 唯一可见的）
    加上调用方 (void) 掉 submit 的返回值，② 这层在台架上表现为「发布成功、既不计数也不出事件」。
    顺带发现 control_ma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
2026-09-19 fix(sim): VAXOR 回显帧补满 12B；串口 EAGAIN 不再打死模拟器
2026-09-19 feat(fw): 导出每总线发送帧数；修诊断序列未接线致两字段互相覆盖
2026-09-19 feat(web): 以臂为中心的单页 + URDF 三维臂视图 + 逐台参数与策略
2026-09-19 docs: 2026-09-20 工作报告（web 臂视图 + 发送侧仪表）
2026-09-19 style(web): 操作台风格重做——去散文、等宽数字、状态色点、说明集中进抽屉
2026-09-19 style(web): 参数与策略移出侧边栏，底部并排两栏
    侧边栏原来塞了「设备参数核对」+ 13 列宽表，在 320–520px 里横向滚动。
    把两面板整体删掉，移到臂视图下方，并拆成互不混淆的两栏：
    - 左「设备参数」：驱动板真值，可回读。ID/型号/状态/来源/四项限值/限位保护
    + 逐台 回读·设零·清错
    - 右「使能与增益」：策略话题，只写不回读。ID/型号/启用/kp/kd + 逐台 策略
    拆开不只是排版：两张表一旦分开，「下发修改」只遍历 #paramRows，结构上保证
    kp/kd 不会再被误送进参数树（固件那三项不在 kParamMotorFields[] 里，必被拒）。
    策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
2026-09-20 feat(msgs): 策略加 confirm_unprotected，状态加设备保护/方向遥测四字段
2026-09-20 feat(fw): 协议层新增 SET_DIRECTION（0x2541:00 写 + 读回核验）
2026-09-20 feat(fw): mailbox/motor_rt 打通 SET_DIRECTION 契约与载荷校验
2026-09-20 feat(fw): 状态话题暴露设备侧保护/方向（正向语义只读遥测）
2026-09-20 feat(fw): 方向基线缺失判未初始化（无记录/旧 blob 都不猜方向）
2026-09-20 fix(fw): 设备写落盘幂等化，消除上电白擦两个扇区
2026-09-20 feat(fw): 上电归一——回读比对之前先写保护/方向，失败即不可使能
2026-09-20 fix(fw): 归一未收尾前拒绝设备参数回读，堵住假不一致反锁归一的死路
2026-09-20 feat(fw): 方向翻转冻结到重新设零（ZERO_STALE），设零成功即解除
2026-09-20 fix(fw): 方向翻转冻结覆盖使能整定窗，成因改走 CONFIG_CONFLICT 事件
2026-09-20 chore: 代提交另一会话（robot-ws-20）的在制品
    按 owner 指示代为提交。该会话的工作（轨迹消息/协议/参数面/web/文档，若与本次
    "上电归一"无关）与同一工作区重叠，未提交会阻塞后续任务——`git add` 按整文件
    暂存，会把在制品带进别人的提交。
    提交前已验证整个树（含这批改动）：host 测试 19/19 绿、`pio run` SUCCESS。
    仅提交已跟踪文件的改动；两个未跟踪工件
    （`ros2_ws/src/web_host/R-arm3_full_trajectory_speed0.5{,.orig}.json`）未纳入。
    内容概览：MotorTrajectory{,Point}.msg、motor_protocol{,._adapter}.{h,c}、
    cerb/vaxor adapter、param_units.h、param_bridge.cpp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
2026-09-20 docs(fw): 上电归一与方向参数的设计与实现计划
2026-09-20 feat(fw): 保护关闭时武装需显式确认（每次都要），拒因不进统一故障码
    关保护 = 该关节没有任何限位在执行（CERB 是设备侧限位，固件没有软限位兜底），
    所以「保护确知为关」的台仍允许武装，但每次都要带确认位，否则拒绝。
    - 新成因 MOTOR_CONTROL_FAULT_UNPROTECTED_UNCONFIRMED(9)：与 STALE_GENERATION
    同待遇，只写 last_failure_reason + 拒绝回告，不进 unified_fault_code、不改
    lifecycle（它不是设备故障，而是一条缺确认的授权请求被本机拒绝）。
    - 判据取设备真值影子（dev_raw_present 有槽 4 且 dev_raw[4] == 1）；未核验过
    不算"确知"，那种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
2026-09-20 feat(fw): 参数面加 m<id>.direction，容量 64→72 槽保住 10 台
    - 新字段 PARAM_FIELD_DIRECTION（追加在 COUNT 前，不重排既有位图契约）；
    名字表加 "direction"；值域与 limit_protect 同口径：只认 0/1、不钳制
    （把 2 钳成 1 会让"写错了"变成"静默改方向"）。
    - 参数面语义：0 = CW，1 = CCW，**原值直通不做反转**（它没有 0x2650 那种
    "1 = 关"的反向陷阱）；设备没回读到该槽位时给 NaN，页面显示 -- 并禁用。
    - 写路径 submit_direction → SET_DIRECTION 事务（写 0x2541:00 + 读回核验，
    仅未运动时受理）；翻向的冻结与设零解除在内核，本层不重复判。
    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
2026-09-20 test(tools): 模拟器保护初值照真机改 1（关），探针加显式写模式
    - fdcan_motor_sim.py：0x2650:00 初值 0 → **1**（真机台架上电实测值：保护关），
    0x2541:00 保持 0（CW）。两个对象都易失，靠固件上电归一写成定态；初值给 0
    会让台架永远复现不出"上电后保护是关的"这个前提。进程重启即等价掉电复现。
    - test_fdcan_motor_sim.py：钉住这两个上电初值（旧值必挂，有判别力）。
    - cerb_sdo_probe.py：默认仍只读；新增 `--write IDX:SUB=VAL`（快速写 0x23 +
    读回核验）。docstring 原来写"永不写设备"——加了写能力就不改它就是撒谎，
    已改成"默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
2026-09-20 feat(web): 方向列可切换 CW/CCW、保护关闭标红、武装二次确认
    - 设备参数表新增「方向」列：点一下切 CW ↔ CCW，写 m<id>.direction；切换前
    弹确认（翻转会镜像设备零点与限位的物理含义，固件随即冻结该台到重新设零）。
    - 保护勾选框 tooltip 补全新语义：上电默认开、取消后每次武装都要确认、下次
    上电自动恢复为开。
    - 武装时若该台保护为关 → 二次确认，并在策略里带 confirm_unprotected
    （固件侧同一道门禁，缺它就是按不下去）。
    - 保护确知为关的行标红（该关节此刻没有任何限位在跑）。
    - 槽位掩码/文案收尾：六槽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
2026-09-20 docs(fw): 上电归一/方向参数/武装二次确认写进 README 与决策日志
    决策日志记下本轮 owner 的 8 条决定，并明确取代 09-19 交接文档 §二 的两条
    （「保护只接受写 0」「保护/方向不进参数面」）。README 加一节讲清顺序契约、
    方向易失与无记录不猜、翻转冻结到设零、关保护需每次确认。
2026-09-20 docs(fw): 清掉三处已作废的'方向没有写路径/不在参数面'旧说法
    owner 于 2026-09-20 给出 0x2541 写命令（23 41 25 00 0X 00 00 00，0=CW/1=CCW），
    方向已进参数面 m<id>.direction 并由上电归一按记录写回。README / validation plan /
    vendor-questions #5 三处仍写着旧结论，一并更正（#5 结案，余下只有台架实测项）。
2026-09-20 fix(fw): 按真机实测删除 ZERO_STALE——0x2541 不改位置坐标系
    真机对照实验（SLCAN 直连设备，不经固件）：同一物理方向转动 node1 关节两次
    （各约 10°），方向位 0 时 Δ=+2394 cnt、改成 1 后 Δ=+2573 cnt —— **同号**，
    即 0x2541 只改驱动的力矩/转动方向，**不改位置计数方向**；0x607D:01/:02
    （±32768）与 0x6064 全程未变（写前后各读两次，值一致）。
    因此本设计原先的前提（"翻转会镜像零点与 cnt 限位 → 必须重新设零"）是从
    cerb_adapter.c 的一句推断来的、手册里没有依据，现被实测证伪。
    - 删除：故障码 ZERO_STALE(8)（**值 8 空置不复用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
2026-09-20 feat(web)+test(fw): 轨迹按链路预算分段播放；钉死位置/速度同向
    **网页（为什么播放没反应）**：轨迹是**一条消息整发**（teachPlay → sendTrajectory），
    而固件的轨迹订阅是 best-effort，micro-ROS 的 BE 流**不分片**（fragmented 退回对 BE
    判 INVALID）——单条必须塞进一个 MTU。serial MTU = 512 B，每路点线上 20 B + 约 40 B
    固定开销 → **一次最多约 23 个路点**，4 台电机即 5 行。55 行 × 4 台 = 220 点 ≈ 4.4 KB，
    超 9 倍 → **静默丢弃**（固件收不到，页面也无从知道），所以"播放"什么也不发生。
    现有 256 点的自查是固件侧的整条丢弃上限，够不到链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
2026-09-20 fix(web): rosbridge 掉线自动重连 + 掉线即清场（陈旧表比空表更误导）
    roslibjs 自身不重连：rosbridge 一重启（改 msg/launch 都会重启），页面静默变哑——
    表还在（ID 来自 paramCache），但型号/生命周期/位置全空，看着像"固件没数据"。
    现在 close 时按 2s 退避自动重连，并清空 state.motors/paramCache 后重渲染；
    用户主动点"断开"则不重连。
2026-09-20 feat(fw): 轨迹订阅改 reliable + 输入流缓冲 24 KB——大轨迹不再被静默丢弃
    轨迹是**一条大消息**（1080 路点 ≈ 21.6 KB），而 best-effort 流**不分片**
    （fragmented 退回对 BE 判 INVALID）→ 超过一个 MTU(512 B) 就被静默丢弃：固件收不到、
    上位机也无从知道（"点了播放没反应"）。网页侧的分段只是权宜之计，对高密度轨迹会
    每段端点切矢归零 → 段数一多就一顿一顿（1080 点会切成 68 段）。
    - `motor_bridge.cpp`：轨迹订阅 `qos_stream()`（BE）→ `qos_reliable(1)`。
    发布侧 rosbridge 默认就是 RELIABLE + TRANSIENT_LOCAL，能配上。
    - `microros_user.meta`：加 `-DRMW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
2026-09-20 fix(web): 按固件 256 点上限分段（不再拒绝大轨迹），段尾挑在最安静的行上
    固件单条轨迹硬上限 = MOTOR_CONTROL_MAX_TRAJECTORY_POINTS 256：点数组在**四处**
    各存一份（内核/mailbox 双缓冲/bridge/切矢），加到 1024 要约 84 KB RAM，DTCM 池
    放不下——所以这是硬约束，不是可以调大的量。
    - `trajRowsPerSegment` 改为 min(固件 256 点, 链路 22 KB) 决定每段行数，
    4 台电机 → 64 行/段（256 点，正好卡上限）。
    - 新增 `pickSegmentEnd`：段尾不固定切，而是在 [起点+半段, 起点+整段] 里挑**位移
    最小**的一行。段边界处固件把端点切矢归零（F–C），落在真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
2026-09-20 fix(web): 分段循环加护栏——断点不前进就停下报错，不再卡死标签页
    分段是页面里的 while/setTimeout 循环，断点不前进会无限循环（旧版搜索区间为空时
    返回起点），表现是**整个标签页卡死**、websocket 还连着但页面不响应——昨晚就是这样
    把页面搞挂的。现在 nextRow 不前进或段数 > 2000 立即停止并报错。
2026-09-20 fix(fw): 身份读取失败改为退避重试 ≤3 次；web 自动重连幂等化
    **固件（真机踩到的问题）**：`finish_identity_read` 此前**成败皆置** identity_read_done，
    而身份循环对 done 是硬跳过——于是**一次瞬态失败**（超时 / 被设备 ABORT / CANable 拔插
    扰动总线）会让该台在**整场上电周期**里卡在 IDENTIFYING：型号空、保护状态未知、总线上
    再无任何 SDO，只有"重连"能救。真机复现：m1 卡住、设备自报 `R58LITE…` 与目录里的
    `R58LITE_V2` 一致（不是"陌生型号"），事件流里也没有失败洪流——正是这条路径。
    - 失败（超时/ABORT/回串超容量）→ 计一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
2026-09-20 fix(fw,web): 输入缓冲 24 KB → 6 KB，单条轨迹严格 ≤ 固件 256 点容量
    **上一版是我引入的故障**：把 STREAM_HISTORY_INPUT 放到 48（24 KB）并让网页按
    22 KB 发，于是 1080 点（21.6 KB）**一条整发**给只有 256 点数组容量的内核 —— 远超
    容量的消息把 MCU 打死（2026-09-20 真机：一按播放，页面与固件同时卡死，只能复位）。
    之前那份 220 点文件从没炸过，是因为它在链路层就被丢了（BE 512 B 上限），根本没到
    固件——所以问题是"整条送达 + 超容量"这个新组合才暴露的。
    对齐（三处必须一致）：
    - 固件 MAX_TRAJECTORY_POINTS = 256（四处各存一份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
2026-09-20 fix(web): 段数改为精确计算（开工前把切点全算完），修掉"6/5 段"
    切点只取决于 rows/per（确定性），但此前用 ceil(行数/per) 估算总段数，而实际切点
    落在更早的"最安静行"上 → 真实 9 段却显示"6/5 段"。现在 planSegmentEnds() 在播放前
    一次算完，播放循环按预计算切点走，段数精确、也不再每段重算。
    实测这份 1080 点文件：per=63 → **9 段**，每段 132–156 点（≈2.6–3.1 KB，远低于
    固件 256 点上限与 6 KB 缓冲），末段 12 点。
    注释同步订正：分段的原因是**固件点数组上限 256**，不是链路带宽。
2026-09-20 fix(web): 每段点数留 4 点余量（253 而非正好 256）
    正好卡在固件上限是危险的边界：一旦超一点就是写穿内核的定长点数组（256），
    表现是整块板子卡死、只能复位。4 台电机下 63 行/段 = 252 点。
2026-09-20 fix(web): 播放改走快照通道逐行流式——轨迹通道超过一个 MTU 会把 MCU 写死
    真机实测（我直接用 rosbridge 发，绕开页面）：
    3 点 / 60 B → 受理并 completed ✓
    252 点 / 5 KB → **板子挂死**（status 停发，只能复位）✗
    而 252 < 固件 MAX_TRAJECTORY_POINTS 256，所以**不是点数问题，是消息体积**：
    本板 micro-ROS 的 reliable 分片路径不可用，单条超过一个 MTU(512 B) 就写死 MCU。
    `RMW_UXRCE_STREAM_HISTORY_INPUT` 从 4 改到 12/48 都不生效（heap_free 不变），
    所以无法靠加大输入缓冲绕过——这条路我试了三次，都通不过是我的判断错误。
    - 播放改为逐行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
2026-09-20 feat(web): 播放改为 ~100 Hz 页面侧插值 + 速度前馈（治"运动太差"）
    上一版是"按行发、速度字段全 0、间隔 ~33ms 且带浏览器定时器抖动"——位置型点对点
    下发会让驱动器每拍都追一次位置，看着就是抖/顿。两处改动：
    - **速度前馈**：由录制时间线算中心差分（端点单侧差分），随位置一起下发。该字段直通
    MIT 的 kd·v_des 项，是跟随质量的关键（实测这份录制的斜率约 ±1.4~2.3 rad/s）。
    - **页面侧插值到 ~100 Hz**：按 performance.now() 的实际经过时间定位区间并线性插值，
    把 33ms 的路点加密到 10ms 节拍，抖动的绝对量不变但被 3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
2026-09-20 chore(web): 新增 R-arm3 多档速度/50Hz 完整轨迹 JSON 样本文件
2026-09-20 refactor(motor_protocol): 写事务摘掉 0x2539，保存独立成 SAVE_DEVICE_FLASH 事务
2026-09-20 feat(control_mailbox): 透传设备侧保存事务（SAVE_DEVICE_FLASH）
2026-09-20 feat(motor_control): 无记录判 NO_RECORD 未初始化（首次上电也要人工核对）
2026-09-20 feat(motor_control): 写与保存分离——写只置脏位，保存经 system.save 落盘
2026-09-20 fix(motor_control): 保存事务补回运动中禁写门
    0x2539 以前只作为写事务的尾巴发出，写事务本就被 device_limit_write_allowed
    挡着，ACTIVE 的电机从不会收到它。保存独立成事务后这道门丢了，正在持位的关节
    会因为点了一下「保存」被抽掉约一秒的控制环（设备侧 flash 写阻塞驱动器自身
    控制环）。在 SAVE 分支补回同名门，位置在「无设备侧落盘对象就早返回」之后，
    易失槽（保护/方向）仍走零帧早返回、不受影响。
2026-09-20 feat(motor_control): 参数视图补双行 SI、未保存位图与不一致位图
2026-09-20 feat(firmware): 新增 device_param_report 话题（参数核对双行快照）
2026-09-20 feat(param_bridge): system.save 下发保存事务；新增 NO_RECORD(42) 错误码
2026-09-20 fix(control_mailbox): 保存校验只挡空位图，不再按保存码掩码拒易失槽
    脏位图必然含易失槽（归一恒写保护 ⇒ bit4 恒脏），原先按
    MOTOR_PROTOCOL_PARAM_SAVE_SLOTS_MASK 挡位图会让每台电机的首次保存都在
    mailbox 被拒，未保存标记永不清除、system.save 整条失效。哪些槽真有厂家
    保存码是内核策略，不是传输层能判的。
2026-09-20 fix(param_bridge): 保存按拍分批下发，扫完一轮才落 W25
    一次 poll 里对每台脏电机各推一条保存事务会撑爆 16 深的配置 FIFO（消费侧
    每 5ms 边界只抽 4 条），被拒的台设备侧没落盘而 W25 已无条件落盘 ⇒ 下次上电
    判假 MISMATCH。改进度游标按拍推进，全部下发完才 storage_task_request_save()。
    不用脏位当游标：被运动禁写门拒掉的台脏位永不清，会永远不收敛。
2026-09-20 docs: 参数权威方向反转（固件记录为权威）+ 写/保存分离 + 新话题
2026-09-20 docs: task-8 审阅修复（旧容量算术、相对链接、验证措辞与标记位置）
2026-09-21 fix(motor_bridge): device_param_report 力矩列按 A 呈现，与参数面同口径
    rec_torque_limit/dev_torque_limit 原直取 record_si/dev_si 的关节侧 N·m，
    与参数面 m<id>.torque_limit（A）相差一个 Kt×减速比×效率 系数（真机同屏两个
    数）。改为一律经 param_units_nm_to_amp(v.torque_per_amp) 换算：系数缺失时为
    NaN，守住"缺失量一律 NaN"契约。位置/速度列不动。
2026-09-21 docs: 参数权威反转收尾——保存被拒语义、模拟器台架口径、注释与容量纠偏
    I2: param-authority-reversal-design.md §3.2 补「保存被拒」段（运动禁写门拒发
    0x2539 但 W25 仍落整份视图 → 复位后 MISMATCH、需人工重核；脏位不消、内核推
    motor_events 的 CONFIG_RESULT INVALID；恢复=失能后重存）；§3.4 要求页面从事件
    流呈现被拒保存，system.last_error 只承载 40/41/42。§3.2 另补：保存事务各阶段
    非确认，OK 只表示帧已发出、不是耐久性 ack。
    I3: motor-runtime-validation.md 四项新台架项补口径——设备掉电用「重启模拟器」
    模拟，不是复位控制板（模拟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
2026-09-21 docs: 参数权威方向反转交接报告（含验证状态、未验项、台架限制与 P2 待办）
2026-09-21 feat(motor): 200Hz 控制边界 + 50Hz P1 发送门 + 轨迹分段与可靠下发
    固件：
    - motor_rt 控制边界 20ms→5ms/200Hz，P1 CAN 命令独立 20ms/50Hz 门限发送，
    5ms 插值目标由 P1 latest-wins 槽覆盖，避免 4 台轨迹打成 800 帧/s
    - can_tx_scheduler 新增 pump_p0_p2：非 P1 发送拍只泵 P0/P2，
    保证安全帧与管理流量不被 P1 限频连带延迟
    - microros_user.meta 流缓冲改为 RMW_UXRCE_STREAM_HISTORY=16（输入/输出各 8 KB，
    成对配置），修复只设 *_INPUT 静默回退到 4 导致大轨迹收不到/卡死
    - check_microros_config 增加 stream history 校验（判 #else fallback 值）
    - MotorTrajectoryState 语义订正：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
2026-09-21 feat(msgs): 新增参数写/系统命令/系统状态三话题，库槽位扩容并离线刷新
    参数服务器退役的第一步：消息包与库级配置先落地，固件代码零改动，
    单独的 pio run 通过即证明配置变更本身成立。
    消息（micro_ros_agent/src/can_bridge_msgs）：
    - ParamSetTarget/ParamSetArray：下行稀疏写。field 取值 = param_device_slot_t
    （与 DeviceParamEntry 行序、mismatch_mask 位序同一套，读写同序）；
    ⚠️ 与 param_field_t 次序不同且互用不会被拒（field=3 两边都合法）→ 静默写错
    槽位，故在 .msg 定义常量、两处注释写明、台架加专测。
    上界 [<=16] 是内核约束不是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
2026-09-21 refactor(param): 参数服务器退役为话题面，save 完成语义修正
    owner 2026-09-21 决定不再使用 rclc 参数服务器，参数面整体改为话题：
    /micro_ros_do/param_set ParamSetArray 稀疏参数写（整条受理/整条拒绝）
    /micro_ros_do/system_command SystemCommand save/refresh/set_zero/clear_fault
    /micro_ros_up/system_status SystemStatus 错误电平 + 四个完成序号，5 Hz
    param_bridge 1005 → 约 800 行：删掉影子副本、失败回滚、暂存、动态注册与
    堆预算拦截（rclc 不检查分配结果那条路径随参数服务器一起消失），新增两条
    订阅回调、一个发布者与三段式保存状态机。ERR_*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
2026-09-21 refactor(param_store): 删除参数名生成/解析，值域校验转为生产路径
    参数服务器退役后没有任何地方再拼/解参数名，随之删除：
    lib/param_store 的 kFieldNames / param_name_build_motor / param_name_parse /
    param_name_kind_t / PARAM_NAME_MAX_LEN 及头文件对应声明（<stdio.h>/<string.h>
    依赖一并消失）。param_name.c 由"名字模型"缩为"值域校验"。
    保留 param_value_ok / param_position_limits_ok ——它们此前近乎死代码，现在是
    param_bridge 整条预校验的直接依赖（src/param_bridge.cpp 的 validate_param_set），
    host 测试对它们的覆盖第一次真的落在生产路径上。
    param_field_t 的序号*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
2026-09-21 docs: 参数面退役文档同步（话题化、收益口径回调、台架命令）
    rclc 参数服务器退役后，把仍把它当现行的文档改为话题口径；史证性推导保留并
    就地标注为历史名。本轮无代码改动。
    - README：参数面一节整段改写为三条话题（param_set / system_command /
    system_status）、field 设备槽序陷阱、成对限位、写≠保存；订阅/发布数与
    消息数改为实测值（5 订 8 发、13 个顶层消息 + 8 个子消息）
    - AGENTS.md：参数面与内存一节改写；micro-ROS 槽位上限从「meta 5 service」
    泛化为 PUBLISHERS / SUBSCRIPTIONS / SERVICES / STREAM_HISTORY 四项
    - fdcan1-bench-guide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
2026-09-21 refactor: 清掉参数服务器退役后的两处遗留（假注释 + 过时测试名）
    复核"参数面是否删干净"时发现的两条，都不影响行为：
    - src/micro_ros_task.cpp 的任务栈注释仍写着"给参数面腾出空间"并指向
    param_bridge.h 已删除的 MAX_PARAMS 容量注释——两处都失效了。改为陈述
    保留的理由（不占 DTCM），历史动机用括注保留，与 AGENTS.md 同一口径。
    - test/host/test_param_store.cpp 的 test_param_name_validation 名字来自已删的
    参数名模型，函数体其实只覆盖 param_value_ok / param_position_limits_ok，
    改名为 test_param_value_validation。
    验证：host CTest 19/19 通过；pi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
2026-09-21 refactor: src/ 纯逻辑模块入库 lib，并整批精简 src/include 注释
    两件事，都不改行为。
    **1. 两个纯逻辑模块搬进 lib/（src/ 只留业务代码）**
    session_sync 与 storage_projection 无 Arduino/RTOS 依赖、host 可直编，本就
    不该跟任务层放一起：整体搬进 lib/<库名>/{include,src}/，各补 library.json
    （PlatformIO 靠它认库）。test/host/CMakeLists.txt 的源路径与 include 目录、
    AGENTS.md 文件速查、README 代码组织表、48-motor-scale-design §1.1 同步。
    **syscalls.cpp 是例外，留在 src/，不能入库**：它提供强 `_write` 去覆盖框架
    （Print.cpp.o）的弱定义，而静态库成员只在"解析未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
2026-09-21 docs: 归档三份已完成的实现计划，修全仓库文档断链
    `plans/active/` 按约定只留活规格与开放项，但里面躺着三份**已执行完毕**的实现计划
    （都是"8 个任务"式的过程产物，内容已被代码与设计文档取代）。加归档横幅后移入
    `docs/archive/`：
    - w25-blob-v3-plan（blob v3 已在真机运行，残留项是 TBD-STORAGE-01/02/03）
    - boot-normalize-plan（上电归一与方向参数已实现）
    - param-authority-reversal-plan（含「实现期勘误」一节，保留作追溯）
    四份设计文档（w25-blob-v3-design / boot-normalize-design / param-authority-reversal-design
    / 48-motor-scale-design）留在 active —— 它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
2026-09-21 refactor(param_store): param_name.{h,c} 改名 param_field.{h,c}
    参数服务器退役后文件里只剩两套槽序枚举与值域校验，名字模型（param_name_build_motor /
    param_name_parse）早已删除，"name" 已名不副实。同步改 include guard 与 7 处引用。
    param_field_t / param_device_slot_t 的序号一个未动（W25 blob present 位图与
    device_raw 槽索引契约）。
    host CTest 19/19；pio run 尺寸不变（RAM 304540 B / Flash 213052 B）。
2026-09-21 docs(comments): 修 8 处已在说假话的注释（参数服务器退役残留 + 授权语义 + 力矩系数口径）
    纯注释，零代码改动。全是对照代码/设计文档核实过的假陈述：
    参数服务器退役后的现在时残留（该名字已不存在，保存现在是 SystemCommand
    command=0 走 micro_ros_do/system_command）：
    - control_mailbox.c「system.save 整条失效」→「保存命令整条失效」
    - motor_control_config.c / motor_control_internal.h / motor_protocol_adapter.h
    三处「由 system.save 触发/收尾」→「由 SAVE 命令触发/收尾」
    - param_units.h 开头「参数服务器的对外单位」「参数服务器是上层边界」→ 参数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
2026-09-21 feat(motor_rt): 命令率由控制边界决定，解耦快照上行速率
    控制边界同时决定 CAN 命令速率：轨迹机组由 trajectory_step 逐边界插值下发、
    快照机组由新增 hold_step 逐边界保持重发，两条通道合计每台每边界恰好一帧。
    移除 kP1TransmitPeriodMs（20ms/50Hz 门限）与只为它存在的
    can_tx_scheduler_pump_p0_p2——台架 SLCAN/CANable 的吞吐上限不是总线余量。
    - motor_control_hold_step：快照新鲜（≤30ms）时原样重发已受理目标，跳过
    挂起 P0/整定窗/轨迹所属电机，重发不取消安全帧重试。
    - entry_apply_target 抽出 entry_push_mit，用 supersede_p0 区分新目标与保持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
2026-09-21 feat(motor): 轨迹分段传输 + mailbox 组装；插值恢复非均匀单调三次 Hermite
    MotorTrajectory 增加 segment_index/segment_count，固件在 mailbox 内按序拼接同一
    trajectory_id 的分段（固定 256 点 assembly 缓冲、无动态内存），只有整条收齐且复验
    通过才原子发布；重叠边界的完全重复路点合并、位置/速度/前馈冲突则整组拒收。对外
    发布的轨迹归一为单段，内核只见完整轨迹。分段未收齐时旧轨迹继续运行。
    插值恢复**非均匀单调三次 Hermite**：切矢按相邻路点的实际时间间隔取
    Fritsch–Carlson 加权调和平均并限幅到 3×min(|Δ|)（逐段不超调），局部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
2026-09-21 feat(param): 参数面改三条话题、权威方向反转为固件记录、写与保存分离
    参数服务器整体退役：下行改为 micro_ros_do/param_set（ParamSetArray，稀疏、整条受理
    或整条拒绝、field 用**设备槽序**）+ micro_ros_do/system_command（SAVE / REFRESH /
    SET_ZERO / CLEAR_FAULT），上行 micro_ros_up/system_status。rclc 参数服务器与
    ros2 param 不再参与运行时；参数不再占常驻堆。
    权威方向反转（owner 裁定）：**固件记录为权威、驱动板向记录对齐**（取代此前的反向
    口径）。DEV_INIT 增第五态 NO_RECORD——本机无该台记录不再落进放行的 NA，判未初始化、
    拒使能、last_err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
2026-09-21 feat(protocol): 0x080 SYNC 全总线统一 CANFD 加速（经典帧 → FD+BRS）
    `cerb_encode_discovery_sync` 是固件**唯一**出经典帧的地方（SDO/MIT 早已 FD+BRS），
    改为 is_fd/is_brs = true。动因是可观测性：经典帧不经过数据相位（BRS 之前全是仲裁
    位率），所以**数据段位率配错时唯独 SYNC 还能通**，把「总线已通」这个假阳性喂给观察者。
    实测复现该盲区：把模拟器的数据段设成不匹配的 Y2，FD+BRS 的 SYNC 立刻收不到——
    rx_frame_count=0、零电机、模拟器自己打出「3s 未收到 SYNC」告警；改动前同样的总线
    故障只会显示「收到首个 SYNC，链路已通」。零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
2026-09-21 feat(ros,web): topic_bridge 与 web_host 随参数面/轨迹面同步；BVH 轨迹 JSON 移入包内
    - motor_hardware_interface：topic_bridge / firmware_topic_bridge 跟进新的参数三话题
    与轨迹分段，测试同步。
    - web_host：参数页迁移到四条话题（写 ≠ 保存、未保存标黄、逐项不一致明细），示教页按
    固件 256 路点容量把整条轨迹拆成同一 trajectory_id 的有序分段，launch/package 精简。
    - 4bvh_*.json 从仓库根移入 ros2_ws/src/web_host/（随 web_host 包分发，不再是根目录
    游离数据）。
2026-09-21 fix(tools): 模拟器串口服务解耦 + 单实例锁 + by-id 设备解析；新增轨迹播放器与台架启动脚本
    三个真实缺陷，都是台架长时间「总线全死」的元凶：
    1. **串口读与 ROS/Gazebo 共用一个循环**：主机负载一上来（Gazebo + 测试脚本），循环
    周期涨到 0.1–0.6s，CANable 的 USB 缓冲被写满 → 它写阻塞、控制器出错、**停发 ACK**
    → 固件侧表现成 TEC=128 / LEC=ACK error / TXBRP=0xff / rx_frame_count=0，看着像
    「总线死」或「固件挂」。改为**独立读线程** `_reader_loop`（独占 fd 读），主循环只
    消费队列；另加每圈**排空**与桥的 spin/publish 限速 100H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
2026-09-21 fix(model): 关节力矩上限 10 → 45 N·m，与真机 R58 的 MIT 力矩范围对齐
    URDF 四关节原为 <limit effort="10.0">，而 MIT 律 tau = kp*err 在 kp=30、误差 1.57 rad
    时需要 ~47 N·m，被模型钳到 10 → 肩/肘关节顶不住自身重力，停在机械下限（实测 m2 停在
    −1.5705 ≈ −π/2，把模拟器的 --tau-limit 抬到 80 也无效，说明约束在 URDF 这一侧）。
    45 N·m 取自本仓库 README 记载的真机 CERB R58 MIT 力矩范围（±45 N·m），即把仿真关节的
    力矩能力对齐真机口径；这是仿真被控对象的既有参数过小，不是放松安全约束——固件侧的
    型号峰值钳制与软限位仍然生效。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
2026-09-21 docs: 同步 AGENTS/README/ADR/决策日志与验证计划
    - AGENTS.md 新增「台架：模拟器与全链路」一节：单实例锁与读线程的必要性、主机侧调度
    延迟会表现成总线故障（含 CANable 对主机卡顿极敏感、cangaroo 是最快反证的排查经验）、
    按 by-id 解析设备、effort 模式的力矩天花板、轨迹容量与 traj_play.py、轨迹播完不释放
    归属；台架启动统一走 tools/bench_up.sh。
    - README 补 0x080 SYNC 的帧格式说明与真机核对项。
    - 决策日志新增 SYNC 统一 CANFD 加速一行；同步 ADR-0007、各 active 计划与 handoff 报告；
    新增 docs/architecture/module-boundaries.md。
2026-09-21 test(protocol): 发现帧断言改为 FD+BRS
    随 0x080 SYNC 统一 CANFD 加速，test_cerb_encode_discovery_sync 从「零长度、经典帧」
    改为断言 is_fd && is_brs（本用例是固件侧唯一断言 SYNC 帧格式的地方）。host CTest 19/19。
2026-09-21 revert(model): 撤回关节力矩上限 10 → 45 N·m（诊断有误）
    上一提交 7f6bca0 把 URDF 的 effort 从 10 抬到 45，理由是「MIT 律 kp=30、误差
    1.57 rad 需要 ~47 N·m，被模型钳到 10 才顶不住重力」。**这个理由经不起计算。**
    用 URDF 自身的质量与几何对势能做数值求导（PE(q) 对关节角中心差分，网格
    ±π/2、±π/4、0），四关节的**最大静态重力力矩**是：
    joint_link1 1.87 N·m
    joint_link2 0.27 N·m
    joint_link3 0.27 N·m
    joint_link4 0.00 N·m
    活动连杆合计约 0.73 kg（Joint_link1/2/3/4 = 0.076/0.368/0.132/0.156 kg），
    原本的 10 N·m 上限比所需大 5–37 倍。**力矩上限从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
2026-09-21 feat(tools): 轨迹播放器加逐台 target_source 诊断与交棒阶跃统计
    - 对齐阶段逐台打印 target_source 与反馈年龄，并对两类「ROS 侧无报错但电机不动」
    的情形显式告警：反馈已过期（state_age_ms > 200）与 target_source=0（该台没过
    entry_may_move 的门）。台架上排「某台不跟」时这是第一判据——快照仍被受理、
    snapshot_accepted 照涨，从 ROS 侧完全看不出是哪台被门住了。
    - 结果段加「最大单采样位移 / 中位」比：窗口交棒是本方案唯一可能产生位置台阶的
    地方，比值 >20× 即提示交棒时刻没压准。
    - --lead-ms 默认从 60 改 0：固件受理新轨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
2026-09-21 docs(agents): 台架节纠正「力矩上限是瓶颈」的错误结论，补 position 模式不可用与 target_source 判据
    上一轮写进 AGENTS.md 的「effort 模式的力矩天花板」是错的，随 revert 400df13 一并纠正：
    - **力矩上限不是瓶颈**：URDF 自身质量/几何对势能数值求导得四关节最大静态重力力矩
    1.87 / 0.27 / 0.27 / 0.00 N·m（活动连杆合计约 0.73 kg），原 10 N·m 比所需大 5–37 倍。
    把 kp*err 当"所需力矩"是拿控制增益当物理负载。
    - **「某台不跟」的第一判据是 motion_states.target_source**：0=NONE 表示该台没过
    entry_may_move 的门（policy_enable / motion_authorized / dev_par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
2026-09-23 refactor(firmware): 重构 TX 路由、SAVE 事务与配置契约并统一格式
    - 新增 lib/motor_tx_router：P0/P1/P2 有界出队、物理帧预算、P0 重试与 HAL submit seam；
    motor_rt_task 只调用路由器一次/总线，HAL 提交仍由本任务独占
    - motor_protocol 增加 adapter 注册表与 P1 聚合接缝：CERB 同总线最多 6 轴合帧 0x210（FD+BRS 64B），
    VAXOR 与不兼容/单帧原样通过；路由器不解释厂家 CAN-ID
    - 新增 lib/save_transaction：SAVE 两阶段纯 C 状态机，param_bridge 只提供端口回调，
    W25 仍归 storage_task、save_seq 仍归 ROS 桥
    - 新增 include/motor_config_contract.hpp 与 host 契约测试，穷举锁住 mai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
2026-09-23 feat(web_host): 仿真启动器与 bus_index 贯通
    - web_host 新增仿真面板与 /api/simulation/* 接口，可从页面按模型/传输/
    控制端启动与停止 robot_arm_gazebo/simulation.launch.py，并管理进程与日志
    - robot_arm_gazebo 新增 simulation.launch.py 组合入口、simulation_topology.yaml、
    canfd xacro 与 simulation_gate/agent_after_sim_ready 辅助节点
    - fdcan_motor_sim 支持 CAN-FD SocketCAN 传输、--ready-file 与通用 CanMotorSim
    - can_bridge_msgs 的 MotorStatusTarget 追加 bus_index，消息面版本升至 3，
    状态/拓扑/运动三分职责相应更新，页面显示实际发现总线
    - hardware.launch.py 支持 controller_manager_name 与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
2026-10-08 docs: 同步仿真入口、SDO 读取与三段式构建区域说明
    - CLAUDE.md/README/CONTEXT 等根文档统一表述为三个独立构建区域，补齐
    simulation.launch.py 端到端入口、vcan 权限与 web_host 章节
    - 固件参数面文档改述 device_param_report 为按需发布（REPORT/CONFIG_RESULT/
    DEV_INIT），并说明 COMMAND_REPORT 与未发现电机的板内记录补行
    - web_host 说明参数表整宽、使能与增益移入抽屉，读取改为 system_command(REPORT)，
    长示教恢复为多条独立轨迹串行下发
    - micro_ros_agent/README 修正 can_bridge_msgs 消息计数，robot_dynamics 改用 rosdep
2026-10-08 docs: 新增固件开发路线图并补 0009 仿真重力前馈 ADR 与设计/计划
2026-10-09 docs: 新增 web_host 前端重构 ADR 与设计
    单页 + 8 抽屉的描述与使用者确认的四个日常场景（台架调试、示教回放、
    仿真验证、参数整定）不匹配：常用操作埋在抽屉里、没有导航、信息密度
    均匀、窄屏只能顺序堆叠。本轮换骨架解决，纯搬迁不新增功能。
    ADR 0010 记录被否掉的四条路（只整理单页 / vendor 轻量框架 / Vite +
    React / 面板工作台）与两条硬约束：保持无构建链、可测性走 Python 侧静态
    契约而不引 Node。
    设计确定外壳/屏/面板三层、五屏与 14 个面板的分发、可折叠状态翼、色板
    不变的度量调整、hash 路由与多窗口、断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
2026-10-09 feat(web_host): 前端外壳、hash 路由与共享状态
    单页 app.js 拆为外壳/屏/面板三层的第一步：index.html 成为 DOM 单一来源，
    router 持有屏 id 的权威集合，store 收拢跨屏状态并加脏标记 rAF 循环。
    契约测试同时就位，把「改名漏改」与「新增文件忘重跑 colcon」两类静默失效
    变成测试失败。面板为空，旧 app.js 尚未接入，页面此时只有骨架。
2026-10-09 feat: add zhoubuguanjie ROBOT-0 Gazebo model assets
    - Add zhoubuguanjie ROBOT-0 package with URDF, launch files, config, and metadata
    - Include robot link and base STL meshes
    - Add missing STL meshes for zhoubuguanjie_youbi_001
2026-10-09 feat: 新增腕部连杆闭环分析脚本资产
    加入 2026-10-09 腕部连杆闭环报告的分析工具集：
    - migrate_model.py：SolidWorks 导出件迁移为模型库格式
    - regen_derived.py：从渲染 xacro 重生成 standalone 与 dist 派生件
    - urdf_geometry_probe.py / urdf_contact_graph.py：装配位形几何与接触图探针
    - closure_proto.py / axis_center_scan2.py：闭环求解原型与轴心扫描
    - wrist_detail.py：腕部电机-轴承-杆局部特写渲染
2026-10-09 docs: 新增右臂模型更新与腕部连杆闭环 handoff 报告
2026-10-09 docs: 在跨工程报告索引中新增腕部连杆闭环交接条目
2026-10-09 feat(robot_arm_gazebo): 实施腕部连杆闭环（球铰 + 闭式求解器 + RViz 链路）
    方案 α：把 SW2URDF 切开的腕部并联连杆闭环在 RViz 里补回去。
    - 模型：两分支各插一个零质量虚拟连杆（wrist_ball_a/_b）与正交 revolute
    （joint_wrist_ball_a/_b，轴 (0,1,0)）构成二自由度球铰，原 joint_link7/_0
    成为球铰第二轴、origin 归零；补完后零位 P7/P9 与改写前逐位相同。
    revolute 关节数 10 → 12，standalone/dist 同步重生成。
    - 求解器：新增 scripts/wrist_closure_solver.py，全闭式无迭代；订阅
    /joint_states_raw，按「杆长球面 ∩ 曲柄圆」解出摇臂角与球铰两轴后发
    /jo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
2026-10-10 feat(models): add zhoubuguanjie_youbi_002 right-arm model and robot assets
    - Add zhoubuguanjie_youbi_002 right-arm model: 6 revolute serial joints, no wrist remote linkage, meshes, standalone/URDF/xacro files, controllers.yaml and README.
    - Document spawn_z:=0.0027 requirement for the new base and placeholder joint limits / actuator parameters.
    - Import zhoubuguanjie ROBOT- reference package with config, launch files, meshes and URDF.
    - Add pro_urdf_publish humanoid meshes and humanoid.urdf, including pelvis, shoulder, arm and link assets.
2026-10-10 Add collision meshes and CAN FD hardware xacro for zhoubuguanjie_youbi_002
    Add STL collision geometry for base_link and Joint_link3 through Joint_link6
    so Gazebo uses accurate per-link collision models for the 002 arm, and add
    zhoubuguanjie_youbi_002.canfd.xacro to drive the arm through the CAN FD
    motor_hardware_interface. The xacro reuses the shared URDF and takes the
    motor config, bus overrides, and controlled joint list from launch arguments,
    since 002 has all six joints direct-driven.
2026-10-10 fix(robot_arm_gazebo): 补 agent_after_sim_ready.py 可执行位并让守卫查 X_OK
    `--symlink-install` 下 install(PROGRAMS) 装的是指向源文件的符号链接，源文件权限位
    是 100644 ⇒ 安装件没有可执行位。simulation.launch.py 用 ExecuteProcess 直接执行它，
    而守卫只查 is_file()，于是校验通过、执行时才炸 —— 属于「文件在、但起不来」的假通过。
    - scripts/agent_after_sim_ready.py: 100644 → 100755
    - launch/simulation.launch.py: 守卫补 os.access(..., os.X_OK)
    验证：colcon build --symlink-install 后该路径 X_OK=True；simulation.launch.py 仍能
    加载（17 个 action）；agent_after_sim_ready.py 仅在 controller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
2026-10-10 chore(robot_arm_gazebo): 添加 log 目录 COLCON_IGNORE 并忽略 colcon 日志
2026-10-11 feat(web_host): rosbridge 订阅与 Agent 管理搬入 core 模块
    订阅层不再认识面板：写入 store 后只 markDirty，渲染交给 rAF 循环。重连退避、
    掉线清场、发布端预热三条行为与注释原样保留。
    适配说明：Agent 启停的「正在启动/断开」瞬时态改写 store（订阅层不碰 DOM，顶栏由
    main.js 的 renderShell 画）；sendParamSet/sendSystemCommand/sendTrajectory 等写侧
    助手随各自面板任务（Task 6/8/9）落位，本批只搬 pub/ensurePublisher 与两个等待工具。
2026-10-11 feat(web_host): 常驻状态翼与告警清单
    任何屏都能一眼看到在线/运行/冲突/故障与告警明细，点告警跳对应屏并选中该台。
    计数口径与顶栏 chips 共用 core/store.js 的 countMotors()，避免两处各算一遍。
    收起态补上点竖条展开（复用 #wingToggle 的翻转与记忆）。
2026-10-11 feat(web_host): 运行屏的关节索引、读数与使能增益
    拆开 renderMotors：它原先一次干五件事（渲染行、顶栏 chips、读数、臂着色、参数总览），
    现在各自有归属，chips 计数收进 store.countMotors() 由顶栏与状态翼共用。
    使能表的「显示全部」改用新 id chkAllPolicy：设备参数表与使能表分处两屏，不再共用一个
    复选框（spec 功能对等清单第 7 项）。
    配套基础设施：mountPanel 在挂载前把 <template data-panel-template> 克隆进屏模板的
    [data-panel] 占位（DOM 单一来源仍在 index.html）；断连禁写只对行内的策略按钮与
    启用/kp/kd 输入，「显示全部」只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
2026-10-11 feat(web_host): 臂视图改为可挂载面板
    arm3d.js 的 three.js 代码逐字搬入 panels/arm.js，去掉 window.Arm3D 全局桥
    （改由 mount 直接调用，不再赌模块与脚本的顺序）。unmount 显式释放 geometry 与
    material —— 切屏会反复挂载，不释放会一路涨显存。
    走在界面上的两条限制照旧保留：幽灵是页面自己发出去的目标、轨迹在播时不画幽灵。
    顺带修正一个改名遗留：默认模型 _001 已随 c549d29 删除（现行默认为 _002），
    旧默认值会让臂视图默认 404。canvas 与 hud 由 JS 建（旧 id arm3d/armHud 退役），
    舞台与图例在面板模板里；加载失败时 hud 显示错误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
2026-10-11 feat(web_host): 下发面板与 100Hz 连发
    新增行为：unmount 时停连发。旧代码里连发只有手动取消一条路，切屏后定时器仍在跑，
    而按钮已不在 DOM 上 —— 用户没法停。断线（DIRTY.CONN）同样停连发（旧 closeSocket
    行为）；seq/streamTimer 收进本模块，不再跨面板共享。
2026-10-11 fix(web_host): 窄屏保留左导航文字、状态翼不再按断点自动收起
    用户反馈：窄宽度下左导航只剩数字（1-5）、右侧状态翼自动收缩成 34px 竖条太丑。
    - 去掉 ≤1080 的图标导轨规则：各宽度都显示 运行/示教/设备/仿真/诊断 文字
    - 去掉 ≤1360 的默认收起：状态翼一律显示完整内容（仍可手动 ◂ 收起并记忆；
    <820 空间不足时仍强制竖条）
2026-10-11 fix(web_host): 状态翼的收起/展开翻转改按实际类判断
    断点不再默认收起后，翻转逻辑里的 matchMedia(≤1360) 判断与实际显示相反：
    默认展开时第一次点 ◂ 不收起。改为只看 body 上有没有 wing-collapsed 类。
2026-10-11 fix(web_host): 滚动条改深色细条并启用 color-scheme: dark
    用户截图反馈：右侧的浅色、带上下箭头的老式滚动条太丑。
    - scrollbar-width: thin + scrollbar-color（Chromium 121+/Firefox 原生生效）
    - ::-webkit-scrollbar 兜底：8px 宽、透明轨道、深色滑块、去掉箭头块
    - color-scheme: dark：系统原生控件（含 select 弹层）按深色渲染
2026-10-11 feat(web_host): 曲线、事件日志、命令历史与屏内抽屉
    曲线缓冲搬进 store 并在写入侧封顶 1500 样本/通道（30 s × 50 Hz）：没有曲线面板时
    缓冲也必须收敛，否则切屏一整天后内存只涨不落。抽屉开合与当前 tab 按屏记忆；
    面板在抽屉未展开时也挂载（隐藏容器里照常累积事件）。device/diag 屏模板就位。
2026-10-11 feat(web_host): 设备屏与参数写事务
    参数读写事务单独成 core/device.js：既被设备屏按钮调用，也被连接建立后的自动读取调用 ——
    使能面板的电机列表来自 paramCache，设备屏不挂载时也要有。
    防抹除保护从订阅处理器挪进面板 render：订阅层已不认识面板，正在编辑的输入框仍不能被
    device_param_report 的下一帧重建抹掉。结果文本进 store.results（同一事务的按钮分布在两屏）。
    「当前位置」列走局部文本刷新（render 200ms 节流），不随 motion 重建整表。
    真机项（保存 W25/设零/方向/CONFIG_RESULT 结论）留待台架验证——本批已验证读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
2026-10-11 fix(motor_sim): 单帧冲突不再判双控制器，连续冲突才锁存
    驱动器激活时先以 2ms 节拍发零增益轮询帧，收齐反馈后 0.1ms 内紧接着发
    使能帧（canfd_system.cpp on_activate），同一 CAN ID 的 payload 在
    duplicate_window 内变化——那是同一个控制器的合法状态切换，不是双控制器
    冲突。实测该误报会在激活瞬间锁存 DuplicateController，此后仿真拒绝回复
    任何命令，驱动侧表现为「反馈超时：joint_link1」而无法激活。
    改为窗口内连续 payload 冲突达到 2 次才锁存：真双控制器会持续交替写同一
    电机，仍然会被捕获；单次合法切换不再误报。补单冲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
2026-10-11 fix(motor_sim): 声明 effort/joint_states/diagnostics 话题参数
    节点此前只读取 drive_state/control_gate/reset_fault 三个话题参数，
    NodeDefaults 里的 effort_topic/joint_states_topic/diagnostics_topic 从未
    被 declare_parameter 读取：launch 传入的 effort_topic 被静默忽略，默认
    相对名解析成 /effort_controller/commands。端到端仿真（host + vcan）里
    Gazebo 的 arm_effort_controller 订阅 /arm_effort_controller/commands，
    仿真力矩因此从未进入 Gazebo（实测话题列表确认）。
    两个参数读取入口都补齐三个 declare_parameter；独立 launch 的默认值与节点
    默认一致，行为不变。
2026-10-11 feat(robot_arm_gazebo): 模型拓扑可覆盖仿真驱动时序
    simulation.launch.py 生成的驱动配置此前无条件继承权威 motor_driver.yaml
    的 timing。仿真侧 CERB 只在收到命令帧后回帧（无周期上报），而驱动器激活
    路径自带 100ms 上伺服等待加控制器首拍延迟，实测约 215ms 命令空窗，0.1s
    的 feedback_timeout_s 会把这段静默误判成反馈超时，链路无法激活。
    现在 simulation_topology.yaml 可用 driver_timing 覆盖已知键（拼错报错），
    _002 模型设 feedback_timeout_s: 0.5（仅作用于仿真生成的驱动配置，不影响
    真机）。权威命令 ros2 launch robot_arm_gazebo simulation.launch.py 实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
2026-10-11 feat(web_host): 仿真启动器改为可挂载面板
    web/simulation.js 的 ui 映射与全部逻辑移入 mount 作用域，1.8s 状态轮询由 mount
    持有句柄并在 unmount 清理——旧代码是页面级 IIFE 单例，切屏会重复注册轮询。
    index.html 补 sim 屏与 sim 面板模板（旧 id 全部保留），css/panels.css 补 sim 屏
    栅格与启动器样式；纯搬迁，行为与旧单例一致（默认值、字段显隐、物理总线隔离
    确认、切屏后由后端 status 恢复状态与日志）。
2026-10-11 feat(web_host): 新旧两版界面并存，新增 robot-001 与 -00 模型
    - legacy.html 保留重构前单页界面，走同一静态服务与 /api，入口 /legacy.html
    - test_web_assets.py 增 test_legacy_assets_exist 兜住旧版资源不被误删
    - app.js/arm3d.js 臂视图几何改走 /robot_arm_gazebo 挂载，默认模型改 _002
    - 新增 robot-001 与 胸部整体结构装配体-上身部分00 两套模型（URDF/meshes/launch）
2026-10-11 feat(micro_ros_firmware)!: 取消设备参数核对运动门禁（owner 决定）
    dev_init 结论（MISMATCH / UNVERIFIED / NO_RECORD）不再冻结 lifecycle、不置 DEV_PARAM 故障、不拒使能、不拦运动帧，只如实上报 dev_init / DEV_INIT 事件 / device_param_report。代价：未核对的台其限位/速度/力矩可能不是核对过的值，兜底只剩硬件急停与机械限位。
    - motor_control_dev_params_allow_motion 除 NULL 表项外恒放行
    - apply_dev_init_result 不再调用 freeze_entry_as_conflict（该助手现为死代码，恢复时放开注释即可）
    - host 测试与 README/AGENTS 同步为「只报不拦」，恢复门禁的两处位置写进文档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
2026-10-11 fix(micro_ros_agent): SLCAN 数据位率索引按 V 探测，修正 Y7→Y5 误配
    现场 CANable（USB b158aa7 / V=16e7497-dirty）的 5 Mbps 索引实测是 Y5，bench_up.sh 却写死 --data-bitrate-index 7。Y7 下带载荷的 FD 帧数据相位 ACK error，固件 TX FIFO 被重传占满、停发 SYNC，两侧静默 → 九台全部 OFFLINE / fault=5。
    判据：0x080 SYNC 是 DLC=0、不切数据相位，故「收得到 SYNC」不能证明位率正确，必须看 DLC 8/12/20 的帧。索引扫描：Y2/3/4 收不到 SYNC，其余索引能收 SYNC 但一开反馈即崩。
    改动：
    - fdcan_motor_sim.py：SLCAN_VERSION_DATA_BITRATE[\"16e7497\"] 7→5，示例与文档同步
    - bench_up.sh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
2026-10-11 feat(robot_arm_gazebo): 新增 chest_upper_00 模型并设为默认模型
    SolidWorks 导出的上身结构装配体（纯串联 9 轴，link 大写 Joint_link1..9 / joint 小写 joint_link1..9），替代退役的旧命名模型目录。
    - 三处 launch（gazebo/display/simulation）默认 model 统一为 chest_upper_00
    - simulation.launch.py 的 motor_config_file 留空时优先取模型目录自带的 config/motor_driver.yaml（权威整机配置不含 chest_joint*，因为 joint_link1..9 尚未并入 upper_body.urdf.xacro）
    - 模型自带仿真拓扑与仿真专用电机配置 + dist/ 对外发布件
    - gazebo spawn_z 默认 0.0（该模型零位下最低点恰为 0），测试契约同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
2026-10-11 fix(motor_hardware_interface): 同一总线电机 id 去重（腕部 1/2/3 → 7/8/9）
    固件注册表以 motor_id（= 厂家 node 号）为键，同一总线重号即进 CONFIG_CONFLICT；台架 HIL 模拟器的 --joint-map 同样以裸 ID 为键，重号会让 dict() 静默塌缩。纯主机路径靠 MotorDriver 按 (bus, type) 分组掩盖了重号，接固件即暴露。取值对齐台架九节点方案。
2026-10-11 fix(web_host): 默认模型改为最新的 chest_upper_00
    两版界面的 MODEL 默认值都跟随 gazebo.launch.py 的默认模型；?joints= 默认映射由 4 台扩到 9 台（id N ↔ joint_linkN）。文档同步。
2026-10-12 feat(robot_arm_gazebo): 新增 robot_all 双臂上身模型
    SolidWorks 导出的「胸部整体结构装配体-上身部分」：躯干 base_link 上挂两条互不相连的
    9 轴链（Joint_link1..9 / Joint_link1.1..9.9），18 revolute + 0 fixed，两条链都是纯树、
    没有闭环，不需要补环节点。原始导出件直接放进 models/ 加载不起来，本次按
    models/<模型名>/ 自包含契约补齐，并做三处适配（详见模型 README）：
    - 网格路径 package://胸部整体结构装配体-上身部分/... 改为 package://robot_arm_gazebo/
    models/robot_all/...（38 处）：导出器假设的包名不是已安装的 ROS 包，ROS/Gazebo 都解析
    不到，模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
2026-10-12 refactor(robot_arm_gazebo): 删除退役模型，默认模型改为 robot_all
    删除 chest_upper_00 / chest_dual_00 / robot-001 / zhoubuguanjie_youbi_002 四个模型目录
    （539 个文件）与 dist/ 下对应的三个发布件，robot_all 成为唯一可加载模型，因此
    display.launch.py / gazebo.launch.py / simulation.launch.py 的 model 默认值、
    test_launch_models.py 的 MODEL、包 README 与 CLAUDE.md 里的默认模型一并改为 robot_all。
    顺带补齐两处因删除而暴露的问题：
    - simulation.launch.py 在 controller_mode:=host（默认值）下要求模型自带
    urdf/<名>.canfd.xacro。chest_upper_00 没有这个文件，所以它此前根本跑不起默认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
2026-10-12 refactor(web_host): 删除旧版单页界面，默认模型改为 robot_all
    删除重构过渡期保留的旧版单页界面：web/legacy.html、app.js、style.css、simulation.js、
    arm3d.js（入口 /legacy.html）。它的逻辑早已逐块改写进 web/js/（arm3d.js → js/panels/arm.js、
    simulation.js → js/panels/sim.js），共存只是回退手段；旧文件仍在 git 历史里
    （git show 3d843d1:ros2_ws/src/web_host/web/）。同步移除 test_web_assets.py 的
    test_legacy_assets_exist 与 README 的「两版界面并存」一节，README 改为按新版结构
    （外壳 / 屏 / 面板，5 个屏）描述，页面各区域的归属也重锚到对应屏。
    默认模型 chest_upp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
2026-10-12 feat(robot_arm_gazebo): add full_body dual-arm model, MuJoCo support, and motion trajectories
    * Add `models/full_body`: 18-DOF dual-arm model derived from the SolidWorks
    export, including URDF/xacro with real joint limits and damping, simplified
    collision geometries, Gazebo self-collision setup, and standalone URDF.
    * Import `models/胸部整体结构装配体-上身部分`: original SolidWorks exported
    URDF/CSV/meshes used as the upstream source model.
    * Add collision simplification and validation tooling: convex-hull mesh
    generation, interpenetration checker, and generated `meshes/collision/*`
    (14 convex links plus box primitives for base_link and wrist links).
    * Add MuJoCo workf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
2026-10-12 fix(robot_arm_gazebo): 修复 MuJoCo viewer 在 Wayland 下卡死并支持关窗后无头继 续
2026-10-13 feat(robot_sim): 新增 half_body_robot 半身双臂模型与双后端仿真支持
    - 导入 SolidWorks 导出的 half_body_robot 模型：双臂 18 轴 URDF/xacro、
    standalone/canfd 派生文件、CAD 资产与完整网格。
    - 添加 Gazebo 侧配置：简化碰撞网格与 box、自碰撞/摩擦参数、effort-only
    ros2_control 接口，以及 controllers、motor_driver、simulation_topology。
    - 添加 MuJoCo MJCF、生成/校验脚本与力矩直通桥；命令可按关节名映射，避免
    依赖 MJCF 与拓扑顺序一致的巧合。
    - 添加模型一致性、launch、MuJoCo 命令映射和 web_host 仿真管理单测。
2026-10-13 feat(web_host): 关节映射改为后端按模型配置提供，前端新增覆盖测试
    新增 /api/model-joints 接口，从模型自身的 config/motor_driver.yaml 读取
    motor_id → 关节名 映射，取代前端硬编码的 half_body_robot 18 台静态表。
    store.js 启动时经 loadModelJoints() 装入映射，失败不再静默：退回内置兜底
    表并在控制台留痕，同时暴露 jointMapSource 供界面区分来源。新增契约测试
    test_default_joint_map_covers_default_model，确保默认映射覆盖默认模型的
    全部电机。
2026-10-13 fix(firmware): 台架数据段降到 2 Mbps，根治 FD 数据相位导致的整链静默
    台架长期"间歇静默、18 台 OFFLINE、重刷固件无效"的根因是 CAN FD 数据相位时序，
    不是适配器损坏、不是模拟器、也不是带宽：5 Mbps 下 1 bit 只有 200 ns，与本台架
    收发器环路延迟同量级；两侧采样点本来就不同（板子 16 tq → 81.25%，CANable2 上游
    固件 17 tq → 88.24%），余量被吃光。判定要点：空闲时只发 0x080（DLC=0、没有数据
    相位）所以 tx_frame_count 稳定 50/s；一旦板子发带数据相位的 FD 帧（运动命令），
    tx_frame_count 掉到 0、rx_frame_count=0、18 台 OFFLINE↔ACTIVE 抖动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
2026-10-13 feat(micro_ros_agent): 台架加逐台力矩上限、发力矩频率与高频命令源工具
    HIL 台架上假电机同时充当被控对象的力矩源，两处需要按真机语义对齐：
    - --tau-limits 逐台饱和力矩（型号库 peak_torque_nm：r58=45 / r48=11 Nm），
    取代照抄 URDF effort 限幅的全局 10 Nm。用全局小值时大关节一旦被推歪，PD
    一路饱和、机构再也收不回来，表现为"乱动且停不下来"。
    - --effort-rate-hz（默认 200）把发力矩与 CAN 主循环解耦。它是本回路的死区：
    跟随主循环（50 Hz）再叠加被控对象 100 Hz 的 /joint_states ≈ 30 ms 死区，配置
    里的 (kp=30, kd=1) 恰好越过稳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
2026-10-13 fix(robot_sim): HIL 被控对象补折算惯量与逐台力矩上限，并修正 README 的根因
    HIL 下被控对象由 fdcan_motor_sim 的假电机驱动，而它的 MIT 律是当外力注入的
    （mujoco_effort_bridge 直接写 data.ctrl），因此被控对象侧有两处必须补齐：
    - 关节要有减速器折算惯量：URDF 只有纯连杆惯量（1e-5~1e-7 kg·m²），显式积分条件
    dt < 2J/kd 会要求 dt < 0.4 µs，而 MuJoCo 是 ms 级 ⇒ 数值发散（实测 joint_link1
    v=+9595 rad/s、位置冲到 33 rad）。build_mujoco_model.py 现按 armature = kp/ω²
    （ω=5 Hz、kp 取模型 config 的 command.kp）写每个 <joint armature>，并设
    timestep=1ms + inte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
2026-10-13 feat(web_host): 新增 IMU 面板、单/一键下发策略与三栏底部齐平布局
    - 诊断屏新增 IMU 面板（js/panels/imu.js）：3D 姿态（四元数 → 立方体 + 三轴投影）
    与人工地平仪（按 roll 旋转、pitch 平移地平线），配 Roll/Pitch/Yaw、温度、更新
    年龄与频率。数据源是 micro_ros_up/imu/data 与 imu/temp，面板只渲染不订阅；首帧
    前显示占位，render 只由脏帧驱动，频率与年龄另用 1 s 定时器刷新（数据停发后年龄
    会走成"超时"）。
    - 使能与增益面板：逐台按钮由"策略"改称"下发"；新增"全选使能"复选框（只改勾选
    状态，不下发）与"一键下发"，后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
2026-10-14 fix(firmware): 撤掉台架 2 Mbps 变体，FDCAN 位时序冻结为标定 1M/5M
    890353b 为绕开台架上的 CAN FD 数据相位间歇静默，加了 -DFDCAN_DATA_2M_BENCH 把数据段
    降到 2 Mbps 并在 platformio.ini 里默认启用。这与真机标定（仲裁 1 Mbps / 数据 5 Mbps）
    不一致，而且必须靠人记着"接真实电机前关掉"，漏关就把真机链路做坏——板子 16 tq/81.25%
    的采样点与真机电机的 80% 本来就是匹配的，余量问题只能从适配器侧修。
    固件侧改动面撤到零：platformio.ini 回到本次拉取前（98f4688）的状态，fdcan.c 的数据段
    常量恢复单份、去掉 #ifdef；只保留一行 #pragma message（"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
2026-10-14 docs: 对外开源前收敛文档——每区域一份权威文档，删过程性产物并脱敏
    仓库约 24000 行第一方 Markdown 里，同一事实常被写在 2–5 处，且混入 AI 协作过程产物、
    历史过程文档与个人路径。本次按「每份事实只有一个宿主」重整，净减约 23700 行。
    删除（先把仍有效的结论落进权威文档，再删源文件）：
    - docs/reports/（16 份报告 + 7 个脚本）、docs/superpowers/（6 计划 + 6 设计稿）
    - micro_ros_firmware/docs/ 下的 archive/（5 份，含冻结的 ARD-0007 全文）、plans/active/
    （8 份）、superpowers/（1 份）、architecture/lib-library-audit.md
    - micro_ros_firmware/doc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
2026-10-14 refactor(firmware): 注释按「只写意图」重写，压掉长篇大论与死引用
    源码注释里最长的一批块（15–23 行）写的是设计论证、变更沿革、实测排查过程与厂家手册
    转抄——这些本该归 ADR 与 decision-log，源码只该留意图。本次：
    - 22 处 ≥10 行的注释块重写为 ≤6 行的契约式说明（文件头、枚举、事务规则、并发契约）
    - 清掉 141 处 `ARD-0007 §NN` 死引用：现行 ADR 用 §1–6 编号，源码引的 55 章编号随归档
    规范删除后已无处可查
    - 跨文件重复的事实（0x2541 语义 5 处、写≠保存 4 处、SYNC FD+BRS 5 处等）各留一处权威
    - 保留：单位与换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
2026-10-14 docs: 注释规范改为可执行的表述（叙述块 ≤5 行；契约清单可略长但不写散文）
2026-10-14 feat(web_host): 电机后端独立进程化——动作库播放与 FDCAN 模拟器控制台
    把 HIL 的 FDCAN 模拟器从仿真 launch 内嵌改为 web_host 管理的独立进程
    （motor_sim_manager），可单独起停、随仿真联动，并经 Unix socket 控制通道
    做电机增删与断连；新增动作库播放面板（actionLibrary.js + actions.py）与
    /api/actions、/api/motor-sim/* 接口。
    - fdcan_motor_sim.py: 新增 --control-socket（JSON 行协议 status/add/remove/link），
    linked=False 时完全静默（不发反馈/不回 SDO/忽略下行帧），恢复即重新上电
    - simulation.launch.py: 新增 simulator_only / start_fdcan_sim / sim_control_socket
    参数；s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
2026-10-14 fix(motor_sim): 修误报的适配器归因，CERB 力矩量化范围改逐型号
    静默期的 "E=无应答 ⇒ 适配器串口侧已死" 是假证据：E 轮询 2026-10-12 已因副作用
    停用，canable_error 恒为空串，那行日志把一个常量当读数打印。改为取一次 V（开通道
    时的基线作阳性对照），并且**默认关**——诊断不得改变被测对象（台架实测：加上基线
    探针后首次静默由 169 s 提前到 0.6 s）。生成器与日志文案里的过期说明一并更正。
    读线程只处理 \r 之前的行，而 V/E 应答不带终止符（2026-10-12 实测），静默期没有
    帧行来"顶"出终止符 ⇒ 应答永远卡在 rx_buf 里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
2026-10-14 feat(motor_hardware_interface): 型号库补 rated_speed_rad_s（厂商参数页真值）
    被控对象的关节速度上限此前无真值可依：URDF 是 CAD 导出的占位值 1.0，拓扑里的
    mit_velocity_limit_rad_s=30 是协议的**量化范围**而不是物理上限，型号库根本没有该字段。
    厂商参数页给的是输出端转速：CERB 两份都是「输出转速 30 RPM」（谐波速比 101 已在
    输出端）⇒ π rad/s；VAXOR 参数页给电机端「额定 ≤2000 rpm」，除速比 50/30 ⇒ 4.189 /
    6.981 rad/s。上层统一 rad/s，出处写在注释里。
2026-10-14 fix(robot_sim): MuJoCo 被控对象补关节速度上限与逐台力矩上限，消掉饱和极限环
    MJCF 由 URDF 转换而来，丢掉两样 URDF 有、MuJoCo 没有的东西：
    - <limit velocity>：MuJoCo 的 <joint> 没有速度上限属性。缺了它被控对象跑到
    40 rad/s，MIT 律的 kd·vel 项自己就顶进 ±peak 饱和 ⇒ 阻尼退化成 bang-bang、
    整臂陷入饱和极限环。实测峰值速度 43 → 1.4 rad/s、顶峰值路数 10/18 → 0/18。
    Gazebo 侧由 Dart 执行该限幅，所以只有 MuJoCo 这条路发作。
    - 峰值力矩：URDF 的 ±10 是全关节占位值，把 r58 的 45 N·m 削到 10。改为按拓扑的
    mit_torque_limit_nm 逐台写（11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
2026-10-14 feat(web_host): 接管 launch 内嵌的电机模拟器
    终端启动 HIL 时模拟器由 simulation.launch.py 内嵌拉起，此前不开控制通道，页面
    「仿真」屏的**电机后端**面板对它完全够不着（那块面板只认自己启动的进程）。
    给 sim_control_socket 一个固定默认路径，web_host 在自己没有进程时接管它：可转发
    增删断连，起停仍归那次 launch（进程主人不是它，拒绝再起一个——同一条总线上两个
    模拟器会互相打断）。external_socket 做成可注入参数：否则台架上真跑着 HIL 时
    status() 会答 external，测试就随台架状态红绿。
    顺带更正 simulation.launch.py 里把周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
2026-10-14 docs: 整链静默根因改为适配器采样点；更正 MJCF 力矩/速度上限的表述
    寄存器定案（SWD 后台访存；**不 halt** 才不扰动——加了 halt 会让 SYNC 从 50.0 掉到
    47.0 Hz，不 halt 则 705 个采样期间恒为 50.0 Hz）：
    静默是那只 SLCAN CANable 以 88.24% 的数据段采样点在总线上当第二个节点，把板子
    每个带数据相位的 FD 帧采样越界 ⇒ 发错误帧、不给 ACK ⇒ 板子 TEC 累加 ⇒ 负载下冲过
    255 进 bus-off。寄存器序列：前导 DLEC=4 + BO=1，静默期定格在 TEC=128、DLEC=3、
    TXBRP=0x0000ffff、FIFO 满。**板子侧一个字节都不该动**——1 Mbps/5 Mbps、81.25%
    是匹配真机 80%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
2026-10-14 fix(micro_ros_agent): 修 FDCAN 模拟器启动即崩的未绑定局部名
    main() 在 CanMotorSim 构造处读 tau_limits，而赋值在后面的 `if args.gazebo:`
    分支里——Python 作用域规则让这个名字在整个函数内成为局部名，于是**任何参数
    组合**都在构造处抛 UnboundLocalError。这个脚本自 5b7e90e 起根本起不来，
    而既有 host 测试只构造类、不执行 main()，所以 295 项全绿也没抓住。
    把解析提到构造之前，并补一条语义为「启动路径不因自身缺陷崩溃」的回归测试：
    子进程跑真脚本、只给确定不存在的设备，断言它失败在 os.open 的
    FileNotFoundError 而不是名字绑定—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
2026-10-14 fix(motor_sim): CERB 的 MIT τ_ff 量化满量程改逐型号
    解码侧写死 11.0（R48 的真值），R58 的前馈因此被按 11/45 缩放（5.0 N·m 解成
    1.222 N·m）。τ_ff 至今恒为 0，所以这个量程不一致一直不可见——而重力前馈正是
    要写这个字段，不先修就会「算法看着对、数值被缩掉四倍」。编码端（主机
    motor_drive 与固件 cerb_adapter）本来就是逐型号的，只有解码侧没有。
    MotorConfig 新增 mit_torque_limit_nm：它是**型号属性**（MIT 定点满量程，
    R48 11 / R58 45），与 plant 的 effort_limit_nm（饱和）既不同义也不等值，
    所以不复用后者。值经 profile 落到协议对象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
2026-10-14 feat(robot_dynamics): 重力前馈——ArmModel、重力矩节点与命令侧叠加节点
    ArmModel：URDF → pinocchio::Model，按关节名给 τ_g。支持子集/乱序/含未知名字
    的输入（/joint_states 的常态）、缺失关节沿用前值，以及无副作用的按名求值
    （轨迹前馈要算未来构型，不能扰动内部状态）。fixture 自带 URDF 并与闭式解
    对照到 1e-12，同时与势能梯度有限差分对照。
    gravity_torque_node 按 ADR 0009 第 1 条：订阅 /joint_states，只填 name 与
    effort 发布 /robot_dynamics/gravity_torque，不含门控与超时——那是叠加侧的事。
    gravity_feedforward_overlay 夹在命令源与固件之间的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
2026-10-14 feat(micro_ros_agent,web_host): 命令源的下行话题可覆盖
    重力前馈的叠加节点只能插在主机侧：micro-ROS Agent 是自研 CLI，main.cpp 显式
    丢弃 --ros-args、没有 remap 能力，固件侧话题名又是编译期常量（节点命名空间
    恒为空）。所以「夹在中间」只能靠把命令源指到中间话题。
    两个台架工具加 --command-topic / --trajectory-topic，web 前端加
    ?command_topic= / ?trajectory_topic=（与既有的 ?joints= 同属「非常规接线与
    排查」那一类）。默认值一律不变，不启用前馈时行为逐字相同。
    顺带更正 snapshot_stream.py 里过期的 QoS 注释：2026-10-15 用
    `ros2 topic info -v`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
2026-10-14 fix(micro_ros_agent): step 模式的步进目标改为进场时算定的绝对值
    步进目标本来是「保持位姿 + step_rad」逐拍算的，而重新武装分支每 0.5 s 会把
    保持位姿重置为**当前实测位姿**——那是有意为之（对着抖前的旧目标重新发力会
    让机构弹回去）。两者一叠加：只要有任何一台进不了运行态，目标就永远跑在关节
    前面，变成持续漂移直到撞限位。2026-10-15 台架实测抓到 m1 目标
    +0.229 → +0.530 → +0.874 rad 而关节跟在后面追。
    进场时一次性算成绝对值即可，重新武装仍按老语义重置保持位姿。
    顺带让状态行打印的目标与下发值同源（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
2026-10-15 feat(bench_msgs,bench_manager,web_host): 台架进程管理迁出 web_host 为 ROS 服务
2026-10-15 docs(adr): 接受 0012 并更正其论据；补 §3b 电机后端自成一包
    0012 的 Context 称 Python 后端「1770 行、无单测」，与代码不符——实为 1851 行，
    且已有 523 行 / 121 条 assert 的 CTest 断言（micro_ros_firmware/test/host/
    test_fdcan_motor_sim.py，经 test/host/CMakeLists.txt 注册）。删 Python 的代价
    因此被低估：不是「没有测试可丢」，而是「契约测试寄居在另一个区域、且断言无法
    复用到 C++，必须逐条重表达为 gtest」。更正后转 accepted。
    §3b 记录用户裁定：电机后端归 motor_sim 包自己的 launch，bench_manager 改为起它、
    不再经 robot_sim/simulation.launch.py；web 仿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
2026-10-15 feat(motor_sim): 总线配置承载传输类型、端点与串口参数
    ADR 0012 §2 要求配置单源。buses 原先只存总线名，端点与传输类型留在 ROS 节点参数
    里，于是同一个事实有两个宿主、改一次总线要改两处。本步先把它们搬进 YAML 并逐项
    校验（形状、取值域、端点唯一），由下一步让节点真正从配置读取。
    core 层不链 motor_transport，故传输类型用自定义枚举 BusTransport，由 ROS 层映射；
    串口位率白名单一并从 ROS 层的参数校验搬来——它是配置取值域，不是运行期环境事实。
    旧的 buses: [arm] 形状明确报错，不做双形状兼容：唯一的生产者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
2026-10-15 refactor(motor_sim): 总线端点改由配置决定，节点不再收总线类参数
    transport_mode / <bus>_port / baud_rate / allow_external_canfd 四个节点参数是同一
    个事实的第二个宿主，改一次总线要同时改 launch 与节点。删掉它们，launch 只传
    config_file；环境校验（设备存在、能开成 tty、接口存在、端点唯一）从参数搬到
    配置驱动，语义不变。顺带让各总线可持有不同传输类型（多总线混合 socket_can 与串口）。
    serial_slcan 必须显式 allow_external_canfd 的守卫从 ROS 层参数校验搬进 core 配置
    解析——它防的是误选真实 CANable 所在的物理总线，搬丢就是静默接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
2026-10-15 feat(motor_sim): timing 承载逐台反馈周期、相位错开与力矩更新率
    ADR 0012 §4 块 2 要把反馈节拍从全局单拍改成逐台并错开相位，这几个字段是它的配置面。
    can_period_ms 与 control_hz 不同义：前者驱动总线收发节拍，后者驱动控制节拍。
    缺省值一律等于旧行为（0 = 沿用既有节拍），所以本步不改变任何运行行为——消费方是
    后续的反馈调度增量。校验用新写的 optional_unsigned / optional_nonnegative_double：
    既有 positive_unsigned 要求 > 0，而这里 0 有语义。
2026-10-15 feat(motor_sim): 配置可覆盖 CERB SDO 易失对象初值
    真机的保护开关 0x2650:00 与方向 0x2541:00 不落盘，上电即回初值，"进程重启 =
    掉电复现"。要让台架复现「保护被关掉」这类场景，只能把初值做成配置。
    缺省取真机实测初值（保护 1 / 方向 0），所以不写该字段的既有配置行为不变；消费方
    是后续的 SDO 从站增量。两个对象都只接受 0/1，越界在加载期就报错。
2026-10-15 feat(robot_sim): launch 把逐台反馈节拍与 SDO 初值覆盖写进 motor_sim.yaml
    配置单源的最后一环：这两组字段此前根本没有宿主，缺了它们后续的反馈调度与 SDO 从站
    就没有配置面。
    取值一律镜像 Python 后端 CLI 的缺省（--period-ms 20 / --fb-period-ms 0 /
    --stagger-ms 2.2 / --effort-rate-hz 200）：ADR §5 第一步的验收是改前改后的帧级对照，
    把 feedback_period_ms 钉成 20 而不是 0 会让 --period-ms 改动时两端分叉。
    sdo_overrides 缺省取真机初值（保护 1 / 方向 CW）。
2026-10-15 fix(motor_sim,robot_sim): 整分支复核轮——漏改的 launch、无通路的字段、节拍缺省
    全新 context 的复核给出 5 条 Important，逐条修：
    1. motor_sim 自己的 launch 仍在声明并转发 transport_mode / baud_rate /
    allow_external_canfd，而节点已不再声明它们——rclcpp 对**未声明**参数的覆盖是
    静默忽略，照它 docstring 传参的人会以为生效、实际节点改用 YAML 里的端点，可能
    静默绑到另一条总线上。删掉三者与转发，docstring 改为端点写在 buses[]，并补一条
    扫包内 launch 的回归测试。
    2. launch 写出的 sdo_overrides 用 motor.get(...)，但拓扑、motor_driver.yaml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
2026-10-15 docs(adr): 0012 §2 补两条落实口径——节拍缺省取旧行为、sdo_overrides 暂无输入通路
    这两条是增量 1 落地时定的边界，审查者建议并入 ADR，否则增量 3/4/6 会各自重新猜一遍：
    节拍缺省取 0（= 沿用旧行为）而不是 Python 的 20/2.2/200，Python 数值留待 firmware 分支
    由拓扑显式声明；sdo_overrides 本增量只有 schema，launch 写真机初值常量而非 motor.get(...)。
2026-10-15 feat(motor_sim): 型号库承载 CERB 设备身份串与 SDO 出厂值
    固件靠 0x1008 身份串绑定型号、靠 0x6080/0x2538 回读核验，这三样此前只以硬编码
    常量存在于 Python 模拟器里（fdcan_motor_sim.py 的 CERB_DEVICE_DEFAULTS）。要让
    C++ 侧成为合格的对端，它们得有权威宿主——型号库是静态参数的宿主。0x6080 是模块
    侧共用值（R48/R58 同为 3325），逐型号的是 0x2538。
    字段在 profile 段可选、在 motors 段对 cerb 协议强制：profile 解析被 vaxor 共用，
    在那里强制会让非 CERB 配置也要求身份串。
2026-10-15 feat(motor_sim): 新增 CERB SDO 从站内核（快速读写与分层中止码）
    固件靠 SDO 读身份串绑型号、靠写后读回核验参数表；缺了这一块 C++ 节点在台架上
    无法替代 Python 模拟器（ADR §3b 的两项先决条件之一）。服务与传输无关：只把一条
    8 字节请求变成一条 8 字节应答。
    中止码按真机语义分层——索引不在字典回 0x06020000、索引在而子索引没有回
    0x06090011；一律回后者会抹掉对端的这一层语义。易失对象的初值来自配置的
    sdo_overrides，那是复现「保护被关掉」这类真机场景的唯一手段。
2026-10-15 feat(motor_sim): SDO 从站支持 0x1008 身份串的分段上传
    身份串是固件按串绑定型号的唯一依据；字节格式必须与 cerb_adapter 对向，否则台架上
    全部电机停在未绑定，而构建与既有测试都不报错。取段游标按节点保存、每次 initiate
    重置——不复位会让同一节点第二次上传读到空串。
2026-10-15 feat(motor_sim): 节点把 0x600+node 的 SDO 请求接给从站应答
    SDO 是独立的一问一答命名空间，不能流进 MIT 路由——否则一条身份查询会被当成畸形
    命令。应答与原请求同 BRS，不改成经典帧：固件侧 SYNC 之外的 FD 帧都经过数据相位，
    擅自降级会让链路表现不一致。
2026-10-15 docs(adr): 0012 §4 块 1 写明 SDO 中止码是分层的
    原文只提「不存在的子索引回 0x06090011」，读起来像"一律回这一条"。真机是分层的
    （索引不在字典回 0x06020000），一律回后者会抹掉对端的这一层语义——照原文实现
    出来的就是那个错。补上另一半，免得后来者按字面把分层简化掉。
2026-10-15 feat(web_host): 电机后端面板加接口选择，与仿真抽屉同值
    面板原先没有自己的输入控件：要起电机后端得先把上方「仿真」抽屉的模型 / 传输 /
    端点配全，而"只连板子单独起停"正是这个面板的用法之一，绕这一圈没必要。
    加的是**同一份值的第二个入口**，不是第二份配置：宿主仍是 ui.transport /
    ui.simInterface / ui.simTty，镜像的改动写回宿主后走同一个 syncFields()（清物理
    总线确认、重列模型、落盘全一致）；不新增 localStorage 键，不动
    StartMotorBackend.srv 与 motor_sim_manager 的校验。
    三个 select 加 aria-label：标签文字与上方逐字相同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
2026-10-15 fix(bench_manager,web_host): 物理总线上的仿真永远起不来——确认位没进请求
    a638892 把台架进程管理迁出 web_host 时，新 simulation_manager._validate 给非 vcan
    分支加了"确认物理总线没有真机电机"的放行条件，但 StartSimulation.srv 没有承载它的
    字段、_simulation_request 也不搬它——这个条件在仿真路径上恒为假。于是 socketcan /
    slcan 下 host / external / firmware 三种模式**全部**被拒，只有 vcan 能起。现场表现
    就是点「启动仿真」报 confirm that the physical CAN bus has no real motor load，
    而勾选框明明是勾着的。
    既有测试都直接构造请求 dict 并预先塞好这个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
2026-10-15 feat(bench_manager): 新增 systemd 调用层（台架会话唯一的 systemd 缝）
    会话进程要从 Popen 子进程改成 systemd user transient unit，起停与状态查询就全是外部
    命令调用。收成一个可注入 runner 的模块，单测才能在不启真 systemd 的前提下覆盖认领、
    复用、失败态这些分支——CI 与容器里往往没有 user manager。
    三条实测事实决定了这里的形状（2026-10-16 本机核过），每条都配了测试：
    - 不存在的 unit 与「干净停过」的 unit 在 ActiveState 上逐字相同（都是
    inactive/dead/ExecMainStatus=0），必须一起看 LoadState，否则「从未创建」被误报成
    「已停止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
2026-10-15 refactor(bench_manager): Agent 改由 systemd unit 承载，启动前查设备占用
    Task 2 第一半（三个 manager 里的 Agent）。起停从 Popen/killpg 换成 systemd-run /
    systemctl stop，状态从 poll() 换成 unit 状态；校验、枚举、命令行构造原样保留。
    顺带补上实测踩到的那个坑：串口没有 O_EXCL，两个进程能同时打开同一个 tty 互相抢
    字节。上一次会话留下的孤儿 agent 占着设备时，新起的 bench_manager 一无所知、照起
    第二个——现在启动前扫 /proc/<pid>/fd 找持有者，找到就拒绝并报出 pid。
    会话描述（DEVICE_ENV）随 unit 持久化：以前 device 活在 manager 内存里，进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
2026-10-15 refactor(bench_manager): 仿真与电机后端也改由 systemd unit 承载
    三个 manager 至此同构：状态权威是 unit（`probe`），会话描述随 unit 环境持久化
    （`config_env`/`config_from_env`），停止交给 systemd 默认的
    `KillMode=control-group`。删掉 Popen / poll 轮询 / 日志 deque / killpg / external
    接管分支——它们全是「父进程持有子进程」这套模型的产物。
    为什么状态不能再用 poll()：unit 化之后进程不再是本节点的子进程，poll 无从谈起；
    而 unit 状态还免费给了单写者所有权（重名 unit 建不出来）与失败退出码。
    两条本次实测、写进 systemd_units docstring 的事实：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
2026-10-16 feat(robot_bringup,bench_manager,web_host): 台架唯一入口 + 会话日志按需拉
    Task 3-6 一次落地，并把现场验证踩到的三处缺口补上。
    **robot_bringup（新包）**：`robot.launch.py` 是「起一套台架」的唯一入口——
    include `web_host.launch.py`（L1：rosbridge + 静态页）+ `bench_manager`（L2，
    `LifecycleNode`）。仓库没有 lifecycle_manager，用 launch 事件串 configure → activate
    （`OnProcessStart` 发 CONFIGURE，进 inactive 后发 ACTIVATE）。`web_host.launch.py`
    随之退回纯 L1：删 `start_bench_manager` 与 `exec_depend bench_manager`——声明它反而
    会成环。
    **bench_manager lifecycle 化**：`on_configure` 只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
2026-10-16 feat(micro_ros_agent): 新增 tools/can_up.sh —— 一条命令把 CANable 配到台架位时序
    台架位时序是**每插一次就要重配一遍**的（适配器自身不存，含 USB 重新枚举），而
    `docs/guides/fdcan1-bench-guide.md` 里那三条 `ip link set` 要手打、还容易漏掉
    `txqueuelen 200`（gs_usb 默认 qlen 10，负载下溢出发 ENOBUFS）。收成脚本，顺手把
    「位时序只在 DOWN 下可改（UP 时改报 EBUSY）」这条非直觉约束放进无条件先 down 里，
    重复执行是安全的。
    数据段采样点取 0.8125 而非 0.8：160 MHz 下 5 Mbps 只有 32 tq 一种分法，80% 要 25.6 tq，
    整数取不到——理由与实测见指南的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
2026-10-16 chore(firmware): 忽略厂商 DM-MC02 例程目录
    `docs/dm-mc02例程/` 是厂商随货给的参考资料，只作本地查阅，不入库。
2026-10-16 feat(robot_dynamics,bench_manager,web_host,motor_command): 重力前馈一键开关 + 主机侧命令节拍
    新增 ADR 0013 追认 τ_g 叠加路径的落地边界与所有权，取代 0009 的决定 2、3、5。
    bench_manager 把 gravity_feedforward_overlay 托管为第四个案台 unit，
    web 运行屏新增「重力补偿」开关：先起节点确认 running，再把本页面下行切到
    /robot_dynamics/*，关时反向；断链不自动回退，给大红告警与一键回退。
    - bench_msgs：新增 Start/StopGravityFeedforward 与 SetGravityFeedforwardGain
    - bench_manager：新增 gravity_feedforward_manager 与三个服务，状态加一段
    - web_host：新增 feedforward 面板与 s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
2026-10-19 docs(adr): 新增 0015 —— 固件消息流收敛为三平面（PDO/SDO）
    现状是 5 下行 + 10 上行话题并列在同一层，四个缺陷各自在台架上以具体故障出现过：
    同拍多发让 best-effort 静默丢（imu/data 每拍都发，是常态不是偶发）、48 台以上
    运动/状态消息越 512 B MTU、循环面与非循环面混在一层、schema_version 只在 topology 上
    导致两端镜像不同步时静默按旧布局解析。
    ADR 定住三平面收敛、WireContract.msg 作话题名与定点量程的单一来源、循环面 480 B
    永不分片、主机侧 micro_ros_bridge 作唯一边界节点。安全裁决语义一律不变，只换编码
    与承载。只取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
2026-10-19 feat(can_bridge_msgs): 新增 WireContract —— 线上契约常量的单一来源
    话题名、定点量程、哨兵、schema 版本与 QoS 类别码集中成一份 .msg 常量，
    两端只引用生成常量，消掉「拼错话题名」与「量程各写一份」两类故障。
    本消息从不发布，只作常量载体。
2026-10-19 feat(can_bridge_msgs): 新增循环面 LowCommand / LowState
    SoA + int16 定点，count=64 时各 480 B，落在 best-effort 可用 MTU 内。
    带 state_age_ms / target_source 会涨到 680 B 而被迫分片，故两者让位给
    低频状态面；low_state 用哨兵表达「本拍无有效测量」。
    facade 的 MotorMotionStateArray 末尾追加 seq：low_state.seq 是主机侧唯一的
    丢帧判据，不给它落点就等于解码时丢掉。
2026-10-19 docs(can_bridge_msgs): 循环面消息注释改回意图口径
    原注释写了设计论证、变更沿革与实测算术（680 B / 528 B），违反
    CLAUDE.md 的注释纪律；这些内容在 ADR 0015 决定 4 与 spec §4.2/§4.3
    已有宿主，一处事实只写一处。
    顺带补回 spec §4.2 要求的逐字段单位注释（rad / rad/s / N·m），
    并给 LowState 的 count / motor_ids 补齐与 LowCommand 对称的说明。
    WireContract 头部同样去掉实测沿革与论证句；常量一字未动。
    仅注释改动，字段与生成类型不变。
2026-10-19 feat(can_bridge_msgs): 新增低频状态面 MotorStatus
    合并 MotorStatusArray / MotorTrajectoryState / SystemStatus / MotorDiagnostics
    四条的字段，10 Hz reliable。逐台布尔打包成 status_flags、state_age_ms 与两个
    flags 字段收窄，把 64 台时的体积压到约 2 KB（4 分片）。枚举取值沿用保留消息，
    不重新定义。
2026-10-19 feat(can_bridge_msgs): 新增配置面 ConfigRequest
    把 ParamSetArray 与 SystemCommand 合成一条，用 kind 区分、两组字段互斥。
    targets 上界 16 沿用内核配置 FIFO 容量约束；command / motor_id 取值沿用
    SystemCommand 的常量，不重新定义。
2026-10-19 test(firmware): 线上契约的编译期门禁
    low_cmd / low_state 的 CDR 序列化尺寸（不是 sizeof）压在 490 B 以内，
    哨兵与电机数上界一并钉死。越界在 pio run 就失败，而不是等台架上丢帧。
    量程与话题名不在此断言：rosidl 的 C 侧常量不是 C++ 常量表达式，
    它们由主机侧契约用例按精确值钉住。
2026-10-19 feat(firmware): 新增 lib/wire_codec —— 定点编解码的固件侧唯一换算点
    ±full-scale 用 32767 而非 32768，把 -32768 整个留给哨兵；越界饱和并置位
    （而不是拒收——量程选错应当看得见）；恰好落在满量程不算越界，不置位。
    非有限输入给哨兵，命令路径的 NaN 拒收仍由调用方负责。
    golden 向量与主机侧 C++ 用例同值互钉；哨兵的第二份副本由契约门禁
    static_assert 钉住，两份漂移即编不过。
2026-10-19 feat(micro_ros_bridge): 新包骨架与契约测试
    常量别名全部取自 WireContract.msg，不写第二份数值；同时钉住旧 facade 消息
    里那套枚举的取值，避免页面与固件对同一台电机的解释漂移。
    本包尚未接线任何 launch。
2026-10-19 feat(micro_ros_bridge): 主机侧定点编解码与 golden 向量
    与固件 lib/wire_codec 同式同向量（两边注释互指），越界饱和、非有限给哨兵。
    换算集中在 codec 里，控制逻辑仍用 SI 单位。
2026-10-19 feat(micro_ros_bridge): 消息级编解码
    整条受理或整条拒绝的口径与固件旧契约逐字一致（先全量校验再写输出，
    不留半条）；命令路径的 NaN/Inf 整条拒收；越界饱和计数回给调用方。
    state_age_ms / target_source 出自 10 Hz 的 motor_status，经 freshness 出参交给
    bridge 缓存，再由它盖章进 motion_states——页面读的是那里的这两个字段。
2026-10-19 fix(micro_ros_bridge): 消息级编解码的越界索引与守卫可达性
    decode_motor_status 用帧里的 motor_id（uint8，0..255）索引定长 64 的 freshness
    缓存，越界 id 会越界写；这座桥是信任边界，改为任一条越界即整条拒收，并补一条
    用例真正覆盖该守卫。
    encode_low_command / encode_config 的 count 上界守卫经 ROS C++ API 不可达
    （BoundedVector 封顶 size + 长度守卫先短路），加注释说明其为纯防御；把名不副实
    的 OverCapacity 用例改名为它真正覆盖的重复项 + 长度守卫。
2026-10-19 feat(web_host): 命令节拍迁到主机侧，接线 command_streamer 与运行期改道
    页面失焦后台定时器被钳到 1 Hz，而固件快照新鲜度线是 30 ms 软停 /
    100 ms 失能，页面一失焦台架就整臂掉力。按 ADR 0014 落地：
    - web_host.launch.py 起 command_streamer（真声明 motor_command 依赖）；
    - 页面只发 /motor_command/setpoint，删除 100 Hz 连发与切屏停发，
    「下发」改为持续保持、新增「停止」（空目标 = 全部软停）；
    - command_streamer 的 output_topic 改为运行期可改，下一拍换发布者；
    - bench_manager 的两个前馈服务顺带改道，起时先确认 running 再改道、
    停时先改回直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
2026-10-19 feat(micro_ros_bridge): 接线桥节点，落到线上契约两端
    新增 BridgeNode：主机侧 /motor/* 与线上 /micro_ros/* 的唯一翻译点。
    下行命令与参数走 encode_* 整条编解码，失败整条拒收；上行 low_state 与
    motor_status 走 decode_*，并缓存低频面的新鲜度用于 50 Hz 盖章。
    QoS 按消息性质而非业务域统一选取，透传链路用类型擦除持有订阅与发布，
    避免构造完即析构。schema_version 不一致时按 ADR 0015 决定 8 拒绝下发。
    CMake 目标名与产物名分离，规避 CMP0002；同时新增节点接线测试。
2026-10-19 fix(micro_ros_bridge): 桥节点 on_command 改用完整消息命名空间
2026-10-20 chore: 移除误入桥节点提交的仿真导出文件
    保留工作区原始文件，只从功能分支版本中撤销无关模型目录。
2026-10-20 fix(micro_ros_bridge): 完整限定状态消息类型
    避免 MotorStatus 回调依赖隐式 using 声明，明确线上与 facade 消息类型。
2026-10-20 fix(micro_ros_bridge): 修正消息方向与状态门禁
    policy 和 trajectory 原先反向接线，主机下发无法到达线上；low_state 越界 ID 可使新鲜度缓存越界，畸形或 schema=0 状态还可错误放行命令。以端到端和消息级红测复现后修正方向、整帧校验和有效状态门禁，并补齐 QoS、定点与包文档。
2026-10-20 fix(micro_ros_bridge): gate policy and trajectory on peer schema
    Valid mismatched MotorStatus already blocks low_cmd and config, but policy and trajectory were still forwarded to the wire. Apply the same peer schema gate to both host-to-wire pass-through callbacks and document the full downlink scope.
2026-10-20 fix(can_bridge_msgs): 线上话题前缀改下划线形式
    /micro_ros_do 与 /micro_ros_up 保留 do/up 方向语义，但分隔符与固件现有
    字面量一致（下划线），切流时 IMU 等透传话题无需改名。契约测试改为按方向
    逐条钉住前缀，防止话题被挪到反方向。桥 README、ADR 0015 与设计稿同步。
2026-10-20 feat(firmware): 下行命令改订低层契约 LowCommand
    motor_bridge 的完整快照订阅从 MotorCommandArray 切到定点的 LowCommand，
    解码只经 lib/wire_codec；形状校验（count 与四组数组自洽）抽成纯函数进
    host 测试。policy / trajectory 同时改用 WireContract 常量名。上行未动。
2026-10-20 feat(firmware): 参数写与系统命令合并到 ConfigRequest
    param_bridge 的两条订阅收敛为一条 micro_ros_do/config：kind 决定参数组或
    命令组，两组混装整条拒绝。整条校验/分发改成收数组指针，系统命令处理抽成
    显式参数；kind 互斥校验进 host 测试，kind 常量由 static_assert 钉住。
    顺带修正 param_bridge.h 头注释：下行话题改引 WireContract 的 TOPIC_CONFIG，
    策略话题引 TOPIC_POLICY，不再重复会漂移的字面量。
2026-10-20 feat(host): 命令源统一落到 bridge 的 /motor/* 入口
    页面、命令节拍器、重力前馈叠加、台架脚本与 ros2_control 适配桥不再直发线上
    话题。命令输出 QoS 改 reliable：bridge 与叠加节点的订阅端都是 reliable，
    best-effort 发布在 ROS 2 里不建连接。上行话题保持不变。
2026-10-20 feat(robot_bringup): 台架入口常驻 micro_ros_bridge
    下行编码者随 L1 起，与 command_streamer 同层。补一条静态 launch 测试钉住
    节点与可执行名，避免改名后「页面有话题、命令没人编码」。
2026-10-20 docs: 下行切流后的唯一话题表与验收口径
    固件 README 写新的四条下行契约；主机 README 写各自的新入口；台架指南的
    命令示例改到 /motor/*。上行表暂留旧名，S4 再改。
    顺带修掉三处仍指向旧下行名的源码注释（web 策略面板、robot_dynamics 测试
    fixture、firmware_topic_bridge 的 QoS 说明），并同步包数（十一包 → 十二包）、
    固件 AGENTS 的参数面口径与 platformio.ini 的订阅计数。
2026-10-20 docs: 台架指南补 bridge 前置
    启动顺序新增 micro_ros_bridge 一步，参数写/保存示例前注明 bridge 必须已在跑；
    只起 Agent 时 /motor/* 无人订阅，--once 会静默失效。用 robot.launch.py 起台架时
    L1 已常驻 bridge，注明不要再起第二个以免重复处理命令与状态。
2026-10-20 fix(firmware): 配置面 SAVE 哨兵常量化并加漂移断言
    PARAM_SET 分支原来直接比字面量 0，读代码看不出它指的是 SystemCommand 的
    COMMAND_SAVE，改 .msg 时也没有东西拦住漂移。改成命名常量
    WIRE_CONFIG_COMMAND_SAVE，与 kind / motor_id 一样由 wire_contract_check.cpp
    的 static_assert 钉到生成常量上。
    顺带补齐 param_bridge 里 A→N·m 预校验的意图注释、两处续行缩进。
2026-10-20 docs(can_bridge_msgs): 钉住 ConfigRequest 哨兵值，改正 DeviceParamReport 写侧话题
    ConfigRequest 原写「另一组必须为 0/空」，但编码端实际写的是
    command = COMMAND_SAVE(0)、motor_id = MOTOR_ID_NONE(65535)——照字面理解会把
    每条合法参数写都拒掉（0 是合法电机 id）。改成写死值并点名取值来源。
    DeviceParamReport 的写侧对偶仍指着已不存在的 /micro_ros_do/param_set，改为
    /micro_ros_do/config 的 kind=PARAM_SET；发布时机的 SystemCommand(COMMAND_REPORT)
    同理改成 ConfigRequest 形式。
    只改注释，生成类型不变，无需刷新 libmicroros。
2026-10-20 fix(micro_ros_agent): bench_up.sh 起 micro_ros_bridge
    traj_play.py / snapshot_stream.py 现在发主机侧 /motor/*，bridge 不在跑时命令与
    轨迹静默落空（话题有人发、没人编）。台架脚本自己起一个，并说明用
    robot.launch.py 时 L1 已起、勿重复。
2026-10-20 test(robot_bringup): 钉住台架入口只有一个下行编码者
    节点名或可执行名一改，「页面有话题、命令没人编码」是静默的；两个编码者则会
    互相覆盖命令流。两种都拦住：断言恰好一个，且节点名是固件侧约定的
    micro_ros_bridge。
2026-10-20 test(web_host): 只有 URDF 的预览件不参与臂视图映射断言
    robot_leg 是只有 URDF 的 SolidWorks 导出件：臂视图候选的判据只有主 URDF，会
    把它列出来，而 motor_id → 关节映射另要 config 里的一份文件，于是两个集成用例
    报红——但页面本来就会退回内置兜底表，这不是错误。
    放宽只针对「压根没配」：新增 has_joint_mapping_source 区分没配与配错了，配了
    文件却解析不出来的仍报红；两个集成用例再加计数断言，避免放宽之后空转。
2026-10-20 docs: 下行切流后的 bridge 前置、槽位与包数口径
    - bench_up.sh 现在起 bridge，各处的启动说明补上「下行命令/轨迹需它在跑」；
    - 订阅槽位 5/6 → 4/6（两条订阅合并为 ConfigRequest 后的实测值，含
    check_microros_config.py 的后果提示）；
    - 根 README 与 AGENTS.md 的包数 7 → 12；
    - 重力前馈的「输出只有固件订阅」改为「由 bridge 转发、bridge 之后没有固件
    消费」——多了一层，原话不再准确；
    - web_host README 补两个判据故意不同的后果：候选里有没配映射的预览件。
2026-10-20 feat(robot_sim): 新增 robot_leg 单腿预览模型
    SolidWorks 导出的单条腿（6 个主动关节 + 一段平行四边形张合连杆，1:1 mimic
    跟随），只做到可视化预览：导出件的关节限位全是 0/0/0/0，6 个关节暂写
    continuous 只为滑杆能拖；effort/velocity/dynamics/碰撞体与 xacro、控制器、
    仿真拓扑一概未补，也没有与真机核对过电机型号。
    因此**不是契约模型**：四个 launch 里只有 display.launch.py 能用它，
    test_model_consistency.py 的契约断言按「有 urdf/<名>.urdf.xacro」收模型，不收它。
    cad/ 是原始导出件，几何/惯量/关节原点与轴以它为准，只读不改。
    robot_sim REA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
2026-10-20 docs: 固件消息流 S3（下行切流）实现计划
    与 2026-10-19 的规格/一号计划同一批：规格定架构，计划定逐任务的
    红-绿-提交步骤。本阶段只切下行，上行留到 S4。
2026-10-20 feat(robot_sim): robot_leg 重建为契约模型，新增 zhoubuguanjie_youbi_001
2026-10-21 fix(motor): CERB 型号参数按厂家修正，Iq 刻度改为 20 mA/码
    - Kt/效率/ MIT T_Max 更新：R58 0.067 N·m/A / 75%，R48 0.1 N·m/A / 50%，两型号 T_Max = 300 N·m
    - 反馈 Iq 由 1 mA/码改为 20 mA/码（真机扫描反推），固件、motor_drive、motor_sim、fdcan_motor_sim 四处统一
    - motor_drive CERB 反馈换算补乘 gear_efficiency（此前只有 vaxor 乘）
    - 型号库、真机与仿真拓扑、fixture、docs 同步，host/ros2 单测更新
2026-10-22 feat(cerb): MIT 五项量程按厂家指南下沉型号库，高节点经 0x210 聚合上线
2026-10-23 chore: 保存 Web 重构前的资料与项目配置
    保存 CERB 设备参考更新、机器人操作面板调研和子代理路由配置，为独立 Web 重构分支建立完整基线。
2026-10-23 feat(web): 添加三场景工作台交互原型
    使用 Vue、TypeScript 和真实 URDF/YAML 比较均衡、3D 优先与表格优先布局，验证跨场景对象上下文、动作预览和模拟会话流程。所有控制仅修改原型内存，不接入 ROS 或设备。
    验证：类型检查与 Vite 构建通过；现有 web_host 63 项测试通过；浏览器验证九种布局与场景组合、三模型和三种响应式宽度。
2026-10-23 feat(web): 落地 A 布局工作台并接入真实控制模块
    新增 Vue/TypeScript 静态工作台与原生面板适配层，统一三场景对象选择、检查器和观察区。切页保留草稿；关键面板失败阻止连接，渲染错误保留脏标记并有限重试。
    修复模型映射竞态和 WebSocket 重连状态串用；动作播放绑定连接代次，断线后不跨会话继续下发。补充构建门控、ADR 和浏览器测试。
    验证：前端类型检查与构建通过，Vitest 16 项、Playwright 5 项及 web_host colcon 65 项测试通过；独立审查问题已修复并定向复核。未做真机操作验证。
2026-10-23 feat(web): 新增主机限位检查，手动目标与动作播放越界即拒绝
2026-10-26 feat: initialize robot2 workspace
    Capture current firmware, ROS 2 stack, web workbench, and hardware documentation.
2026-10-26 feat(web): 优化工作台布局并替换旧命令历史面板
    新增 Vue 命令记录，删除独立 prototype 和旧 history 面板。
    整合侧栏折叠、面板尺寸调整、曲线交互和串口选择改进；取消外层滚动并保留内部滚动。
    补充前端及安装契约测试。单测和 Python 测试通过；浏览器全量回归仍有传动组切换和分隔线调整波动，传动组独立复测通过。
2026-10-26 chore(docs): 忽略本地 superpowers 设计与计划
2026-10-26 chore: 忽略 .vscode/ 及本地代理与 AWS 配置
2026-10-26 feat(firmware): 统一电机容量与控制周期配置源
    新增 lib/firmware_config 作为注册容量与周期的唯一配置源，
    各库不再硬编码 64 台与 2ms/20ms 周期。
    - 电机容量统一由 FIRMWARE_MAX_MOTORS 约束（默认 48），
    mailbox/内核/TX 调度器/SAVE 事务等容量随之收敛
    - 控制边界改为 FIRMWARE_MOTOR_COMMAND_PERIOD_MS（5ms/200Hz），
    状态上报周期改由 FIRMWARE_MOTOR_REPORT_PERIOD_MS 派生并校验收
    bridge tick 整除
    - 内核参数视图缓冲区改按 PARAM_STORE_RECORD_COUNT 分配，blob 记录
    数断言放宽为覆盖注册容量
    - param_bridge 设备参数结论表按协议节点号范围 1..127 定长，
    移除对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
2026-10-26 docs: 新增固件分层架构与安全停机边界分析
2026-10-27 feat(firmware): 切换到 Agent V3 纯 Topic 契约并重构安全门禁
    - 新增 AgentWireContract 及 13 个 Agent* 消息，线上仅保留 3 下行 5 上行话题
    - 固件侧引入 agent_control_gate、trajectory_transaction、clock_health、info_page
    与 config_transaction 重构，命令/策略/轨迹均以绝对截止与显式 ACK 结算
    - 轨迹终态改为软停（active=false/completed=true），任一目标失去授权即整条中止
    - 温度改为 sensor_msgs/Temperature，并按真实采样时间戳发布
    - 主机桥改为 V3 适配层；bench_manager 并入 robot_bringup，移除独立包
    - 新增消息容量、在线契约、时钟健康等宿主测试与架构文档
2026-10-27 feat(firmware): 通过标准 ROS 参数服务提供可在线调整的系统频率配置
    - 新增 firmware_settings 纯 C 模块，定义 6 项频率设置的取值范围、
    默认值、SYS2 打包格式，并兼容无控制频率字段的 SYS1 旧布局
    - 新增 firmware_parameters 桥，用 rclc_parameter 低内存模式暴露
    /micro_ros_node 参数服务；修改要求时钟有效、电机失能、无活动轨迹、
    无保存事务，system.unsaved 只读反映未落盘差异
    - 系统配置写入 v3 blob 头部预留区，随整机 SAVE 事务一同持久化；
    storage 任务在加载/保存时接入 settings 的解包与打包
    - 实时任务控制边界、IMU/温度、运动与状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
2026-10-28 feat(firmware): 新增电机 ID/T_max 写入与固件参数主题化配置
    - 固件与适配器新增 SET_T_MAX/SET_NODE_ID 配置事务，写后回读核验，
    ID 冲突检测与重启后按新地址重连，T_max 作为 MIT 力矩上限生效
    - 参数面新增 T_MAX/NODE_ID 槽位（设备槽扩至 8 项），同步 param_store、
    storage_projection、DeviceParamEntry 与前端参数表单，报告回读
    - 固件参数改走 /motor/config_request 与 system_status 回读，
    AgentConfigRequest 新增 SET_FIRMWARE_PARAMETERS，移除参数服务路径
    - 新设备默认不使能、不授权，未授权电平幂等以免中止身份读取；
    参数读取仅在完整回读且核对通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
2026-10-29 feat(ros2_control): 工作台控制入口迁移到主机 ros2_control
    - 新增 MicroRosSystem 硬件插件与 host_trajectory.launch，JTC/manual/gravity 控制器统一由 controller_manager 周期执行
    - 新增 workbench_control 低频适配节点，动作/滑块/手动目标经标准 JTC action 与控制器切换提交，不再向 MCU 上传轨迹
    - robot_dynamics 新增 GravityCompensationController，重力补偿在同一控制周期写入 effort
    - 固件共同运动门新增真实运动反馈 100 ms 检查，SDO 应答不再掩盖测量失效；motion_report_hz 新增 100 Hz
    - 桥新增只读 trajectory_execution 选择与接管 STOP_ALL，host 模式拒绝固件轨迹上传与多命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
2026-10-30 fix(motor-drive): bound SLCAN writes and discard failed transports
    Apply one absolute write deadline across partial writes and EAGAIN. Close failed transports so incomplete ASCII commands cannot be reused; cover the real PTY path and back-pressure behavior.
2026-10-30 fix(dynamics): track freshness separately for every joint
    Require fresh finite measurements for every model dependency. Keep partial feedback, stale stamps and waypoint prediction from refreshing unrelated gravity inputs.
2026-10-30 refactor(description): share robot models independently of simulation
    Move model assets and the motor specification library into robot_description. Resolve meshes, launch defaults and consumers through the shared package, and install the compatible motor-library path from the same source.
2026-10-30 feat(control): enforce expiring MCU authorization across protocol v3
    Pair wire messages, host bridge and firmware lease enforcement in one change. Fence old intent by session and generation, cancel cached trajectories and pending CAN writes on revocation, require explicit re-enable, and preserve MCU sampling times. Keep LowCommand within the 488-byte wire limit.
2026-10-30 feat(robot): add commissioning, supervision and standard MCU motion actions
    Add configuration fingerprints, exclusive control ownership and explicit arming. Bind standard FollowJointTrajectory goals to one-use authorization, monitor MCU feedback and tolerances, and confirm cancellation through fresh disabled acknowledgements. Include typed clients and real DDS runtime regressions.
2026-10-30 refactor(bringup): make the MCU the only real motor backend
    Retire direct-CAN launch and plugin export while retaining official mock hardware tests. Default to managed commissioning and feedback, remap every write ingress including MCU authorization, and reject retired host-controller requests before creating processes.
2026-11-01 Fix JTC validation stalls and preserve wall-clock integration evidence (WIP)
2026-11-01 feat: simplify robot stack and add virtual serial firmware prototype
2026-11-03 feat(workbench): share gravity compensation and streamline UI
    Use confirmed host state for the gravity toggle in continuous follow and
    JTC playback. Separate P/V and effort ownership and stop the session if
    either required controller exits.
    Preserve the 3D scene across layout updates, keep motors ordered by ID,
    remove the simulation joint sidebar, and remove redundant status summaries.
    Validation: targeted host, controller, frontend and browser tests pass;
    independent review completed. Hardware gravity torque remains untested.
2026-11-03 refactor: 精简模型查询代码与工程文档
2026-11-03 feat: 整合机器人模型、通用动作重定向与工程精简
    纳入全身与右臂模型、通用 BVH 映射及动作工作台，退役旧主机直连驱动，统一模型和台架选项查询，并将事件日志迁移为原生 Vue。保留可靠发布策略及宿主回归。
    验证：177 项前端单测、60 项隔离浏览器回归、492 项离线 Python 测试、36 项固件宿主测试通过。10 项依赖缺失/无参数测试跳过，ROS 启动与真机验证未执行；模型安装校验使用临时新安装，未改工作区安装树。
